drinkcat/aq-lcd-grab/firmware/README.md

# aq-lcd-grab firmware

Embassy firmware for the Raspberry Pi Pico 2 W (RP2350) — capture target for
the [display protocol reverse-engineering](../docs/display_notes.md).

Current state: PIO+DMA capture, streaming raw `(pa, pb)` samples to the
host over USB CDC using the tagged wire protocol in
[`docs/wire_protocol.md`](../docs/wire_protocol.md). On each WR rising
edge the PIO captures `{DC, CS, DB15..DB0}` (18 bits, MSB first) into
a 32 KiB DMA ring; the firmware splits each sample into
`pa = DB0..DB15` and `pb = {CS at bit 0, DC at bit 1}`, RLE-compresses
consecutive identical pairs, and ships the byte stream out. The
firmware boots quiet — send `0x01` (START) on the CDC link to begin
streaming, `0x02` (STOP) to halt.

## Toolchain setup

```sh
rustup target add thumbv8m.main-none-eabihf
sudo pacman -S picotool        # /usr/bin/picotool, v2.2.0+

# Grant picotool permission to talk to our app-mode VID/PID (c0de:cafe).
sudo install -m 0644 firmware/udev/71-aq-lcd-grab.rules /etc/udev/rules.d/
sudo udevadm control --reload-rules && sudo udevadm trigger
```

## Flashing

```sh
cargo run --release
```

That's it. The cargo runner is [`scripts/flash.sh`](scripts/flash.sh),
which:

- If the Pico is in BOOTSEL (`2e8a:000f`), just runs `picotool load`.
- If the Pico is running our firmware (`c0de:cafe`), sends a USB reset
  request via the picotool reset interface — the firmware calls
  `reset_to_usb_boot()`, the ROM re-enumerates as BOOTSEL, then we
  `picotool load`. **No button-press, no replug.**
- Otherwise, prints a hint to plug in / hold BOOTSEL.

The first-ever flash still needs a manual BOOTSEL (hold the button while
plugging in), since the picotool reset interface only exists once our
firmware is running.

## Reading the USB stream

After flashing, `/dev/ttyACM0` appears as the CDC device. The on-wire
format is binary (see [`docs/wire_protocol.md`](../docs/wire_protocol.md)),
so don't `cat` it — use the viewer in [`host/`](../host/), which speaks
the START/STOP handshake and decodes the frames.

## Pin assignment

| Pico GPIO | Function | Cable |
|---|---|---|
| 0–15 | DB0–DB15 (16-bit data bus, must be consecutive for PIO `in pins, 16`) | |
| 16 | CS | orange |
| 17 | D/C (RS) | yellow |
| 18 | WR (write strobe — sample trigger) | green |
| 22, 26–28 | spare | |
| 23, 24, 25, 29 | reserved for CYW43 wifi | |

## Notes

### Earlier flashing approach (deprecated)

We previously used `elf2uf2-rs` from git (the crates.io v2.2.0 silently
produced RP2040 UF2s that the RP2350 boot ROM rejected). `picotool` makes
that whole detour irrelevant — it speaks the BOOTSEL protocol directly and
handles family IDs internally.

### Pico 2 W onboard LED

GPIO 25 drives the onboard LED on the original Pico, but on the W variant
the user LED is wired through the CYW43 wifi chip (firmware-blob-loaded).
Use USB CDC output as the "firmware alive" signal.

### Watch your serial reader

If `cat /dev/ttyACM0` shows nothing, it's almost always because the host
opened the tty after the firmware already printed its startup messages —
the kernel doesn't buffer pre-open output. Start the reader first, then
power-cycle / re-flash the Pico.
