drinkcat/aq-lcd-grab/docs/pcb_spec.md

# Capture PCB — Design Spec

Working spec for an inline capture board: sits between the target device
main board and its LCD via two 39-pin flex connectors, taps the
display bus into an STM32F103C8T6 for capture, and hosts a Xiao
ESP32-C6 for WiFi-side processing and as the STM32's program loader.

Status: draft. Decisions captured below; open questions at the bottom.

**Capture MCU history:** the prototype was a Pico 2 W (RP2350) using
PIO + DMA. The PCB design briefly targeted a bare RP2350 in flashless
UART-boot mode, then was redrawn for STM32F030C8T6 (JLCPCB basic
library, internal flash → drops UART-boot complication), then refined
to **STM32F103C8T6** because the F103 is also JLC basic-library at
~$0.10–0.20 more, with 20 kB SRAM vs 8 kB and a Cortex-M3 vs M0 — a
material reduction in bring-up risk for the same form factor. See
"Addendum: STM32F030C8T6 considered, rejected" below.

## Overview

```
                  +-------------------+
   main board     |    Capture PCB    |     LCD
                  |                   |
        flex 39p  |  STM32F103C8T6    |  flex 39p
   ============== | passthrough + tap |==============
                  |                   |
                  |  Xiao ESP32-C6    |
                  |  (loader + WiFi)  |
                  +-------------------+
                            |
                       3-pin to main
                       board (3V3/GND/
                       PIC32 reset)
```

## Decisions

### MCU: STM32F103C8T6

- **JLCPCB basic-library part** — no extended-part assembly fee, no
  reel cost, always in stock. The primary reason for choosing STM32
  over RP2350.
- **Package:** LQFP-48, 7×7 mm body (9×9 mm with leads). Larger
  footprint than the RP2350 QFN-60, but no external SMPS inductor,
  polarised cap, or QSPI strap network is needed, so net board
  area is comparable.
- **Resources:** Cortex-M3 @ 72 MHz, 64 kB flash, **20 kB SRAM**,
  7 DMA channels, USB device, USART1 ROM bootloader on PA9/PA10.
  Pin-compatible with the F030C8T6 we briefly considered (same
  LQFP-48 pinout, same GPIO/USART/TIM1 layout for the pins we
  use).
- **Clocking:** internal HSI (8 MHz) × PLL → 64 MHz max on HSI/PLL
  (DS5319 Table 7 note 1). **No external crystal needed**: AN2606
  confirms the F103 ROM bootloader auto-bauds on HSI; we don't use
  USB (which would require HSE for the ±0.25% clock spec). HSI
  accuracy at 0–70 °C is ±1.3% to ±2% (DS5319 Table 24) — well
  within UART tolerance (~±2% per char at 8N1) at our baud rates.
- **Power:** single 3V3 rail. VDD/VDDA both 3V3 with 100 nF per pin
  + a 4.7 µF bulk near VDDA. No SMPS, no ferrite bead.

#### Addendum: STM32F030C8T6 considered, rejected

The F030C8T6 was the first STM32 picked for this board — same JLC
basic-library status, ~$0.10–0.20 cheaper. Switched to F103C8T6
because:

- **20 kB SRAM (F103) vs 8 kB (F030).** Removes the buffer-sizing
  risk that the burst-mode capture would not fit alongside an
  Embassy executor + USART buffers. Q15 resolved.
- **Cortex-M3 vs M0.** M3 has DWT cycle-counter for bring-up
  timing measurements, bit-banding, and ~1.5× the integer
  throughput at 72 MHz vs 48 MHz. Reduces the bring-up risk that
  the ISR draining the DMA ring can't keep up.
- **Ecosystem.** F103 is the most-supported STM32 in existence
  (Blue Pill heritage). Faster iteration on examples and gotchas.
- **Pin-compatible.** Same LQFP-48, same usable AFs for the pins
  we care about (PA0 TIM2_ETR, PA9/PA10 USART1, PA13/PA14 SWD).
  The pin map below transfers verbatim from the F030 draft.
- **DMA channel mapping differs** (F103 has 7 channels vs F030's
  5; TIM1_UP is on Ch5, TIM1_CH1 on Ch2, TIM1_CH2 on Ch3 — see
  Q12). USART1 conflicts shift to different channels but the
  mitigation (run TX in interrupt mode, or remap) is the same
  shape as on F030.
- **Same crystal-free clocking.** Neither chip needs HSE for our
  use case.

Net cost delta ≈ +$0.10–0.20 per board for a meaningful reduction
in bring-up risk. The earlier F030-specific text below documents
the alternative for future reference.

#### Capture path: TIM2 + multi-channel DMA from GPIOx→IDR

Replaces the RP2350 PIO + DMA-ring approach. The target's WR strobe runs
at ~667 kHz (1.5 µs period, ~500 ns low pulse) — well within F103's
DMA throughput (and was already comfortable on the F030 draft).

##### Pin constraints

Same on F103 as on F030 — both LQFP-48 STM32s land the same
peripherals on the same pins for what we use. Verified against:

- F103: DS5319 Table 5 (pin definitions) / RM0008 Table for AF.
- F030: DS024849 Tables 11/12/13 (already consulted; identical
  mapping for our pins, see addendum above).

The naive "PA0–PA15 = DB0–DB15" plan is **not viable** because:

- **PA0 = TIM2_ETR.** Need PA0 free for the capture trigger.
- **PA13/PA14 = SWDIO/SWCLK** (default reset state). Repurposing
  them removes the ability to attach an ST-Link for bring-up.
- **PA9/PA10 = USART1 default** for the ROM bootloader. AN2606
  documents PA9/PA10 as the USART1 bootloader pins for both
  F030 and F103; PA9/PA10 must stay USART1-capable for
  ESP32-driven flashing.

So PA1–PA11 are usable for data capture (with PA9/PA10 multifunction —
see below), and PA13–PA15 are reserved for SWD.

##### Pin allocation (rules, not a fixed map)

The capture path reads `GPIOA->IDR` and `GPIOB->IDR` as whole 16-bit
ports via two DMA channels — so which display-bus bit lands on which
physical pin **within a given port** is up to the router. A
permutation table on the host decoder un-shuffles them once per
captured event; cost is negligible because the decoder already
exists in software.

What must be true (hard constraints):

- **PA0 = WR** (TIM2_ETR; no remap needed — CH1_ETR multiplexed on PA0).
- **PA9 = USART1_TX, PA10 = USART1_RX**: permanent, single
  ESP32 ↔ STM32 link, used both for ROM-bootloader flashing
  (AN2606) and runtime data.
- **PA13 = SWDIO, PA14 = SWCLK**: keep for debug.
- **NRST and BOOT0** on their dedicated pins (LQFP-48 pins 7 and
  44 respectively).
- **PB2 = BOOT1 latch**: tie to GND through 10 kΩ, do not drive
  with firmware, do not use as an output.
- **DC and CS** on any free pin on either port. Both `GPIOA->IDR`
  and `GPIOB->IDR` are read every WR edge by parallel DMA channels
  (Q12), so a captured pin on either port is decodable in software.
  DC must be on PB so the PB port is self-sufficient for decoding;
  CS can be on PA.
- **Status LED** on any free pin outside the boot-strap pins.
  Convention: PC13, matching the Blue/Black Pill onboard LED so the
  same firmware blinks both dev board and PCB.

Pin assignments to fix in routing (flexible):

- **Data bus (DB0–DB15)** is split across PA and PB.
  - PA-side bits: any free pins from PA1–PA8, PA11, PA15 (excluding
    PA0/WR, PA9/PA10/USART1, PA13/PA14/SWD; PA15 needs JTAG-disabled).
  - PB-side bits: any free pins from PB0–PB15 excluding PB2 (BOOT1).
    The host permute step doesn't care which bit positions within
    `GPIOB->IDR` we use.
- The logical "DB0..DB15" identity of each pin is **defined by
  the SKiDL net names**, not by physical location. Routing can
  shuffle freely within each port (not crossing ports); the host
  decoder picks up the mapping from a single `LOGICAL_TO_PHYSICAL[16]`
  table.

Suggested starting allocation (matches the bench-rig mapping in
`firmware-stm32/README.md` exactly, so `host/src/permute.rs::permute_f103`
covers both boards; swap freely within PA or within PB — but PA0 is
fixed as WR/TIM2_ETR and must not be reassigned):

| Flex pin | Signal | STM32 pin | Notes |
|---|---|---|---|
| 2 | DB0 | PB5 | full low byte on PB — all opcodes + low colour |
| 3 | DB1 | PB6 | |
| 4 | DB2 | PB7 | |
| 5 | DB3 | PB8 | |
| 6 | DB4 | PB9 | |
| 7 | DB5 | PB10 | |
| 8 | DB6 | PB11 | |
| 9 | DB7 | PB12 | |
| 10 | DB8 (G3) | PA1 | colour-refinement, PA side |
| 11 | DB9 (G4) | PB13 | green MSB pair on PB |
| 12 | DB10 (G5) | PB14 | |
| 13 | DB11 (R0) | PA2 | colour-refinement, PA side |
| 14 | DB12 (R1) | PA3 | |
| 15 | DB13 (R2) | PA4 | |
| 16 | DB14 (R3) | PB0 | red MSB pair on PB |
| 17 | DB15 (R4) | PB1 | |
| 22 | CS | PA5 | unused in decode; PA side is fine |
| 23 | DC | PB15 | framing signal; must be on PB (self-sufficient)|
| 24 | WR | PA0 | TIM2_ETR; fixed, must not be swapped |
| — | LED | PC13 | matches Blue/Black Pill onboard LED |

The header [`firmware/src/pio_capture.rs`](../firmware/src/pio_capture.rs)
shows the prototype's bit-to-pin mapping for the Pico 2 W — it's
purely informational for the STM32 design; the host's bus decoder
([`host/src/bus_decoder.rs`](../host/src/bus_decoder.rs)) consumes
permuted samples from the per-board permutation table in
[`host/src/permute.rs`](../host/src/permute.rs) — that table is the
piece that grows an F103 entry alongside the existing Pico one.

##### Capture mechanism (2 DMA channels, F103-verified)

TIM2 in **external clock mode 2** (ECE=1 in TIM2_SMCR), clocked by
ETR (= WR on PA0 = TIM2_CH1_ETR). Both input-capture channels CC1
and CC2 point at TI1 (the same PA0 pin), so both fire on every WR
edge. Each has an independent DMA request line (CC1DE, CC2DE) in
DIER. The line-to-channel routing is in RM0008 Table 78 for F103:

| TIM2 source | DMA1 channel | Notes |
|---|---|---|
| TIM2_CH1 | Ch 5 | reads `GPIOA->IDR` → data-PA ring |
| TIM2_CH2 | Ch 7 | reads `GPIOB->IDR` → data-PB + ctrl ring |

Both channels fire on the same WR edge because both input-captures
point at TI1/PA0.

Note: TIM2_UP (Ch2) was considered but `ARR=0 + ECE + UDE` does not
reliably fire DMA on F103 (empirically verified). Dual input-capture
(CC1 + CC2 both reading TI1) sidesteps this — it triggers directly
off the input edge rather than depending on UEV.

**Ch 5 conflict:** Ch 5 is also `USART1_RX`'s default DMA channel,
and F103 has no DMA remap. Run USART1 RX interrupt-driven instead —
RX carries only sparse control messages from the ESP32 (the heavy
direction is STM32→ESP32 streaming captured bursts), so even at
1 Mbaud the ISR load is negligible.

**Hardware glitch filter free with ETR:** ETR has a built-in
digital filter (ETF[3:0] in TIM2_SMCR), so we can replicate the
RP2350 PIO's `wait 0 gpio 18 [2]` glitch-reconfirm in hardware by
setting ETF to require N consecutive samples at the new level
before propagating ETRF. The Pico 2 W firmware filtered glitches
in software ([`pio_capture.rs`](../firmware/src/pio_capture.rs)
line ~98); we get equivalent filtering for free.

**Source-vs-destination pointer convention:** with the source set
to `&GPIOx->IDR` (16-bit half-word), `PINC=0` (source no
increment), `MINC=1` (destination increment), `MEM2MEM=0`
(peripheral mode — wait for HW request), the channel waits for its
peripheral request from TIM2 and on each request copies one
half-word from `GPIOx->IDR` to the next ring slot. Wrap by setting
the destination buffer to a power-of-2-aligned span and reloading
the counter via circular mode (`CIRC=1`).
- **Why DC capture matters:** the protocol decoder uses DC as the
  command/data framing line (see
  [`host/src/bus_decoder.rs`](../host/src/bus_decoder.rs)).
  Without it, we can't tell which words are command bytes (0x2A,
  0x2B, 0x2C…) vs RGB565 pixel data. Capturing it on a second DMA
  channel is the F030 equivalent of what the RP2350 PIO did by
  shifting `{CS, DC, DB15..DB0}` into a single 18-bit FIFO entry.
- **Mechanism:** TIM2 in slave mode, clocked by ETR (WR). On every
  WR edge, TIM2 input-capture events trigger two DMA channels in
  parallel: channel A copies `GPIOA->IDR` (data bus) and channel B
  copies `GPIOB->IDR` (control bus, mask off in software) into their
  respective rings. CPU is uninvolved per-sample; firmware processes
  bursts at the boundaries detected by an idle-period timer.
- **Ring buffer sizing:** average burst is ~3,300 × 2 bytes (data) +
  ~3,300 × 2 bytes (control) ≈ 13 kB. F103's 20 kB SRAM holds a full
  burst with room for stack + USART buffers + Embassy executor, so
  whole-burst buffering is the default; mid-burst USART streaming
  is available as a fallback if any future use shifts the average
  burst higher.
- **DMA throughput risk:** ~667 kHz × 2 channels of half-word
  GPIO→SRAM transfers. At 72 MHz that's ~108 cycles per transfer pair
  — comfortable on the F103's bus matrix even with CPU active. Still
  the new front-end risk vs the RP2350 PIO prototype, so validate
  with a no-drop-counter check during bring-up.

#### Programming path: SWD + ESP32-driven UART bootloader

Both paths are wired so we can fall back if either breaks.

- **SWD header** (3-pin: SWDIO/SWCLK/GND, plus 3V3 from board) on
  PA13/PA14. Drives bring-up with an ST-Link or Pi Pico probe.
  Standard 1.27 mm pitch SWD or 2.54 mm DIP header — decide at
  layout time based on board space.
- **ESP32 UART bootloader path:** ESP32 drives `BOOT0` high and
  pulses `NRST`, then talks to USART1 on PA9 (RX) / PA10 (TX) at
  up to 115200 baud. BOOT0 line and NRST line from ESP32 GPIOs.
  Pull-down on BOOT0 so normal boots run user flash.
- **No QSPI strap network, no UART-boot SRAM-image dance, no 6 s
  boot latency.** Firmware lives in STM32 internal flash and
  persists across power cycles.

##### Firmware-skew risk and how we manage it

With the STM32 holding its own firmware in internal flash,
RP2350's "single source of truth" property is lost. Mitigations:

- ESP32 stores the canonical STM32 firmware image alongside its
  own in a dedicated partition.
- On boot, ESP32 reads STM32 version (over runtime UART — see
  below) and reflashes via the bootloader path if it doesn't
  match.
- This is the same OTA pattern as the RP2350 plan, just with
  STM32-bootloader semantics instead of bootrom UART boot.

#### Runtime UART (after firmware boots)

- USART1 (PA9/PA10) doubles as the runtime ESP32 ↔ STM32 link, same
  pins as the bootloader. No re-muxing required (unlike the RP2350
  plan which switched from QSPI bootrom UART to PL011 F11 mux).
- Baud rate negotiable between firmwares; default 115200 or higher.

### Power: tap target 3V3 rail

- Single 3V3 rail powers the whole capture board (STM32 + Xiao C6).
- Backfed into Xiao C6 3V3 pin, which bypasses its onboard LDO. This
  means the Xiao cannot be powered from its own USB-C while the
  capture PCB is connected to the target.
- **To reflash the ESP32 standalone:** disconnect the 3V3 pin in the
  3-wire connector to the main board so the Xiao can run from
  its own USB-C without back-driving the rail.
- **Risk to validate:** Xiao C6 WiFi TX pulls 200–300 mA peaks. Target
  3V3 must source that on top of the display backlight load. Measure
  the target 3V3 headroom before committing.
- **Fallback if 3V3 headroom is insufficient:** a 2-pin 2.54 mm header
  (J4, unpopulated by default) lets us feed target 5V into the Xiao
  USB-C VBUS net, so the Xiao's onboard LDO regenerates 3V3 locally
  instead of leaning on the target 3V3 rail. Don't have both Xiao
  USB-C and the J4 tap live at the same time without an OR'ing
  scheme — they'd fight on the +5V rail.

#### Decoupling

STM32 local decoupling per AN2586 §2.2
([`reference/STM32F103/an2586_hardware_development.pdf`](../reference/STM32F103/an2586_hardware_development.pdf)):

| Rail | Caps |
|---|---|
| VDD (×3 on LQFP-48) | 100 nF per pin + 1× 4.7 µF bulk |
| VDDA | 100 nF + 1 µF |
| VBAT (no battery) | tied to VDD via 100 nF |

VREF+ is not bonded out on the F103C8 LQFP-48 package (DS5319
Table 5 — only on LFBGA100 / TFBGA64); no external decoupling
needed.

Plus 22 µF + 100 µF bulk near the Xiao 3V3 pad to absorb WiFi TX
transients locally rather than burdening the target regulator's
transient response (see Q6 mitigation).

### Connection to main board

- 3-pin connector on the capture PCB: 3V3 (power tap), GND, PIC32
  reset. The target main board exposes a 5-pin header but we only
  need these three.
- PIC32 reset is open-drain with pull-up on the main board (confirmed
  by user from prior project).
- ESP32 drives it open-drain: GPIO as input = released, GPIO low =
  asserted. **Never drive high.**

### Display capture tap

- Two 39-pin flex connectors, board sits inline (man-in-the-middle):
  most signals pass straight through, capture-relevant signals also
  fan out to STM32 GPIOs.
- Capture mechanism on STM32: WR drives TIM2_ETR (PA0); per-edge DMA reads
  of `GPIOA->IDR` and `GPIOB->IDR` into two ring buffers. Data bus,
  DC, and CS are all captured (DC/CS are on PB pins along with the
  data-PB byte). See "Capture mechanism" under MCU above for the
  TIM1 + DMA register details.
- Reference: the Pico 2 W prototype (RP2350 PIO + DMA) validated the
  display-side decode against live 0x2A/0x2B/0x2C + RGB565 traffic
  from an ILI9488/ST7796-compatible controller — see
  [display_notes.md](display_notes.md). The protocol/decode work
  carries over verbatim; only the capture front-end is being re-done
  for the STM32.

### Flex GND tie

The display flex carries three pins suspected to be GND on the
target side (J2 pins 1, 18, 19 — labels `GND_1`, `GND_18`, `GND_19`
in the SKiDL netlist). They are kept as separate nets at the
schematic level because the target flex pinout is partly guessed
and shorting two non-GND pins together would be hard to undo.

Each one is tied to board GND through a **dedicated 0402 0 Ω
jumper** on the top side near the flex connectors. **Populated at
fab time by default** — matches the "prior project validated the
target pinout" baseline and skips a per-board hand-solder step.

Bring-up:
1. Boards arrive with all three 0 Ωs populated.
2. Before plugging into the target, scope each suspected-GND pin
   against board GND while the target is alone-powered, confirming
   it's at 0 V.
3. If any pin shows a non-zero signal, depopulate that 0 Ω with
   hot air.

### Status LED

- One LED on an STM32 GPIO + current-limit resistor (0603 LED + 0603
  ~1 kΩ, both basic-library parts on JLCPCB — adds ~$0.02/board).
- ESP32 status is covered by the Xiao's onboard user LED (GPIO 15), so
  no additional LED needed on the ESP32 side.
- Purpose of the STM32-side LED: independent "STM32 is alive"
  feedback during bring-up — confirms the firmware booted from flash
  and code is running even when the ESP32-side comms path is suspect.

### Bring-up test points

- **General-purpose test points** on free STM32 GPIOs PB3, PB4, PA6
  (PB3/PB4 are JTAG outputs at reset — need `SWJ_CFG=010` — and PA6
  is a plain free GPIO).
- All exposed as small SMD pads at the board edge; no headers needed.

## ESP32-C6 (Xiao) resources

- **Flash:** 4 MB onboard
- **SRAM:** 512 kB
- **GPIO:** ~11 on castellated edges

Flash budget (rough): ~1.5 MB ESP32 app+WiFi, ~1.5 MB OTA mirror,
~64 kB to hold the STM32 firmware image, ~0.5 MB NVS/filesystem.
Fits in 4 MB with OTA; very comfortable now that the STM32 image
is small (was ~50 kB+ for RP2350; STM32 64 kB cap is the upper bound).

### Pin budget

| Function | Direction | Notes |
|---|---|---|
| UART TX → STM32 PA10 | OUT | Bootloader + runtime, 115200+ |
| UART RX ← STM32 PA9 | IN | Bootloader + runtime |
| STM32 NRST | OD/OUT | Pulse low to reset |
| STM32 BOOT0 | OUT | High → enter ROM bootloader |
| PIC32 reset | OD | Input=released, low=asserted |
| Free | | ~5–6 GPIO unallocated |

## STM32F103C8T6 pin budget

48 pins on LQFP-48; ~37 I/O after subtracting power, ground, NRST,
BOOT0, and the OSC pins (PD0/PD1 on F103, PF0/PF1 on F030 — both
LQFP-48 packages expose them as alternates). Verified against
[`reference/STM32F103/datasheet.pdf`](../reference/STM32F103/datasheet.pdf)
Table 5 (and identical for our pins in the F030 datasheet
[`reference/STM32F030/datasheet.pdf`](../reference/STM32F030/datasheet.pdf)
Table 11).

### Fixed pins (forced by silicon or boot)

| Function | Pin | LQFP-48 # | Constraint |
|---|---|---|---|
| WR (TIM2_ETR) | PA0 | 10 | TIM2 CH1_ETR on PA0; same pin as bench rig (no remap needed). |
| USART1 RX (boot + runtime) | PA10 | 31 | ROM bootloader pin (AN2606), no DMA remap. |
| USART1 TX (boot + runtime) | PA9 | 30 | ROM bootloader pin (AN2606), no DMA remap. |
| SWDIO | PA13 | 34 | Debug; firmware AFIO `SWJ_CFG=010` to keep SWD and disable JTAG. |
| SWCLK | PA14 | 37 | Same. |
| NRST | NRST | 7 | ESP32 drives open-drain; AN2586 §2.3.3 100 nF to GND for EMS. |
| BOOT0 | BOOT0  | 44 | ESP32 drives push-pull; 10 kΩ pull-down per AN2586 Fig 10. |
| BOOT1 | PB2 | 20 | 10 kΩ pull-down to GND; not driven by firmware, never used as I/O. |

### Floating pins (chosen at routing time)

The capture path reads `GPIOA->IDR` and `GPIOB->IDR` as whole 16-bit
ports, so the *logical* DB0–DB15 identity of a pin is whichever
SKiDL net the schematic ties to it — the host decoder applies a
`LOGICAL_TO_PHYSICAL[16]` permutation when framing events.
Within each port, route whatever pin order is convenient.

| Function | Allowed pin pool |
|---|---|
| Data bus PA-half | Any free pins from PA1–PA8, PA11, PA15. PA15 needs JTAG-disabled. |
| Data bus PB-half | Any free pins from PB0–PB15 except PB2 (BOOT1). |
| DC | Any free PB pin (keep on PB for self-sufficient decode). |
| CS | Any free pin on either port. |
| Status LED | Any free pin outside the boot-strap rails. |

Free pool after the suggested allocation above:
PA6, PA7, PA8, PA11, PA12, PA15 (JTDI — JTAG disable required),
PB3 (JTDO — likewise), PB4 (NJTRST — likewise),
PD0/PD1 (OSC; usable as GPIO when no crystal is fitted).
Plenty of test-point and future-bodge headroom.

## v1 errata

### WR and CS swapped on flex pins 22/24

v1 (commit `8a466f4`, silkscreen `v1`) routes flex pin 22 to PA0 and
pin 24 to PA5. The SKiDL pin map was written from the early *probed*
pinout (22 = WR, 24 = CS) and was never updated after
[display_notes.md](display_notes.md) was matched against the module
datasheet, which has **22 = CS, 24 = WR**. On v1, PA0 (TIM2_ETR) is
therefore clocked by CS, not WR, and capture doesn't work.

**Rework on built v1 boards:** a bodge wire from the J2 pad
silkscreened *CS* (pin 24, which actually carries WR) straight to STM32
PA0 (U1 pin 10). This works because CS is unused in decoding.

**Fixed in v2:** pins 22/24 swapped in `FLEX_PIN_LABELS` in
[`pcb/aq_lcd_grab.py`](../pcb/aq_lcd_grab.py), with PA0/PA5 re-routed.
Firmware and host mapping are unchanged (PA0 = WR, PA5 = CS on both).

## Open questions

These need answers before schematic. Tackle them in roughly this order;
items earlier in the list block later ones.

### Q10. JLCPCB BOM cost review — every part, not just the flex

Originally just about the flex connector, but JLCPCB shuffles parts
between basic and extended libraries frequently and "extended" adds
both a per-part assembly fee and a reel cost. Worth a sweep over
the whole BOM before submission. Goal: every active part either in
basic, or consciously accepted as extended.

Method: for each part below, look up the current JLCPCB part number
(search the value + footprint on jlcpcb.com/parts), note basic vs
extended, and pick a basic-library substitute where one exists with
a compatible footprint. **Footprint compatibility matters more than
exact part number** — if a cheaper part has the same pad layout
(pitch, lead-out direction, height) we can swap parts without
redesigning.

Current BOM (SMD parts assembled by JLC; through-hole and modules are
hand-soldered and have no assembly-library concern):

| Ref | Part / value | Qty | Footprint | JLCPCB status |
|---|---|---|---|---|
| J1, J2 | FH26W-39S-0.3SHW(60) flex | 2 | custom | TBD — check current status; Molex 502598 / JST equivalents if extended |
| U1 | STM32F103C8T6 | 1 | LQFP-48 | Basic last checked; reconfirm |
| C1–C5, C8 | 100 nF X7R | 6 | 0402 | Should be basic |
| C6 | 1 µF X5R/X7R ≥6.3 V | 1 | 0402 | Should be basic |
| C7 | 4.7 µF X5R/X7R ≥6.3 V | 1 | 0402 | Should be basic |
| C10 | 22 µF ≥6.3 V | 1 | 0805 | Likely basic |
| C11 | 100 µF ≥6.3 V | 1 | 1206 | Verify basic-library status before submission |
| R1, R2 | 10 kΩ | 2 | 0402 | Basic |
| R3 | 1 kΩ | 1 | 0402 | Basic |
| R10–R18 | 0 Ω jumper | 9 | 0402 | Basic; any in-stock part |
| D1 | KT-0603R | 1 | 0603 | Verify basic-library status before submission |
| J3, J5 | 1×3 header 2.54 mm | 2 | through-hole | Hand-soldered; N/A |
| J4 | 1×2 header 2.54 mm | 1 | through-hole | Hand-soldered; N/A |
| H1–H4 | Tooling hole | 4 | 1.152 mm | Exclude from BOM; place at board corners |
| TP1–TP3 | Test point | 3 | 0.5×0.5 mm pad | Exclude from BOM |
| U2 | Xiao ESP32-C6 module | 1 | castellated | Hand-soldered; N/A |

Before submission: confirm JLCPCB part number + basic/extended + unit
price for each SMD row. If extended-parts surcharge exceeds ~$5–10 per
run, swap the offending part for a basic-library equivalent.

### Q6. target 3V3 headroom

Need to confirm there's at least ~400 mA spare on the target 3V3 rail
for Xiao C6 WiFi peaks + STM32 (~30 mA active at 72 MHz) without
browning out the display or the PIC32.

Blocking risk: if there's not enough headroom, fall back to the
5V tap header (J4) and let the Xiao's onboard LDO regenerate 3V3
locally — see "Power: tap target 3V3 rail" → "Fallback".

**Validation procedure** (do in this order, stop when confident):

1. **Identify the target 3V3 regulator.** Find the part on the main
   board, look up its rated output current. If it's rated ≥1 A and the
   target's own 3V3 load is modest (a few hundred mA typical for an
   LCD-driven sensor device), there's likely headroom. If it's a small
   SOT-23 LDO rated ≤300 mA, expect trouble.
2. **Bench supply substitution smoke test.** Power the target from a
   bench supply at its normal input voltage, current-limited to
   (expected target draw + ~400 mA budget for capture PCB). Verify
   normal operation with backlight on. Repeats #1 less precisely but
   tells you whether the *whole device* has total-system headroom even
   if you can't identify the regulator.
3. **Inline shunt measurement** (the definitive answer):
   - Splice a 0.1 Ω shunt into the 3V3 wire of the 3-pin connector.
   - Measure voltage across it with a scope (DMM averages down the
     short WiFi TX peaks; not useful for transient measurement).
   - Take three readings:
     - target alone, idle — baseline.
     - + capture PCB powered, ESP32 idle — quiescent overhead.
     - + ESP32 actively WiFi TX-ing (run a tight `WiFi.begin()` +
       HTTP POST loop) — worst case.
   - Headroom = regulator rated current − (target baseline +
     measured peak).

**Mitigation regardless of result:** add bulk capacitance at the 3V3
input of the capture PCB (22 µF + 100 µF MLCC/tantalum is reasonable)
near the Xiao 3V3 pin, to absorb WiFi TX transients locally rather
than burdening the target regulator's transient response. The Xiao
module has its own onboard decoupling sized for normal USB-powered
operation, but when 3V3 is backfed externally that decoupling is
upstream of our tap point and we shouldn't rely on it alone.

### Q7b. STM32F103 design-guide compliance — RESOLVED

AN2586 in
[`reference/STM32F103/an2586_hardware_development.pdf`](../reference/STM32F103/an2586_hardware_development.pdf)
and RM0008 in
[`reference/STM32F103/rm0008.pdf`](../reference/STM32F103/rm0008.pdf):

- **Reset (NRST):** internal pull-up; AN2586 §2.3.3 recommends a
  pull-down capacitor 10–100 nF to GND for EMS — improves
  protection against parasitic resets. ESP32 drives NRST
  open-drain.
- **BOOT0:** dedicated pin on F103C8 LQFP-48 (pin 44). Pull-down
  to GND with a 10 kΩ resistor (AN2586 Figure 10) so it stays
  low unless the ESP32 actively drives it high. ESP32 drives
  push-pull.
- **PB2 = BOOT1:** F103 has an additional boot-select pin
  (BOOT1) which is muxed with PB2. Latched together with BOOT0
  on the 4th rising SYSCLK edge after reset (AN2586 §4.1). For
  our boot modes (main flash + system memory bootloader) we
  always want **BOOT1=0**. PB2 therefore needs a **10 kΩ
  pull-down to GND** on the board so the boot latch reads 0
  unambiguously even before firmware has configured the pin.
  **PB2 must not be used as a status LED with active-high
  drive**, since that would force BOOT1=1 during reset. Moved
  the status LED to a different pin (see updated pin budget).
- **No external crystal needed**: HSI + PLL → 64 MHz max
  (DS5319 Table 7 note 1). HSI accuracy at 0–70 °C is ±1.3% to
  ±2% (DS5319 Table 24), within UART tolerance at the baud
  rates we use. F103 ROM bootloader auto-bauds on HSI (AN2606).
- **Optional improvement:** if USART1 bootloader timing turns
  out flaky in practice across the temperature range, add an
  8 MHz crystal on OSC_IN/OSC_OUT (PD0/PD1 on F103 LQFP-48) and
  switch HSE + PLL → 72 MHz. Leave a depopulated 3225 crystal
  footprint + 18 pF cap pads as insurance.
- **JTAG vs SWD:** F103 boots with JTAG enabled on PA13–PA15 +
  PB3 + PB4. To free PB3/PB4/PA15 as plain GPIOs while keeping
  SWD on PA13/PA14, firmware must write
  `AFIO_MAPR.SWJ_CFG=010` (JTAG-DP disabled, SW-DP enabled)
  early in startup. None of those pins carry a DB bit in our
  current map, but if we later need PA15/PB3/PB4 as plain GPIO
  inputs/outputs the JTAG-disable step is mandatory.

### Q15. Embassy STM32F1 support — **DONE**

Confirmed working in `firmware-stm32`: `embassy-stm32` on F103C8 with
GPIO + DMA, TIM2 ETR slave mode, and two DMA channels driven from the
same timer event (via PAC-level register access). SRAM headroom
non-issue at 20 kB.

### Q17. Host-side bit-permutation table — **DONE**

Routing is final; permutation table implemented in
[`host/src/permute.rs`](../host/src/permute.rs) (`permute_f103`),
derived directly from the `CAPTURE_TAP` table in `aq_lcd_grab.py`.
The same table covers both the bench-rig (Blue Pill) and the PCB.

### Q21. PIC32 reset — move to STM32 + power-on hold-low — **DONE**

**(a)** STM32 PA11 (pad 32) added as a second open-drain MCLR driver
via 0 Ω jumper R16; ESP32 GPIO20 path retained via R15. Either jumper
can be broken to isolate that driver.

**(b)** Power-on hold-low implemented in firmware: STM32 asserts MCLR
low on boot and holds it until the capture DMA is armed.

## References

Primary (current MCU — F103C8T6):
- STM32F103x8/xB datasheet (DS5319) —
  [`reference/STM32F103/datasheet.pdf`](../reference/STM32F103/datasheet.pdf)
- STM32F10xxx RM0008 reference manual —
  [`reference/STM32F103/rm0008.pdf`](../reference/STM32F103/rm0008.pdf)
- AN2586 — Getting started with STM32F10xxx hardware development —
  [`reference/STM32F103/an2586_hardware_development.pdf`](../reference/STM32F103/an2586_hardware_development.pdf)

Common (apply to both F030 and F103):
- AN2606 — STM32 microcontroller system memory boot mode (USART1
  bootloader on PA9/PA10) —
  [`reference/an2606_bootloader.pdf`](../reference/an2606_bootloader.pdf)

Secondary (F030C8T6 alternative, kept for reasoning context):
- STM32F030C8 datasheet —
  [`reference/STM32F030/datasheet.pdf`](../reference/STM32F030/datasheet.pdf)
- STM32F0 RM0360 reference manual —
  [`reference/STM32F030/rm0360.pdf`](../reference/STM32F030/rm0360.pdf)

Project artefacts:
- [display_notes.md](display_notes.md) — captured protocol details
- RP2350 prototype firmware (PIO+DMA capture front-end):
  [`firmware/src/pio_capture.rs`](../firmware/src/pio_capture.rs).
  Bus-protocol decode lives host-side now in
  [`host/src/bus_decoder.rs`](../host/src/bus_decoder.rs).
