drinkcat/aq-lcd-grab/pcb/aq_lcd_grab.kicad_pcb

## KiCad design pcb/aq_lcd_grab.kicad_pcb (2026-09-30)

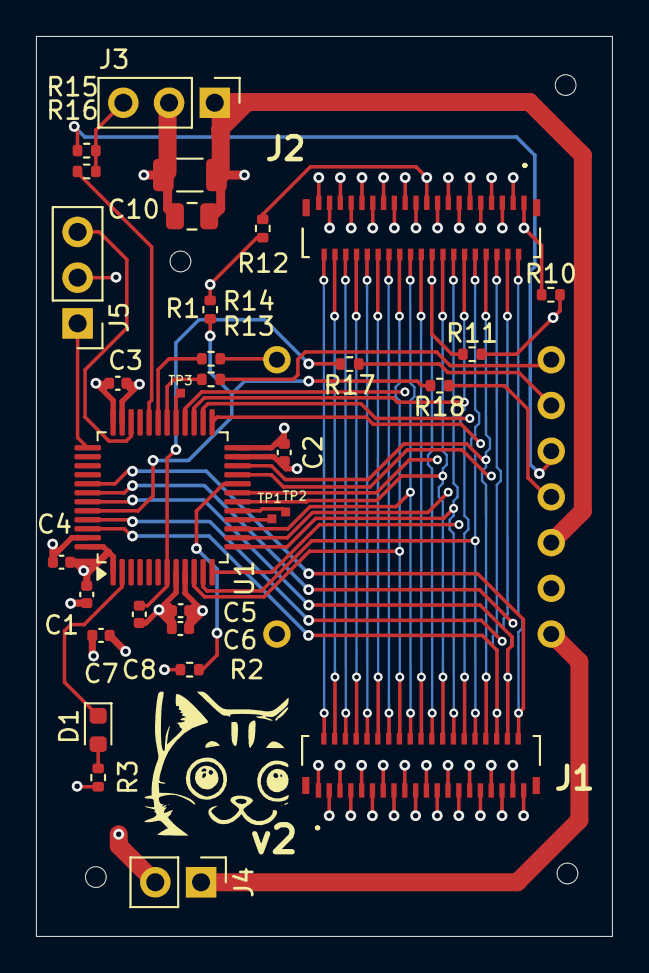
[picture p1: board aq_lcd_grab.kicad_pcb from above]

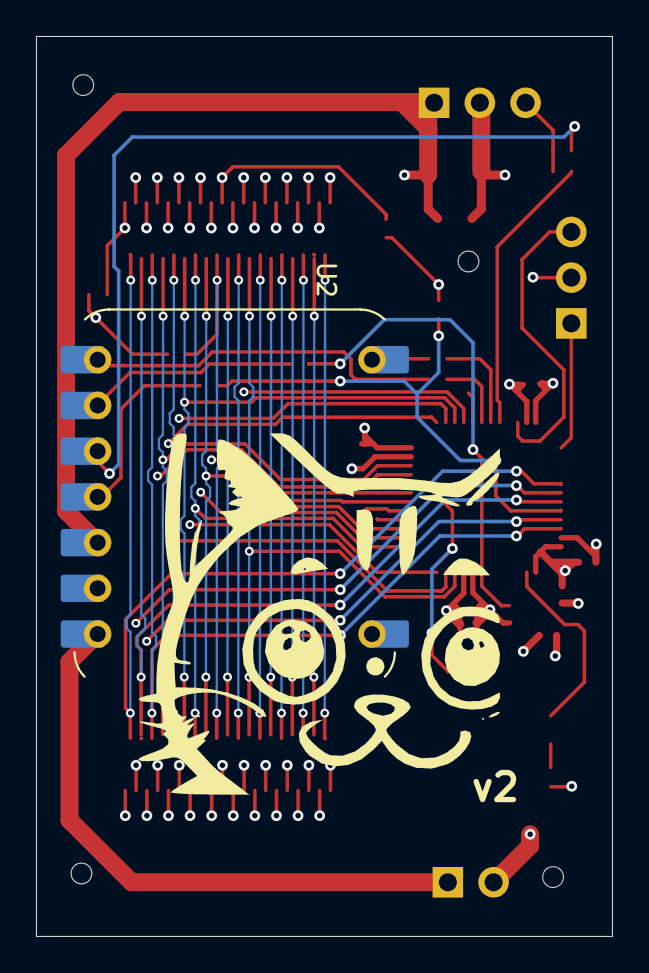
[picture p2: board aq_lcd_grab.kicad_pcb from below]

Board: 4 copper layers, 32.0 x 50.0 mm, 39 parts (2 on the bottom side), 61 nets.

Parts:
C1, C2, C3, C4, C5, C8: 100n; C_0402_1005Metric
C6: 1u; C_0402_1005Metric
C7: 4.7u; C_0402_1005Metric
C10: 22u; C_0805_2012Metric
C11: 100u; C_1206_3216Metric
D1: KT-0603R; LED_0603_1608Metric
H1, H2, H3, H4: ToolingHole; ToolingHole_1.152mm
J1, J2: FH26W-39S-0.3SHW(60); FH26W39S03SHW60
J3: Conn_01x03_Socket; PinHeader_1x03_P2.54mm_Vertical
J4: Conn_01x02_Socket; PinHeader_1x02_P2.54mm_Vertical
J5: Conn_01x03_Pin; PinHeader_1x03_P2.54mm_Vertical
R1, R2: 10k; R_0402_1005Metric
R3: 1k; R_0402_1005Metric
R10, R11, R12, R13, R14, R15, R16, R17, R18: 0; R_0402_1005Metric
TP1, TP2, TP3: TestPoint; TestPoint_Pad_0.5x0.5mm
U1: STM32F103C8T6; LQFP-48_7x7mm_P0.5mm
U2: Conn_01x14; XIAO-ESP32-C6-DIP
v2: LOGO; logo-8mm
v2#2: LOGO; logo-2cm

Connections:
+3V3: C1.1, C2.1, C3.1, C4.1, C5.1, C6.1, C7.1, C10.1, C11.1, J3.1, R3.1, U1.1, U1.9, U1.24, U1.36, U1.48, U2.12
+5V: J4.1, U2.14
BOOT0: R1.1, R18.2, U1.44
BOOT0_ESP: R18.1, U2.11
BOOT1: R2.1, U1.20
CS: J1.18, J2.22, U1.15
DB0: J1.38, J2.2, U1.41
DB1: J1.37, J2.3, U1.42
DB2: J1.36, J2.4, U1.43
DB3: J1.35, J2.5, U1.45
DB4: J1.34, J2.6, U1.46
DB5: J1.33, J2.7, U1.21
DB6: J1.32, J2.8, U1.22
DB7: J1.31, J2.9, U1.25
DB8: J1.30, J2.10, U1.11
DB9: J1.29, J2.11, U1.26
DB10: J1.28, J2.12, U1.27
DB11: J1.27, J2.13, U1.12
DB12: J1.26, J2.14, U1.13
DB13: J1.25, J2.15, U1.14
DB14: J1.24, J2.16, U1.18
DB15: J1.23, J2.17, U1.19
DC: J1.17, J2.23, U1.28
GND: C1.2, C2.2, C3.2, C4.2, C5.2, C6.2, C7.2, C8.2, C10.2, C11.2, J3.2, J4.2, J5.2, R1.2, R2.2, R10.2, R11.2, R12.2, U1.8, U1.23, U1.35, U1.47, U2.13
GND_1: J1.39, J2.1, R10.1
GND_18: J1.22, J2.18, R11.1
GND_19: J1.21, J2.19, R12.1
LED_STATUS: D1.1, U1.2
unnamed: D1.2, R3.2
NRST: C8.1, R17.2, U1.7
NRST_ESP: R17.1, U2.9
P20_RD: J1.20, J2.20
P21: J1.19, J2.21
P25: J1.15, J2.25
P26: J1.14, J2.26
P27: J1.13, J2.27
P28: J1.12, J2.28
P29: J1.11, J2.29
P30: J1.10, J2.30
P31: J1.9, J2.31
P32: J1.8, J2.32
P34: J1.6, J2.34
P38: J1.2, J2.38
P39: J1.1, J2.39
PA6: TP1.1, U1.16
PA7: TP2.1, U1.17
PA8: TP3.1, U1.29
PIC32_RESET: J3.3, R15.2, R16.2
PIC32_RST_ESP: R15.1, U2.10
PIC32_RST_STM: R16.1, U1.32
SWCLK: J5.1, U1.37
SWDIO: J5.3, U1.34
UART_ESP_RX: R13.2, U2.8
UART_ESP_TX: R14.2, U2.7
UART_STM_RX: R14.1, U1.31
UART_STM_TX: R13.1, U1.30
VCC_33: J1.7, J2.33
VCC_35: J1.5, J2.35
VCC_36: J1.4, J2.36
VCC_37: J1.3, J2.37
WR: J1.16, J2.24, U1.10
