drinkcat/aq-lcd-grab/firmware-stm32/src/main.rs

#![no_std]
#![no_main]

mod capture;
mod uart;

use embassy_executor::Spawner;
use embassy_stm32::Config;
use embassy_stm32::gpio::{Level, Output, OutputOpenDrain, Speed};
use embassy_sync::blocking_mutex::raw::ThreadModeRawMutex;
use embassy_sync::channel::Channel;
use panic_halt as _;

use capture::{Capture, CapturePins, RING_CAP};
use uart::UartSink;
use wire::{Encoder, HOST_CMD_START, HOST_CMD_STATS, HOST_CMD_STOP};

/// Commands from RX task to capture task. The protocol mandates an ack
/// for every START/STOP — even when it's a no-op for the current
/// state — so we route each command through a FIFO instead of a
/// one-slot Signal. 8 slots is plenty: commands are rare and the
/// capture task drains them every polling tick.
type CmdQueue = Channel<ThreadModeRawMutex, HostCmd, 8>;
static CMD_QUEUE: CmdQueue = Channel::new();

/// Shared "we are streaming" flag for the LED task. Updated by the
/// capture task on state transitions; only read by the LED.
static STREAMING: core::sync::atomic::AtomicBool = core::sync::atomic::AtomicBool::new(false);

#[derive(Copy, Clone, PartialEq, Eq)]
enum StreamState {
    Stopped,
    Streaming,
}

#[derive(Copy, Clone, PartialEq, Eq)]
enum HostCmd {
    Start,
    Stop,
    Stats,
}

/// Capture ring lengths. 4096 half-words = 8 KiB per ring = 16 KiB
/// total. At 667 kHz peak, 4096 samples ≈ 6 ms of headroom for the
/// drain task to keep up. Can't go higher: F103C8 has 20 KiB SRAM
/// total and we still need UART_TX_BUF + stack + .bss.
/// `Capture::fast_drain` hardcodes the modulus mask to RING_CAP, so
/// these statics must match it.
static mut PA_BUF: [u16; RING_CAP] = [0; RING_CAP];
static mut PB_BUF: [u16; RING_CAP] = [0; RING_CAP];

/// Drain chunk: how many paired samples we pull from the rings per
/// poll. Small enough to keep latency tight, large enough to amortise
/// the rings's `read()` overhead.
const DRAIN_CHUNK: usize = 128;

#[embassy_executor::main]
async fn main(_spawner: Spawner) {
    // 64 MHz from HSI+PLL, per pcb_spec.md "Clocking". F1 HSI->PLL is
    // hardwired /2 — embassy-stm32 hard-panics if prediv != DIV2.
    let mut config = Config::default();
    {
        use embassy_stm32::rcc::*;
        config.rcc.hse = None;
        config.rcc.pll = Some(Pll {
            src: PllSource::HSI,
            prediv: PllPreDiv::DIV2,
            mul: PllMul::MUL16,
        });
        config.rcc.sys = Sysclk::PLL1_P;
        config.rcc.ahb_pre = AHBPrescaler::DIV1;
        config.rcc.apb1_pre = APBPrescaler::DIV2; // APB1 max 36 MHz
        config.rcc.apb2_pre = APBPrescaler::DIV1;
    }
    let p = embassy_stm32::init(config);

    // PC13 LED — slow blink in STOPPED, fast in STREAMING.
    let mut led = Output::new(p.PC13, Level::High, Speed::Low);

    // PIC32 reset driver on PA11 (→ R16 0Ω jumper → PIC32 MCLR). The net is
    // open-drain with a pull-up on the target main board, so we MUST use
    // open-drain: Level::Low actively asserts reset; Level::High releases
    // to high-Z and the main board's pull-up brings MCLR high.
    //
    // Held LOW at boot / while STOPPED → PIC32 parked in reset. Released on
    // START → PIC32 boots and runs its full init (incl. the screen-clear
    // fill) AFTER we're already streaming, so the init lands inside the
    // capture window every session.
    let mut pic32_rst = OutputOpenDrain::new(p.PA11, Level::Low, Speed::Low);

    // USART1 TX/RX transport (see uart.rs): DMA-driven TX sink + polled
    // RX for host commands.
    let mut sink = UartSink::new(p.USART1, p.PA9, p.PA10, p.DMA1_CH4);

    // Capture front-end — TIM1 ETR + 2 DMA rings.
    let (pa_buf, pb_buf) = unsafe {
        (
            &mut *core::ptr::addr_of_mut!(PA_BUF),
            &mut *core::ptr::addr_of_mut!(PB_BUF),
        )
    };
    // Every wired data/control pin (see permute_f103 / README routing).
    // Type-erased to AnyPin; Capture::new configures each as a floating
    // input so undriven pins don't float and corrupt the IDR reads.
    let data_pins = [
        // GPIOA: PA1=DB8, PA2..4=DB11..13, PA5=CS
        p.PA1.into(),
        p.PA2.into(),
        p.PA3.into(),
        p.PA4.into(),
        p.PA5.into(),
        // GPIOB: PB0..1=DB14..15, PB5..12=DB0..7, PB13..14=DB9..10, PB15=DC
        p.PB0.into(),
        p.PB1.into(),
        p.PB5.into(),
        p.PB6.into(),
        p.PB7.into(),
        p.PB8.into(),
        p.PB9.into(),
        p.PB10.into(),
        p.PB11.into(),
        p.PB12.into(),
        p.PB13.into(),
        p.PB14.into(),
        p.PB15.into(),
    ];
    let mut capture = Capture::new(
        p.TIM2,
        CapturePins {
            wr_etr: p.PA0,
            data: data_pins,
        },
        p.DMA1_CH5, // TIM2_CH1 (input capture on TI1) -> PA ring
        p.DMA1_CH7, // TIM2_CH2 (input capture on TI1, alt) -> PB ring
        pa_buf,
        pb_buf,
    );

    let mut encoder = Encoder::default();
    encoder.log(
        "aq-lcd-grab stm32 firmware booted, awaiting START",
        &mut sink,
    );

    // Boot STOPPED: the host drives START/STOP over the control path
    // (polled from RXNE in the cap loop below).
    let mut state = StreamState::Stopped;
    let cap_fut = async {
        let mut samples = [0u32; DRAIN_CHUNK];
        // Time-based (not loop-tick-based) cadence for the periodic
        // diagnostic emits below — the cap loop's iteration rate
        // depends on DMA progress, so iteration counts aren't a
        // reliable clock.
        let mut last_idle_log = embassy_time::Instant::now();
        // Auto-emit a STATS log line every ~5 s while streaming, so
        // the host's run.log carries a trail of cap_dropped counters
        // even under sustained traffic (where the idle-tick heartbeat
        // below never fires).
        let mut last_stats = embassy_time::Instant::now();
        // DMA transfer-error event counters. take_dma_teif clears
        // the hardware flags each call, so these are cumulative
        // "events seen" counts since boot. Non-zero means a DMA
        // request was lost mid-burst (AHB error) → samples missing.
        let mut pa_teif_count: u32 = 0;
        let mut pb_teif_count: u32 = 0;
        loop {
            // Poll for host command bytes (rare, latency-tolerant — see
            // uart.rs for why RX is polled rather than interrupt-driven).
            while let Some(b) = sink.poll_rx() {
                let cmd = match b {
                    HOST_CMD_START => Some(HostCmd::Start),
                    HOST_CMD_STOP => Some(HostCmd::Stop),
                    HOST_CMD_STATS => Some(HostCmd::Stats),
                    _ => None, // unknown byte, ignore
                };
                if let Some(cmd) = cmd {
                    let _ = CMD_QUEUE.try_send(cmd);
                }
            }

            // Drain all pending host commands. Every START/STOP gets an
            // ack even when it's a no-op for the current state — the
            // host's sync handshake assumes STOP always produces FC.
            while let Ok(cmd) = CMD_QUEUE.try_receive() {
                match cmd {
                    HostCmd::Start => {
                        if state == StreamState::Stopped {
                            encoder.reset();
                            state = StreamState::Streaming;
                            STREAMING.store(true, core::sync::atomic::Ordering::Relaxed);
                            // Release PIC32 reset AFTER streaming is live (the
                            // capture DMA is armed continuously since boot), so
                            // the PIC32's init writes — including the
                            // screen-clear fill — land inside the capture
                            // window. Open-drain high = high-Z, main-board
                            // pull-up brings MCLR high.
                            pic32_rst.set_high();
                        }
                        encoder.started(&mut sink);
                    }
                    HostCmd::Stop => {
                        if state == StreamState::Streaming {
                            encoder.flush(&mut sink);
                            state = StreamState::Stopped;
                            STREAMING.store(false, core::sync::atomic::Ordering::Relaxed);
                        }
                        // Park the PIC32 in reset whenever stopped (also on a
                        // redundant STOP), so the next START always yields a
                        // clean power-on init sequence.
                        pic32_rst.set_low();
                        encoder.stopped(&mut sink);
                    }
                    HostCmd::Stats => {
                        let mut buf = [0u8; 96];
                        let msg = fmt_stats(
                            &mut buf,
                            capture.peek_dropped_total(),
                            pa_teif_count,
                            pb_teif_count,
                        );
                        encoder.log(msg, &mut sink);
                    }
                }
            }

            // Wait until DMA has at least one paired sample (or a
            // 10 ms housekeeping timeout). `read_available` wakes on
            // the DMA half-/full-transfer IRQ and drains whatever's
            // there into packed u32 samples — no fixed batch wait.
            // While we wait, the executor parks us and runs LED/RX.
            //
            // On timeout, still do a sync `fast_drain` — samples may
            // have landed in the rings but not yet crossed the
            // N/2 wake mark. The IRQ won't fire for them; only a
            // direct ring read can pick them up.
            let mut n = match embassy_futures::select::select(
                capture.read_available(&mut samples),
                embassy_time::Timer::after_millis(10),
            )
            .await
            {
                embassy_futures::select::Either::First(n) => n,
                embassy_futures::select::Either::Second(_) => capture.fast_drain(&mut samples),
            };

            // In STOPPED state, nothing to capture. Clear accumulated
            // drops, kick the TX DMA so any staged acks (STARTED/STOPPED)
            // ship, and sleep a tick so we don't spin.
            if state != StreamState::Streaming {
                sink.kick();
                led.set_low(); // PC13 is active-low: low = lit
                let _ = capture.take_dropped();
                led.set_high(); // high = dark
                embassy_time::Timer::after_millis(1).await;
                continue;
            }

            if n == 0 {
                // Idle bus — flush any partial encoder state so the
                // host sees what we have, then run the heartbeat.
                encoder.flush(&mut sink);

                if last_idle_log.elapsed() >= embassy_time::Duration::from_secs(5) {
                    let cnt = capture.peek_cnt();
                    let (pa_ndtr, pb_ndtr) = capture.peek_dma_ndtr();
                    let mut buf = [0u8; 48];
                    let msg = fmt_idle3(&mut buf, cnt, pa_ndtr, pb_ndtr);
                    encoder.log(msg, &mut sink);
                }
            } else {
                led.set_low(); // lit while draining a burst
                // Tight backlog drain. As long as the previous drain
                // filled the chunk, the rings probably have more
                // sitting behind it — keep draining synchronously
                // until we get a partial chunk (rings ~empty). Avoids
                // going through the executor + IRQ wakeup path per
                // DRAIN_CHUNK samples when we're racing to catch up
                // on a burst.
                loop {
                    for &sample in &samples[..n] {
                        encoder.feed(sample, &mut sink);
                    }

                    if n < DRAIN_CHUNK {
                        break;
                    }
                    n = capture.fast_drain(&mut samples);
                    if n == 0 {
                        break;
                    }
                }

                let dropped = capture.take_dropped();
                if dropped > 0 {
                    encoder.overrun(dropped, &mut sink);
                }

                last_idle_log = embassy_time::Instant::now();
                led.set_high(); // dark when the burst is drained
            }

            // Auto-STATS heartbeat every ~5 s while streaming.
            if last_stats.elapsed() >= embassy_time::Duration::from_secs(5) {
                let mut buf = [0u8; 96];
                let msg = fmt_stats(
                    &mut buf,
                    capture.peek_dropped_total(),
                    pa_teif_count,
                    pb_teif_count,
                );
                encoder.log(msg, &mut sink);
                last_stats = embassy_time::Instant::now();
            }

            // Sample (and clear) DMA TEIF — accumulate event counts
            // so a 5s heartbeat surfaces them via STATS.
            let (pa_te, pb_te) = capture.take_dma_teif();
            if pa_te {
                pa_teif_count = pa_teif_count.saturating_add(1);
            }
            if pb_te {
                pb_teif_count = pb_teif_count.saturating_add(1);
            }

            // Kick the TX DMA so the tail of this iteration's output
            // (and any wrap remainder) ships even if no further `push`
            // arrives — otherwise a trailing frame would sit unsent on an
            // idle bus until the next byte is produced.
            sink.kick();

            // Yield once per iteration so LED + RX get scheduled.
            // `read_available` only awaits when both rings are empty;
            // when data is plentiful it returns immediately. Without
            // this yield the cap loop can monopolise the executor.
            embassy_futures::yield_now().await;
        }
    };

    cap_fut.await;
}

/// Format `"cnt=XXXX pa_ndtr=XXXX pb_ndtr=XXXX"` into `buf` and
/// return a &str. `buf` must be at least 36 bytes.
fn fmt_idle3(buf: &mut [u8], cnt: u16, pa_ndtr: u16, pb_ndtr: u16) -> &str {
    let mut pos = 0;
    pos += write_label_u16(&mut buf[pos..], b"cnt=", cnt);
    buf[pos] = b' ';
    pos += 1;
    pos += write_label_u16(&mut buf[pos..], b"pa_ndtr=", pa_ndtr);
    buf[pos] = b' ';
    pos += 1;
    pos += write_label_u16(&mut buf[pos..], b"pb_ndtr=", pb_ndtr);
    core::str::from_utf8(&buf[..pos]).unwrap()
}

fn write_label_u16(buf: &mut [u8], label: &[u8], val: u16) -> usize {
    buf[..label.len()].copy_from_slice(label);
    for i in 0..4 {
        let nibble = (val >> (12 - 4 * i)) & 0xF;
        buf[label.len() + i] = if nibble < 10 {
            b'0' + nibble as u8
        } else {
            b'a' + (nibble - 10) as u8
        };
    }
    label.len() + 4
}

/// Format `"stats: cap_dropped=X pa_teif=X pb_teif=X"` into `buf`
/// and return a &str. `buf` must be at least 64 bytes.
fn fmt_stats(buf: &mut [u8], cap_dropped: u32, pa_teif: u32, pb_teif: u32) -> &str {
    let mut pos = 0;
    let prefix = b"stats: ";
    buf[..prefix.len()].copy_from_slice(prefix);
    pos += prefix.len();
    pos += write_label_u32(&mut buf[pos..], b"cap_dropped=", cap_dropped);
    buf[pos] = b' ';
    pos += 1;
    pos += write_label_u32(&mut buf[pos..], b"pa_teif=", pa_teif);
    buf[pos] = b' ';
    pos += 1;
    pos += write_label_u32(&mut buf[pos..], b"pb_teif=", pb_teif);
    core::str::from_utf8(&buf[..pos]).unwrap()
}

fn write_label_u32(buf: &mut [u8], label: &[u8], val: u32) -> usize {
    buf[..label.len()].copy_from_slice(label);
    for i in 0..8 {
        let nibble = (val >> (28 - 4 * i)) & 0xF;
        buf[label.len() + i] = if nibble < 10 {
            b'0' + nibble as u8
        } else {
            b'a' + (nibble - 10) as u8
        };
    }
    label.len() + 8
}
