drinkcat/aq-lcd-grab/firmware-esp32/src/bin/main.rs

#![no_std]
#![no_main]
#![recursion_limit = "256"]
#![deny(
    clippy::mem_forget,
    reason = "mem::forget is generally not safe to do with esp_hal types, especially those \
    holding buffers for the duration of a data transfer."
)]

//! aq-lcd-grab ESP32-C6 gateway.
//!
//! Receives the wire-protocol capture stream over UART from the STM32/Pico
//! bridge, decodes it on-chip (wire → permute → glyph decoder + framebuffer),
//! publishes sensor values to Home Assistant over MQTT, and serves the
//! reconstructed panel image over HTTP.
//!
//! This is the bring-up scaffold: WiFi + DHCP only. The UART/decode, HTTP, and
//! MQTT tasks are added in subsequent steps.

use aq_lcd_grab_esp32::pipeline::Pipeline;
use aq_lcd_grab_esp32::{http, logger, LatestValues, SharedFb, VALUES};
use esp_storage::FlashStorage;
use wire::{HOST_CMD_START, HOST_CMD_STOP};
use embassy_executor::Spawner;
use embassy_net::{Runner, StackResources};
use embassy_time::{Duration, Timer};
use esp_backtrace as _;
use esp_hal::clock::CpuClock;
use esp_hal::gpio::{DriveMode, Level, Output, OutputConfig};
use esp_hal::rng::Rng;
use esp_hal::timer::timg::TimerGroup;
use esp_hal::dma_rx_stream_buffer;
use esp_hal::uart::uhci::{RxConfig as UhciRxConfig, Uhci, UhciRx, UhciTx};
use esp_hal::uart::{Config as UartConfig, Uart};
use esp_hal::Async;
use esp_radio::wifi::{ClientConfig, ModeConfig, WifiController, WifiDevice};
use framebuffer::{Framebuffer, Palette4Store, DEFAULT_PALETTE, PIXELS};
use log::{info, warn};
use static_cell::StaticCell;

extern crate alloc;
use alloc::string::ToString as _;

// (ssid, password) pairs from secrets.env, generated by build.rs. Tried in
// order on each connect attempt; see `wifi_task`.
include!(concat!(env!("OUT_DIR"), "/wifi_networks.rs"));

// Default app-descriptor required by the esp-idf bootloader.
esp_bootloader_esp_idf::esp_app_desc!();

// Timestamp source for esp-println's `timestamp` feature: milliseconds since
// boot from embassy-time's monotonic clock. Logs become "INFO (12345) - msg".
#[unsafe(no_mangle)]
extern "Rust" fn _esp_println_timestamp() -> u64 {
    embassy_time::Instant::now().as_millis()
}

#[embassy_executor::task]
async fn wifi_task(mut controller: WifiController<'static>) {
    // Index of the network to try next. Kept across disconnects so a drop
    // retries the network that was working before moving on to the others.
    let mut idx = 0usize;

    loop {
        if WIFI_NETWORKS.is_empty() {
            info!("No WiFi networks configured; WiFi task idle");
            return;
        }

        let (ssid, password) = WIFI_NETWORKS[idx];
        info!(
            "WiFi connecting to {ssid} ({}/{})...",
            idx + 1,
            WIFI_NETWORKS.len()
        );

        if let Err(e) = controller.set_config(&ModeConfig::Client(
            ClientConfig::default()
                .with_ssid(ssid.to_string())
                .with_password(password.to_string()),
        )) {
            info!("WiFi config for {ssid} failed: {e:?}");
            idx = (idx + 1) % WIFI_NETWORKS.len();
            continue;
        }

        match controller.connect_async().await {
            Ok(()) => {
                info!("WiFi connected to {ssid}!");
                controller
                    .wait_for_event(esp_radio::wifi::WifiEvent::StaDisconnected)
                    .await;
                info!("WiFi disconnected from {ssid}, reconnecting...");
            }
            Err(e) => {
                info!("WiFi connect to {ssid} failed: {e:?}");
                // Move on to the next network. Only pause once a full pass has
                // failed, so scanning through several networks stays quick but
                // an all-down network doesn't spin.
                idx = (idx + 1) % WIFI_NETWORKS.len();
                if idx == 0 {
                    info!("All WiFi networks failed, retrying in 5s");
                    Timer::after(Duration::from_secs(5)).await;
                }
            }
        }
    }
}

#[embassy_executor::task]
async fn net_task(mut runner: Runner<'static, WifiDevice<'static>>) {
    runner.run().await
}

/// Drive the decode pipeline from the bridge UART over DMA (UHCI).
///
/// The STM32 bridge streams continuously at 921600; the plain RX FIFO (128 B)
/// can't keep up and overflows. UHCI runs a free-running DMA ring that the CPU
/// drains at its own pace — the same "DMA fills, poll the tail" pattern the
/// capture firmware uses.
///
/// The STM32 boots in Stopped state and only streams after START, so we arm the
/// DMA ring first (to catch the reply), then send START via the UHCI-configured
/// TX. The wire decoder resyncs on the first clean frame boundary.
#[embassy_executor::task]
async fn uart_task(
    uhci_rx: UhciRx<'static, Async>,
    mut uhci_tx: UhciTx<'static, Async>,
    fb: &'static SharedFb,
    latest: &'static LatestValues,
) {
    let values_pub = VALUES.publisher().unwrap();
    let mut pipeline = Pipeline::new();
    let mut scratch = [0u8; 1024];

    // 16 KiB DMA ring in 2 KiB chunks → ~180 ms of headroom at 921600.
    let stream_buf = dma_rx_stream_buffer!(16 * 1024, 2048);
    let mut transfer = match uhci_rx.read(stream_buf) {
        Ok(t) => t,
        Err((e, _rx, _buf)) => {
            warn!("uhci read start failed: {e:?}");
            return;
        }
    };
    info!("uart: UHCI DMA capture started");

    // Send STOP then START over the (UHCI-configured) UART TX. uart_tx is a
    // normal UART TX — fine for a couple of handshake bytes, no DMA needed.
    //
    // Between the two, drain the RX ring: after STOP the bridge can still have
    // a partial frame in flight (plus whatever it streamed before STOP took
    // effect). Discarding those stale bytes means the decoder starts on the
    // first byte after START rather than mid-frame, avoiding a desync.
    //
    // TODO: hardware-reset the STM32 bridge (and ideally the AQ display unit) on
    // ESP32 boot via a GPIO reset line, so the capture always starts from a
    // known state rather than relying on STOP/START against whatever state the
    // bridge was left in. Until then a stale bridge may need a manual reset.
    let _ = uhci_tx.uart_tx.write_async(&[HOST_CMD_STOP]).await;
    let _ = uhci_tx.uart_tx.flush_async().await;
    // Let the STOP propagate and the bridge's in-flight bytes land in the ring.
    Timer::after(Duration::from_millis(20)).await;
    let mut flushed = 0u64;
    while transfer.available_bytes() > 0 {
        flushed += transfer.pop(&mut scratch) as u64;
    }
    info!("uart: flushed {flushed} stale bytes after STOP");
    let _ = uhci_tx.uart_tx.write_async(&[HOST_CMD_START]).await;
    let _ = uhci_tx.uart_tx.flush_async().await;
    info!("uart: sent START to bridge");

    let mut total: u64 = 0;
    let mut last_report = embassy_time::Instant::now();
    loop {
        let avail = transfer.available_bytes();
        if avail == 0 {
            // Nothing yet — yield briefly. At line rate a 2 ms nap still leaves
            // the 16 KiB ring far from full.
            Timer::after(Duration::from_millis(2)).await;
            // Heartbeat so we can tell whether any bytes are arriving at all.
            if last_report.elapsed() >= Duration::from_secs(5) {
                info!("uart: rx total={total} bytes");
                last_report = embassy_time::Instant::now();
            }
            continue;
        }
        let n = transfer.pop(&mut scratch);
        total += n as u64;
        if last_report.elapsed() >= Duration::from_secs(5) {
            info!("uart: rx total={total} bytes");
            last_report = embassy_time::Instant::now();
        }
        if let Err(e) = pipeline.feed(&scratch[..n], fb, &values_pub, latest).await {
            warn!("wire desync ({e:?})");
        }
    }
}

/// One picoserve HTTP worker. Run several (HTTP_WORKERS) so a browser's
/// overlapping connections (page + image + refreshes) each find a free
/// listener; keep-alive lets each connection serve multiple requests.
#[embassy_executor::task(pool_size = http::HTTP_WORKERS)]
async fn http_task(
    id: usize,
    stack: embassy_net::Stack<'static>,
    app: &'static http::AppRouter,
    config: &'static picoserve::Config,
) -> ! {
    // Large TX + http buffers so more of the ~75 KiB image queues before the
    // task has to await smoltcp, avoiding the ~2-5 ms stall seen between small
    // flushes (tcpdump showed 2 KiB bursts with multi-ms gaps).
    let mut rx = [0u8; 1024];
    let mut tx = [0u8; 8192];
    let mut http_buf = [0u8; 8192];
    picoserve::Server::new(app, config, &mut http_buf)
        .listen_and_serve(id, stack, 80, &mut rx, &mut tx)
        .await
        .into_never()
}

#[allow(
    clippy::large_stack_frames,
    reason = "it's not unusual to allocate larger buffers etc. in main"
)]
#[esp_rtos::main]
async fn main(spawner: Spawner) -> ! {
    logger::init();

    let config = esp_hal::Config::default().with_cpu_clock(CpuClock::max());
    let peripherals = esp_hal::init(config);

    // Heap for esp-radio + alloc-using deps (rust-mqtt). The 75 KiB framebuffer
    // and decode buffers are static, not heap. 64 KiB is the most the reclaimed
    // DRAM2 region holds on this config.
    esp_alloc::heap_allocator!(#[esp_hal::ram(reclaimed)] size: 64 * 1024);

    let timg0 = TimerGroup::new(peripherals.TIMG0);
    let sw_interrupt =
        esp_hal::interrupt::software::SoftwareInterruptControl::new(peripherals.SW_INTERRUPT);
    esp_rtos::start(timg0.timer0, sw_interrupt.software_interrupt0);

    info!(
        "aq-lcd-grab ESP32-C6 gateway starting (built {} git:{})",
        env!("BUILD_TIMESTAMP"),
        env!("GIT_COMMIT"),
    );

    // Pulse the STM32 NRST low to reboot the bridge into a known state on every
    // ESP32 boot. NRST (STM32 U1 pin 7) is wired GPIO19 → R17 → NRST as
    // OPEN-DRAIN: the STM32 has an internal pull-up (+ C8 filter), so we only
    // ever drive LOW (= reset) and release to HIGH-Z (= run). Never push-pull
    // high. Start Level::High so the very first edge can't glitch the line low.
    {
        let mut nrst = Output::new(
            peripherals.GPIO19,
            Level::High,
            OutputConfig::default().with_drive_mode(DriveMode::OpenDrain),
        );
        nrst.set_low();
        Timer::after(Duration::from_millis(10)).await; // hold reset
        nrst.set_high(); // release; pull-up + C8 ramp NRST back to 3V3
        // Keep the line released (high-Z). Dropping `nrst` here would revert
        // GPIO19 to its reset state (also high-Z), so leaking it on purpose is
        // unnecessary — but give the STM32 a moment to come out of reset and
        // emit its boot log before the UART task arms and sends START.
        core::mem::forget(nrst);
        Timer::after(Duration::from_millis(20)).await;
    }
    info!("uart: pulsed STM32 NRST");

    // Shared framebuffer: 4bpp into the default palette, backed by a 'static
    // buffer. PIXELS/2 = 76 800 bytes.
    let fb: &'static SharedFb = {
        static FB_BYTES: StaticCell<[u8; PIXELS / 2]> = StaticCell::new();
        let bytes = FB_BYTES.init([0u8; PIXELS / 2]);
        let store = Palette4Store::new(bytes, DEFAULT_PALETTE);
        static FB: StaticCell<SharedFb> = StaticCell::new();
        FB.init(SharedFb::new(Framebuffer::new(store)))
    };

    // Latest decoded values, shared between the UART pipeline and HTTP /values.
    let latest: &'static LatestValues = {
        static LATEST: StaticCell<LatestValues> = StaticCell::new();
        LATEST.init(LatestValues::new(Default::default()))
    };

    // Bridge UART (UART1) on GPIO17 (RX) / GPIO16 (TX), 921600 8N1.
    //
    // On the ESP32-C6-DevKitC-1 these are U0RXD/U0TXD, wired to the onboard
    // CH343 USB-to-UART bridge that enumerates as the "UART" USB port (VID
    // 1a86). So the host can feed the capture straight into this port — no
    // extra wiring — while the console/logs stay on the native USB-Serial-JTAG
    // port (VID 303a). Off-DevKit, wire the bridge's TX → GPIO17, GND → GND
    // (and GPIO16 → bridge RX for START/STOP).
    let (uhci_rx, uhci_tx) = {
        let cfg = UartConfig::default().with_baudrate(921_600);
        let uart = Uart::new(peripherals.UART1, cfg)
            .expect("uart config")
            .with_rx(peripherals.GPIO17)
            .with_tx(peripherals.GPIO16);

        // UART-over-DMA. chunk_limit must stay ≤ the DMA chunk size (2048).
        let mut uhci = Uhci::new(uart, peripherals.UHCI0, peripherals.DMA_CH0).into_async();
        uhci.set_uart_config(&UartConfig::default().with_baudrate(921_600))
            .expect("uhci uart config");
        let (mut rx, tx) = uhci.split();
        rx.apply_config(&UhciRxConfig::default().with_chunk_limit(1024))
            .expect("uhci rx config");
        (rx, tx)
    };

    static RADIO_INIT: StaticCell<esp_radio::Controller<'static>> = StaticCell::new();
    let radio_init =
        RADIO_INIT.init(esp_radio::init().expect("Failed to initialize Wi-Fi/BLE controller"));
    let (mut wifi_controller, interfaces) =
        esp_radio::wifi::new(&*radio_init, peripherals.WIFI, Default::default())
            .expect("Failed to initialize Wi-Fi controller");

    // The SSID/password are set per-attempt inside `wifi_task`, which cycles
    // through WIFI_NETWORKS; the controller only needs starting here. `start()`
    // requires a config, so seed it with the first network.
    if let Some((ssid, password)) = WIFI_NETWORKS.first() {
        wifi_controller
            .set_config(&ModeConfig::Client(
                ClientConfig::default()
                    .with_ssid(ssid.to_string())
                    .with_password(password.to_string()),
            ))
            .expect("Failed to configure WiFi");
    }
    wifi_controller.start().expect("Failed to start WiFi");

    let seed = {
        let rng = Rng::new();
        (rng.random() as u64) << 32 | rng.random() as u64
    };

    // Socket slots: HTTP_WORKERS listeners + DHCP + DNS + MQTT headroom.
    static STACK_RESOURCES: StaticCell<StackResources<8>> = StaticCell::new();
    let (stack, runner) = embassy_net::new(
        interfaces.sta,
        embassy_net::Config::dhcpv4(Default::default()),
        STACK_RESOURCES.init(StackResources::new()),
        seed,
    );

    spawner.spawn(wifi_task(wifi_controller)).unwrap();
    spawner.spawn(net_task(runner)).unwrap();
    // The decode pipeline runs independently of WiFi so capture works even
    // before the network is up.
    spawner.spawn(uart_task(uhci_rx, uhci_tx, fb, latest)).unwrap();

    stack.wait_config_up().await;
    if let Some(cfg) = stack.config_v4() {
        info!("WiFi ready, IP: {} — http://{}/", cfg.address, cfg.address.address());
    }

    // Publish the framebuffer to the HTTP handlers, build the router + config
    // once, leak to 'static, and run a pool of identical workers.
    http::set_shared(fb, latest);
    http::set_flash(FlashStorage::new(peripherals.FLASH));
    use picoserve::AppWithStateBuilder as _;
    let app = picoserve::make_static!(http::AppRouter, http::AppProps.build_app());
    let http_config = picoserve::make_static!(picoserve::Config, http::config());
    for w in 0..http::HTTP_WORKERS {
        spawner.spawn(http_task(w, stack, app, http_config)).unwrap();
    }

    #[cfg(feature = "homeassistant")]
    spawner
        .spawn(aq_lcd_grab_esp32::mqtt::mqtt_task(stack))
        .unwrap();

    spawner.spawn(aq_lcd_grab_esp32::reboot::reboot_task()).unwrap();

    loop {
        Timer::after(Duration::from_secs(30)).await;
        if let Some(cfg) = stack.config_v4() {
            info!("alive, IP: {}", cfg.address);
        }
    }
}
