drinkcat/aq-lcd-grab/host/src/main.rs

mod bus_decoder;

use std::collections::HashSet;
use std::fs::File;
use std::hash::{Hash, Hasher};
use std::io::{BufWriter, Read, Write};
use std::path::{Path, PathBuf};
use std::sync::{Arc, Mutex};
use std::thread;
use std::time::{Duration, SystemTime, UNIX_EPOCH};

use anyhow::{Context, bail};
use bus_decoder::{BusDecoder, Frame};
use clap::{Parser, ValueEnum};
use eframe::egui;
use framebuffer::{Framebuffer, PixelStore, PIXELS};
use wire::{Decoder as WireDecoder, HOST_CMD_START, HOST_CMD_STOP, WireEvent};

#[derive(Copy, Clone, Debug, ValueEnum)]
enum Board {
    /// Pico 2 W (USB CDC, GPIO0..15 = DB0..15, GPIO16=DC, GPIO17=CS).
    Pico,
    /// F103 capture board (USART1/FTDI). See permute::permute_f103 for
    /// the pin→bit routing; GPIOB carries DC + low byte + the top red
    /// and green bits, GPIOA the lower colour bits + CS.
    F103,
}

impl Board {
    fn permute(self, sample: u32) -> (u16, bool) {
        match self {
            Board::Pico => wire::permute_pico(sample),
            Board::F103 => wire::permute_f103(sample),
        }
    }

    /// Serial device this board enumerates as when no `--port` is given.
    /// The Pico is native USB-CDC (ttyACM); the F103 talks over an
    /// external FTDI adapter on USART1 (ttyUSB).
    fn default_port(self) -> &'static str {
        match self {
            Board::Pico => "/dev/ttyACM0",
            Board::F103 => "/dev/ttyUSB0",
        }
    }
}

#[derive(Parser, Debug)]
#[command(about = "Live viewer for the aq-lcd-grab firmware capture stream")]
struct Args {
    /// Serial device the firmware is logging on. Defaults per board:
    /// Pico → /dev/ttyACM0 (USB-CDC), F103 → /dev/ttyUSB0 (FTDI).
    #[arg(short, long)]
    port: Option<String>,

    /// Which capture board is on the other end. Picks the permutation
    /// from raw (pa, pb) port reads back to logical (data, dc, cs).
    #[arg(short, long, value_enum, default_value_t = Board::Pico)]
    board: Board,

    /// Optional file to replay (skips opening the serial port).
    /// Raw binary frames as emitted by the firmware.
    #[arg(short, long)]
    replay: Option<String>,

    /// Directory to dump per-glyph PNGs into. One PNG is written each time
    /// a MEMORY_WRITE exactly fills its addressed window; identical
    /// (window, content) pairs are deduplicated.
    #[arg(long)]
    dump_dir: Option<PathBuf>,

    /// Path to dump the raw wire byte stream into. Captures everything
    /// from after sync (post-START) onward, byte-for-byte as it came
    /// off the serial port — feed it back via `--replay` to re-run
    /// any analysis offline.
    #[arg(long)]
    raw_dump: Option<PathBuf>,

    /// Run without the egui window: just the reader loop, printing the
    /// decoded log to stdout. For headless capture / scripted runs.
    #[arg(long)]
    headless: bool,
}

/// ILI9488 command names.
fn cmd_name(cmd: u8) -> &'static str {
    match cmd {
        0x00 => "NOP",
        0x01 => "SOFT_RESET",
        0x04 => "READ_DISPLAY_ID",
        0x09 => "READ_DISPLAY_STATUS",
        0x10 => "SLEEP_IN",
        0x11 => "SLEEP_OUT",
        0x12 => "PARTIAL_MODE_ON",
        0x13 => "NORMAL_MODE_ON",
        0x20 => "INVERSION_OFF",
        0x21 => "INVERSION_ON",
        0x28 => "DISPLAY_OFF",
        0x29 => "DISPLAY_ON",
        0x2A => "SET_COLUMN_ADDRESS",
        0x2B => "SET_ROW_ADDRESS",
        0x2C => "MEMORY_WRITE",
        0x2E => "MEMORY_READ",
        0x30 => "PARTIAL_AREA",
        0x33 => "VERTICAL_SCROLLING",
        0x36 => "MEMORY_ACCESS_CONTROL",
        0x37 => "VERTICAL_SCROLL_START",
        0x38 => "IDLE_MODE_OFF",
        0x39 => "IDLE_MODE_ON",
        0x3A => "PIXEL_FORMAT_SET",
        0x3C => "MEMORY_WRITE_CONTINUE",
        0xB0 => "INTERFACE_MODE_CONTROL",
        0xB1 => "FRAME_RATE_NORMAL",
        0xB4 => "DISPLAY_INVERSION_CONTROL",
        0xB6 => "DISPLAY_FUNCTION_CONTROL",
        0xB7 => "ENTRY_MODE_SET",
        0xC0 => "POWER_CONTROL_1",
        0xC1 => "POWER_CONTROL_2",
        0xC5 => "VCOM_CONTROL",
        0xE0 => "POSITIVE_GAMMA",
        0xE1 => "NEGATIVE_GAMMA",
        0xF7 => "ADJUST_CONTROL_3",
        _ => "?",
    }
}

/// Host pixel store: owns a full-fidelity RGB565 buffer. The embedded target
/// uses `framebuffer::Palette4Store` over a `StaticCell` slice instead; the
/// host keeps 16-bit colour for the egui display.
struct HostStore {
    pixels: Vec<u16>,
}

impl HostStore {
    fn new() -> Self {
        Self {
            pixels: vec![0u16; PIXELS],
        }
    }
}

impl PixelStore for HostStore {
    fn len(&self) -> usize {
        self.pixels.len()
    }
    fn set(&mut self, idx: usize, rgb565: u16) {
        self.pixels[idx] = rgb565;
    }
    fn get(&self, idx: usize) -> u16 {
        self.pixels[idx]
    }
}

/// A single MEMORY_WRITE that exactly fills the active window — a candidate
/// glyph/sprite update worth dumping for offline analysis. Tracked host-side
/// (the framebuffer crate no longer surfaces this; it's a viewer-only feature).
struct WindowWrite {
    x: u16,
    y: u16,
    w: u16,
    h: u16,
    pixels: Vec<u16>,
}

/// Host-side window tracker for the glyph-dump feature. Mirrors the panel's
/// active-window state (0x2A/0x2B) so an exact-fill 0x2C can be captured.
#[derive(Default)]
struct WindowTracker {
    col_start: u16,
    col_end: u16,
    row_start: u16,
    row_end: u16,
}

impl WindowTracker {
    /// Update from a frame; return a `WindowWrite` if this frame is a 0x2C that
    /// exactly fills the active window.
    fn observe(&mut self, frame: &Frame) -> Option<WindowWrite> {
        match frame.cmd {
            0x2A if frame.data.len() >= 4 => {
                self.col_start = (frame.data[0] & 0xFF) << 8 | (frame.data[1] & 0xFF);
                self.col_end = (frame.data[2] & 0xFF) << 8 | (frame.data[3] & 0xFF);
                None
            }
            0x2B if frame.data.len() >= 4 => {
                self.row_start = (frame.data[0] & 0xFF) << 8 | (frame.data[1] & 0xFF);
                self.row_end = (frame.data[2] & 0xFF) << 8 | (frame.data[3] & 0xFF);
                None
            }
            0x2C if self.col_end >= self.col_start && self.row_end >= self.row_start => {
                let w = self.col_end - self.col_start + 1;
                let h = self.row_end - self.row_start + 1;
                if frame.data.len() == w as usize * h as usize {
                    Some(WindowWrite {
                        x: self.col_start,
                        y: self.row_start,
                        w,
                        h,
                        pixels: frame.data.clone(),
                    })
                } else {
                    None
                }
            }
            _ => None,
        }
    }
}

struct Shared {
    fb: Framebuffer<HostStore>,
    win_tracker: WindowTracker,
    log: std::collections::VecDeque<LogEntry>,
    /// Latest decoded value per named row (see decoder::ROWS). Updated
    /// from the reader thread; rendered in the top panel.
    values: std::collections::BTreeMap<&'static str, String>,
}

#[derive(Clone)]
enum LogEntry {
    Tx(Frame),
    Msg(String),
}

const LOG_CAP: usize = 128;

fn main() -> anyhow::Result<()> {
    let args = Args::parse();

    // The reader thread blocks in serial I/O and would otherwise keep
    // the process alive through Ctrl-C. Hard-exit on SIGINT.
    ctrlc::set_handler(|| std::process::exit(0))?;

    let shared = Arc::new(Mutex::new(Shared {
        fb: Framebuffer::new(HostStore::new()),
        win_tracker: WindowTracker::default(),
        log: std::collections::VecDeque::with_capacity(LOG_CAP),
        values: std::collections::BTreeMap::new(),
    }));

    if let Some(dir) = &args.dump_dir {
        std::fs::create_dir_all(dir)
            .with_context(|| format!("creating dump dir {}", dir.display()))?;
    }

    let reader_shared = Arc::clone(&shared);
    let port = args
        .port
        .clone()
        .unwrap_or_else(|| args.board.default_port().to_string());
    let replay = args.replay.clone();
    let dump_dir = args.dump_dir.clone();
    let raw_dump = args.raw_dump.clone();
    let board = args.board;

    // Headless: run the reader on this thread (it prints the decoded log)
    // and skip the GUI entirely. For scripted capture / no window per run.
    if args.headless {
        reader_loop(port, board, replay, dump_dir, raw_dump, reader_shared)?;
        return Ok(());
    }

    thread::spawn(move || {
        if let Err(e) = reader_loop(port, board, replay, dump_dir, raw_dump, reader_shared) {
            eprintln!("reader thread exited: {e:#}");
        }
    });

    let native_options = eframe::NativeOptions {
        viewport: egui::ViewportBuilder::default().with_inner_size([800.0, 700.0]),
        ..Default::default()
    };
    eframe::run_native(
        "aq-lcd-grab viewer",
        native_options,
        Box::new(move |_cc| Ok(Box::new(App::new(Arc::clone(&shared))))),
    )
    .map_err(|e| anyhow::anyhow!("eframe error: {e}"))?;

    // The reader thread is parked in a blocking serial read with a 60 s
    // timeout. Returning here would wait for it (which makes Ctrl-C feel
    // unresponsive) — exit hard instead.
    std::process::exit(0);
}

fn reader_loop(
    port: String,
    board: Board,
    replay: Option<String>,
    dump_dir: Option<PathBuf>,
    raw_dump: Option<PathBuf>,
    shared: Arc<Mutex<Shared>>,
) -> anyhow::Result<()> {
    let (mut reader, mut writer): (Box<dyn Read + Send>, Option<Box<dyn Write + Send>>) =
        if let Some(path) = replay {
            let f = std::fs::File::open(&path).with_context(|| format!("opening {path}"))?;
            (Box::new(f), None)
        } else {
            // Baud doesn't matter for the Pico (USB CDC ignores it) but
            // gives the right rate for UART-attached boards like the
            // F103.
            // Read timeout: the main loop treats a timed-out read as
            // "no bytes" and pumps the glyph-row settler. The sync
            // handshake's drain-until-quiet also uses this as its
            // quiet window.
            let mut port_handle = serialport::new(&port, 921_600)
                .timeout(Duration::from_millis(50))
                // Non-exclusive so `printf '\x04' > /dev/ttyUSB0` can
                // poke STATS while the viewer is running. Garbled
                // bytes are possible if someone reads concurrently,
                // but writes from another process are fine.
                .exclusive(false)
                .open()
                .with_context(|| format!("opening serial port {port}"))?;
            // F103 wires DTR→BOOT0 and RTS→NRST through 1k resistors
            // (see firmware-stm32/scripts/flash-uart.sh). Without
            // intervention, Linux's tty open() leaves these in a state
            // that drops the chip into the ROM bootloader instead of
            // user code, every time the viewer launches.
            //
            // Drive a clean "reset into user code" pulse:
            //   DTR=true  → BOOT0 low (run user app)
            //   RTS=true  → NRST low  (assert reset)
            //   <20 ms>
            //   RTS=false → NRST high (release reset, chip boots)
            //
            // The exact wire polarity depends on the FT232R EEPROM /
            // adapter wiring (some clones invert, some don't); the
            // values below are right for this rig. Harmless on
            // USB-CDC boards (Pico) where DTR/RTS aren't wired to
            // anything.
            port_handle
                .write_data_terminal_ready(true)
                .with_context(|| "DTR=true (BOOT0 low → run user code)")?;
            port_handle
                .write_request_to_send(true)
                .with_context(|| "RTS=true (NRST low → reset asserted)")?;
            std::thread::sleep(Duration::from_millis(20));
            port_handle
                .write_request_to_send(false)
                .with_context(|| "RTS=false (NRST released)")?;
            // Give the F103 a moment to boot its firmware before we
            // start the STOP/START handshake.
            std::thread::sleep(Duration::from_millis(250));
            let writer = port_handle
                .try_clone()
                .with_context(|| "cloning serial handle for writer")?;
            eprintln!("reader: opened {port}");
            (Box::new(port_handle), Some(Box::new(writer)))
        };

    if let Some(w) = writer.as_mut() {
        sync(reader.as_mut(), w.as_mut())?;
    }

    // Raw-dump sink: opened after sync so the file starts at the
    // post-START byte stream, replayable as-is via --replay.
    let mut raw_sink: Option<BufWriter<File>> = match raw_dump {
        Some(path) => {
            let f = File::create(&path)
                .with_context(|| format!("creating raw dump file {}", path.display()))?;
            eprintln!("reader: raw dump → {}", path.display());
            Some(BufWriter::new(f))
        }
        None => None,
    };

    let mut wire = WireDecoder::new();
    let mut bus = BusDecoder::new();
    let mut glyphs = decoder::Decoder::new();
    let mut seen: HashSet<u64> = HashSet::new();
    let mut buf = [0u8; 4096];

    loop {
        let read = match reader.read(&mut buf) {
            Ok(0) => {
                // Flush any dirty rows before reporting EOF.
                let mut g = shared.lock().unwrap();
                emit_rows(&mut g, &mut glyphs);
                bail!("stream EOF");
            }
            Ok(n) => n,
            Err(e) if e.kind() == std::io::ErrorKind::TimedOut => 0,
            Err(e) => return Err(e.into()),
        };
        if read > 0
            && let Some(sink) = raw_sink.as_mut()
        {
            sink.write_all(&buf[..read])
                .with_context(|| "writing to raw dump file")?;
            // Flush on the idle path below so the file is at most
            // one read-timeout window behind real time, even if
            // the viewer is killed.
        }
        if read == 0
            && let Some(sink) = raw_sink.as_mut()
        {
            sink.flush().ok();
        }

        let mut g = shared.lock().unwrap();
        if read > 0 {
            wire
                .feed(&buf[..read], |ev| {
                    dispatch_event(
                        ev,
                        &mut g,
                        &mut bus,
                        &mut glyphs,
                        dump_dir.as_deref(),
                        &mut seen,
                        board,
                    );
                })
                .map_err(|e| anyhow::anyhow!("wire decode desync: {e:?}"))?;
        }
        if read == 0 {
            // Idle: emit any dirty metric rows that have settled.
            emit_rows(&mut g, &mut glyphs);
        }
    }
}

/// Feed one permuted sample to both the bus decoder (display) and the
/// glyph decoder (value extraction).
fn feed_sample(
    data: u16,
    is_data: bool,
    g: &mut Shared,
    bus: &mut BusDecoder,
    glyphs: &mut decoder::Decoder,
    dump_dir: Option<&Path>,
    seen: &mut HashSet<u64>,
) {
    if let Some(out) = glyphs.feed(data, is_data) {
        if let Some(m) = out.glyph {
            let msg = format!(
                "→ {}x{}@({:03},{:03}) = {:?}",
                m.w, m.h, m.disp_x, m.disp_y, m.label
            );
            println!("{msg}");
            push_log(&mut g.log, LogEntry::Msg(msg));
        }
    }
    if let Some(tx) = bus.feed(data, is_data) {
        handle_frame(g, dump_dir, seen, tx);
    }
}

/// Process one wire event: permute samples, feed the bus decoder,
/// hand any completed 8080 transactions to `handle_frame`.
fn dispatch_event(
    ev: WireEvent<'_>,
    g: &mut Shared,
    bus: &mut BusDecoder,
    glyphs: &mut decoder::Decoder,
    dump_dir: Option<&Path>,
    seen: &mut HashSet<u64>,
    board: Board,
) {
    match ev {
        WireEvent::Block(samples) => {
            print!("BLOCK n={:3}", samples.len());
            for s in samples {
                // Raw u32 sample alongside permuted view so we can see
                // CS / noise bits that the data+is_data summary hides
                // (helpful when the encoder fragments runs because of
                // control-bit flicker even though data is constant).
                let (data, is_data) = board.permute(*s);
                print!(
                    " {:08x}({}:{:04x})",
                    s,
                    if is_data { 'D' } else { 'C' },
                    data
                );
            }
            println!();
            for &s in samples {
                let (data, is_data) = board.permute(s);
                feed_sample(data, is_data, g, bus, glyphs, dump_dir, seen);
            }
        }
        WireEvent::Run { n, sample } => {
            let (data, is_data) = board.permute(sample);
            println!(
                "RUN   n={:5} {:08x}({}:{:04x})",
                n,
                sample,
                if is_data { 'D' } else { 'C' },
                data
            );
            // Glyph decoder: feed all n copies.
            for _ in 0..n {
                if let Some(out) = glyphs.feed(data, is_data) {
                    if let Some(m) = out.glyph {
                        let msg = format!(
                            "→ {}x{}@({:03},{:03}) = {:?}",
                            m.w, m.h, m.disp_x, m.disp_y, m.label
                        );
                        println!("{msg}");
                        push_log(&mut g.log, LogEntry::Msg(msg));
                    }
                }
            }
            if let Some(tx) = bus.feed_run(n as usize, data, is_data) {
                handle_frame(g, dump_dir, seen, tx);
            }
        }
        WireEvent::Repeat2 {
            val_a,
            val_b,
            run_lens,
        } => {
            let (data_a, is_data_a) = board.permute(val_a);
            let (data_b, is_data_b) = board.permute(val_b);
            let total: usize = run_lens.iter().map(|&l| l as usize).sum();
            println!(
                "RPT2  runs={:3} total={:5}  A={:08x}({}:{:04x})  B={:08x}({}:{:04x})  lens={:?}",
                run_lens.len(),
                total,
                val_a,
                if is_data_a { 'D' } else { 'C' },
                data_a,
                val_b,
                if is_data_b { 'D' } else { 'C' },
                data_b,
                run_lens,
            );
            for (i, &len) in run_lens.iter().enumerate() {
                let (data, is_data) = if i & 1 == 0 {
                    (data_a, is_data_a)
                } else {
                    (data_b, is_data_b)
                };
                // Glyph decoder: feed all copies in this run.
                for _ in 0..len {
                    if let Some(out) = glyphs.feed(data, is_data) {
                        if let Some(m) = out.glyph {
                            let msg = format!(
                                "→ {}x{}@({:03},{:03}) = {:?}",
                                m.w, m.h, m.disp_x, m.disp_y, m.label
                            );
                            println!("{msg}");
                            push_log(&mut g.log, LogEntry::Msg(msg));
                        }
                    }
                }
                if let Some(tx) = bus.feed_run(len as usize, data, is_data) {
                    handle_frame(g, dump_dir, seen, tx);
                }
            }
        }
        WireEvent::Tick {
            t_us,
            dt_us,
            n_drained,
            n_pending,
            bytes_out,
        } => {
            println!(
                "TICK  t={:>10}us dt={:>5}us drained={:>5} pending={:>5} bytes_out={:>10}",
                t_us, dt_us, n_drained, n_pending, bytes_out,
            );
        }
        WireEvent::Overrun { dropped } => {
            let msg = format!("(firmware lost {dropped} WR edges)");
            println!("! {msg}");
            push_log(&mut g.log, LogEntry::Msg(msg));
        }
        WireEvent::Log(text) => {
            println!("• {text}");
            push_log(&mut g.log, LogEntry::Msg(text.to_string()));
            // Firmware log lines land between display refreshes, so they make
            // good flush points: emit whatever the rows currently hold. This
            // keeps decoded values current during a continuous stream that
            // never goes idle (e.g. replaying a capture file).
            emit_rows(g, glyphs);
        }
        WireEvent::Started => push_log(&mut g.log, LogEntry::Msg("STARTED".into())),
        WireEvent::Stopped => push_log(&mut g.log, LogEntry::Msg("STOPPED".into())),
    }
}

/// Replays `frame` into the framebuffer (for egui display), dumps the
/// resulting window if a dump dir is set, and pushes log lines.
fn handle_frame(
    g: &mut Shared,
    dump_dir: Option<&Path>,
    seen: &mut HashSet<u64>,
    frame: Frame,
) {
    println!("{}", format_tx(&frame));
    // Replay the transaction into the framebuffer at the sample level: the
    // command byte (is_data=false) then each data word (is_data=true).
    g.fb.feed(frame.cmd as u16, false);
    for &d in &frame.data {
        g.fb.feed(d, true);
    }
    let win = g.win_tracker.observe(&frame);
    push_log(&mut g.log, LogEntry::Tx(frame));
    if let (Some(dir), Some(win)) = (dump_dir, win) {
        dump_window(dir, &win, seen);
    }
}

/// Handshake: drain any backlog, send STOP and wait for `0xFC`, then
/// send START and wait for `0xFB`. After this returns, the next byte
/// read starts a fresh frame.
/// Handshake. Send STOP, drain until the firmware stops talking,
/// sanity-check that the last byte we saw was the STOPPED ack
/// (0xFC). Then send START — the first byte from the firmware should
/// be the STARTED ack (0xFB), and everything after it is fresh frame
/// data going to the wire decoder.
fn sync(reader: &mut (dyn Read + Send), writer: &mut (dyn Write + Send)) -> anyhow::Result<()> {
    // 1. Tell the firmware to stop sending. Then read until quiet —
    //    anything in the OS buffer plus anything the firmware was
    //    mid-emitting plus the STOPPED ack will all flush. "Quiet" =
    //    one serial-port read timeout (250 ms) without any bytes.
    //    After it goes quiet, the last byte we saw must be 0xFC;
    //    otherwise the firmware isn't speaking our protocol.
    writer.write_all(&[HOST_CMD_STOP])?;
    writer.flush()?;
    if !drain_until_quiet(reader, 0xFC)? {
        bail!("never saw STOPPED ack (0xFC) after sending STOP");
    }

    // 2. Send START. Everything from here on — including the FB
    //    STARTED ack — flows to the main loop's wire decoder. No
    //    explicit ack check; the wire decoder will surface FB as
    //    Event::Started and we'll see it in the activity log.
    writer.write_all(&[HOST_CMD_START])?;
    writer.flush()?;
    eprintln!("reader: synced (sent START)");
    Ok(())
}

/// Read from `reader` until it times out (no bytes arrived for one
/// read-timeout window). Returns whether `needle` appeared anywhere
/// in the drained bytes. Logs how much was discarded (and a hex
/// preview) so a failed sync shows what the firmware actually sent.
fn drain_until_quiet(reader: &mut (dyn Read + Send), needle: u8) -> anyhow::Result<bool> {
    let mut saw_needle = false;
    let mut total = 0usize;
    let mut preview: Vec<u8> = Vec::new();
    let mut buf = [0u8; 4096];
    let result = loop {
        match reader.read(&mut buf) {
            Ok(0) => break Ok(saw_needle),
            Ok(n) => {
                total += n;
                if preview.len() < 32 {
                    preview.extend_from_slice(&buf[..n.min(32 - preview.len())]);
                }
                if buf[..n].contains(&needle) {
                    saw_needle = true;
                }
            }
            Err(e) if e.kind() == std::io::ErrorKind::TimedOut => break Ok(saw_needle),
            Err(e) => break Err(e.into()),
        }
    };
    eprintln!(
        "sync: discarded {} bytes while draining (looking for {:#04x}, {}); first bytes: {:02x?}",
        total,
        needle,
        if saw_needle { "FOUND" } else { "not found" },
        preview,
    );
    result
}

/// Minimum window dimension considered a glyph worth keeping. Filters
/// out thin status bars and 1-pixel-wide animation slivers.
const GLYPH_MIN_DIM: u16 = 8;

/// Save a per-window PNG into `dir`. Each pixel is reduced to a 1-bit
/// foreground/background mask (majority pixel value = background), so the
/// same digit collapses to one file across red/green/white backgrounds.
/// Dedup key is (size, mask) — position is recorded in the filename only.
fn dump_window(dir: &Path, win: &WindowWrite, seen: &mut HashSet<u64>) {
    if win.w < GLYPH_MIN_DIM || win.h < GLYPH_MIN_DIM {
        return;
    }

    let bg = win.pixels[0];
    let mask: Vec<bool> = win.pixels.iter().map(|&p| p != bg).collect();

    let mut hasher = std::collections::hash_map::DefaultHasher::new();
    win.w.hash(&mut hasher);
    win.h.hash(&mut hasher);
    for &m in &mask {
        <bool as Hash>::hash(&m, &mut hasher);
    }
    let key = hasher.finish();
    if !seen.insert(key) {
        return;
    }

    let disp_x = framebuffer::WIDTH.saturating_sub(win.x + win.w);
    let disp_y = framebuffer::HEIGHT.saturating_sub(win.y + win.h);

    let mut rgba = Vec::with_capacity(mask.len() * 4);
    for &m in mask.iter().rev() {
        let v = if m { 0xFF } else { 0 };
        rgba.push(v);
        rgba.push(v);
        rgba.push(v);
        rgba.push(0xFF);
    }
    let ts = SystemTime::now()
        .duration_since(UNIX_EPOCH)
        .map(|d| d.as_millis())
        .unwrap_or(0);
    let name = format!("{}x{}_{:03}_{:03}_{}.png", win.w, win.h, disp_x, disp_y, ts);
    let path = dir.join(&name);
    match image::RgbaImage::from_raw(win.w as u32, win.h as u32, rgba) {
        Some(img) => {
            if let Err(e) = img.save(&path) {
                eprintln!("dumper: save {} failed: {e}", path.display());
            } else {
                println!("• dumped {name}");
            }
        }
        None => eprintln!("dumper: rgba buffer size mismatch"),
    }
}

fn format_tx(tx: &Frame) -> String {
    let mut line = format!("{:#04x} {}", tx.cmd, cmd_name(tx.cmd));
    if !tx.data.is_empty() {
        line.push_str(&format!(" [{}]", tx.data.len()));
        for (i, w) in tx.data.iter().take(6).enumerate() {
            if i == 0 {
                line.push(' ');
            }
            line.push_str(&format!("{w:04x} "));
        }
        if tx.data.len() > 6 {
            line.push('…');
        }
    }
    line
}

fn push_log(log: &mut std::collections::VecDeque<LogEntry>, entry: LogEntry) {
    if log.len() == LOG_CAP {
        log.pop_front();
    }
    log.push_back(entry);
}

/// Flush settled metric rows from the glyph decoder: print each, append to the
/// activity log, and update the value map shown in the top panel.
fn emit_rows(g: &mut Shared, glyphs: &mut decoder::Decoder) {
    glyphs.flush_each(|name, value| {
        let msg = format!("= {name}: {value:?}");
        println!("{msg}");
        push_log(&mut g.log, LogEntry::Msg(msg));
        g.values.insert(name, value.to_string());
    });
}

struct App {
    shared: Arc<Mutex<Shared>>,
    texture: Option<egui::TextureHandle>,
}

impl App {
    fn new(shared: Arc<Mutex<Shared>>) -> Self {
        Self {
            shared,
            texture: None,
        }
    }
}

impl eframe::App for App {
    fn ui(&mut self, ui: &mut egui::Ui, _frame: &mut eframe::Frame) {
        let ctx = ui.ctx().clone();

        let (rgba, w, h, log, values) = {
            let g = self.shared.lock().unwrap();
            let mut rgba = vec![0u8; framebuffer::RGBA8_LEN];
            framebuffer::write_rgba8(&g.fb, &mut rgba);
            (
                rgba,
                framebuffer::WIDTH as usize,
                framebuffer::HEIGHT as usize,
                g.log.iter().cloned().collect::<Vec<_>>(),
                g.values.clone(),
            )
        };

        let image = egui::ColorImage::from_rgba_unmultiplied([w, h], &rgba);
        match &mut self.texture {
            Some(t) => t.set(image, egui::TextureOptions::NEAREST),
            None => {
                self.texture =
                    Some(ctx.load_texture("framebuffer", image, egui::TextureOptions::NEAREST));
            }
        }

        egui::Panel::top("values").show_inside(ui, |ui| {
            ui.add_space(4.0);
            ui.horizontal_wrapped(|ui| {
                if values.is_empty() {
                    ui.weak("(no values decoded yet)");
                }
                for (name, v) in &values {
                    ui.group(|ui| {
                        ui.vertical(|ui| {
                            ui.weak(*name);
                            ui.label(egui::RichText::new(v).strong().size(22.0).monospace());
                        });
                    });
                }
            });
            ui.add_space(4.0);
        });

        egui::Panel::right("log")
            .resizable(true)
            .default_size(300.0)
            .show_inside(ui, |ui| {
                ui.heading("Recent activity");
                egui::ScrollArea::vertical().show(ui, |ui| {
                    for entry in log.iter().rev() {
                        match entry {
                            LogEntry::Msg(s) => {
                                ui.colored_label(egui::Color32::LIGHT_BLUE, format!("• {s}"));
                            }
                            LogEntry::Tx(tx) => {
                                ui.label(format_tx(tx));
                            }
                        }
                    }
                });
            });

        egui::CentralPanel::default().show_inside(ui, |ui| {
            if let Some(t) = &self.texture {
                let avail = ui.available_size();
                let aspect = w as f32 / h as f32;
                let target_w = (avail.y * aspect).min(avail.x);
                let target_h = target_w / aspect;
                ui.image((t.id(), egui::vec2(target_w, target_h)));
            }
        });

        ctx.request_repaint_after(Duration::from_millis(33));
    }
}
