drinkcat/aq-lcd-grab/pcb/aq_lcd_grab_sklib.py

from collections import defaultdict
from skidl import Pin, Part, Alias, SchLib, SKIDL, TEMPLATE

from skidl.pin import pin_types

SKIDL_lib_version = '0.0.1'

aq_lcd_grab = SchLib(tool=SKIDL).add_parts(*[
        Part(**{ 'name':'Conn_01x39_Socket', 'dest':TEMPLATE, 'tool':SKIDL, 'aliases':Alias({'Conn_01x39_Socket'}), 'ref_prefix':'J', 'fplist':[''], 'footprint':'FH26W:FH26W39S03SHW60', 'keywords':'connector', 'description':'Generic connector, single row, 01x39, script generated', 'datasheet':'', 'pins':[
            Pin(num='1',name='Pin_1',func=pin_types.PASSIVE,unit=1),
            Pin(num='2',name='Pin_2',func=pin_types.PASSIVE,unit=1),
            Pin(num='3',name='Pin_3',func=pin_types.PASSIVE,unit=1),
            Pin(num='4',name='Pin_4',func=pin_types.PASSIVE,unit=1),
            Pin(num='5',name='Pin_5',func=pin_types.PASSIVE,unit=1),
            Pin(num='6',name='Pin_6',func=pin_types.PASSIVE,unit=1),
            Pin(num='7',name='Pin_7',func=pin_types.PASSIVE,unit=1),
            Pin(num='8',name='Pin_8',func=pin_types.PASSIVE,unit=1),
            Pin(num='9',name='Pin_9',func=pin_types.PASSIVE,unit=1),
            Pin(num='10',name='Pin_10',func=pin_types.PASSIVE,unit=1),
            Pin(num='11',name='Pin_11',func=pin_types.PASSIVE,unit=1),
            Pin(num='12',name='Pin_12',func=pin_types.PASSIVE,unit=1),
            Pin(num='13',name='Pin_13',func=pin_types.PASSIVE,unit=1),
            Pin(num='14',name='Pin_14',func=pin_types.PASSIVE,unit=1),
            Pin(num='15',name='Pin_15',func=pin_types.PASSIVE,unit=1),
            Pin(num='16',name='Pin_16',func=pin_types.PASSIVE,unit=1),
            Pin(num='17',name='Pin_17',func=pin_types.PASSIVE,unit=1),
            Pin(num='18',name='Pin_18',func=pin_types.PASSIVE,unit=1),
            Pin(num='19',name='Pin_19',func=pin_types.PASSIVE,unit=1),
            Pin(num='20',name='Pin_20',func=pin_types.PASSIVE,unit=1),
            Pin(num='21',name='Pin_21',func=pin_types.PASSIVE,unit=1),
            Pin(num='22',name='Pin_22',func=pin_types.PASSIVE,unit=1),
            Pin(num='23',name='Pin_23',func=pin_types.PASSIVE,unit=1),
            Pin(num='24',name='Pin_24',func=pin_types.PASSIVE,unit=1),
            Pin(num='25',name='Pin_25',func=pin_types.PASSIVE,unit=1),
            Pin(num='26',name='Pin_26',func=pin_types.PASSIVE,unit=1),
            Pin(num='27',name='Pin_27',func=pin_types.PASSIVE,unit=1),
            Pin(num='28',name='Pin_28',func=pin_types.PASSIVE,unit=1),
            Pin(num='29',name='Pin_29',func=pin_types.PASSIVE,unit=1),
            Pin(num='30',name='Pin_30',func=pin_types.PASSIVE,unit=1),
            Pin(num='31',name='Pin_31',func=pin_types.PASSIVE,unit=1),
            Pin(num='32',name='Pin_32',func=pin_types.PASSIVE,unit=1),
            Pin(num='33',name='Pin_33',func=pin_types.PASSIVE,unit=1),
            Pin(num='34',name='Pin_34',func=pin_types.PASSIVE,unit=1),
            Pin(num='35',name='Pin_35',func=pin_types.PASSIVE,unit=1),
            Pin(num='36',name='Pin_36',func=pin_types.PASSIVE,unit=1),
            Pin(num='37',name='Pin_37',func=pin_types.PASSIVE,unit=1),
            Pin(num='38',name='Pin_38',func=pin_types.PASSIVE,unit=1),
            Pin(num='39',name='Pin_39',func=pin_types.PASSIVE,unit=1)], 'unit_defs':[] }),
        Part(**{ 'name':'R', 'dest':TEMPLATE, 'tool':SKIDL, 'aliases':Alias({'R'}), 'ref_prefix':'R', 'fplist':[''], 'footprint':'Resistor_SMD:R_0402_1005Metric', 'keywords':'R res resistor', 'description':'Resistor', 'datasheet':'', 'pins':[
            Pin(num='1',func=pin_types.PASSIVE,unit=1),
            Pin(num='2',func=pin_types.PASSIVE,unit=1)], 'unit_defs':[] }),
        Part(**{ 'name':'Conn_01x03_Socket', 'dest':TEMPLATE, 'tool':SKIDL, 'aliases':Alias({'Conn_01x03_Socket'}), 'ref_prefix':'J', 'fplist':[''], 'footprint':'Connector_PinHeader_2.54mm:PinHeader_1x03_P2.54mm_Vertical', 'keywords':'connector', 'description':'Generic connector, single row, 01x03, script generated', 'datasheet':'', 'pins':[
            Pin(num='1',name='Pin_1',func=pin_types.PASSIVE,unit=1),
            Pin(num='2',name='Pin_2',func=pin_types.PASSIVE,unit=1),
            Pin(num='3',name='Pin_3',func=pin_types.PASSIVE,unit=1)], 'unit_defs':[] }),
        Part(**{ 'name':'Conn_01x02_Socket', 'dest':TEMPLATE, 'tool':SKIDL, 'aliases':Alias({'Conn_01x02_Socket'}), 'ref_prefix':'J', 'fplist':[''], 'footprint':'Connector_PinHeader_2.54mm:PinHeader_1x02_P2.54mm_Vertical', 'keywords':'connector', 'description':'Generic connector, single row, 01x02, script generated', 'datasheet':'', 'pins':[
            Pin(num='1',name='Pin_1',func=pin_types.PASSIVE,unit=1),
            Pin(num='2',name='Pin_2',func=pin_types.PASSIVE,unit=1)], 'unit_defs':[] }),
        Part(**{ 'name':'MountingHole', 'dest':TEMPLATE, 'tool':SKIDL, 'aliases':Alias({'MountingHole'}), 'ref_prefix':'H', 'fplist':[''], 'footprint':'MountingHole:ToolingHole_1.152mm', 'keywords':'mounting hole', 'description':'Mounting Hole without connection', 'datasheet':'' }),
        Part(**{ 'name':'STM32F103C8Tx', 'dest':TEMPLATE, 'tool':SKIDL, 'aliases':Alias({'STM32F103C8Tx'}), 'ref_prefix':'U', 'fplist':['Package_QFP:LQFP-48_7x7mm_P0.5mm', 'Package_QFP:LQFP-48_7x7mm_P0.5mm'], 'footprint':'Package_QFP:LQFP-48_7x7mm_P0.5mm', 'keywords':'Arm Cortex-M3 STM32F1 STM32F103', 'description':'STMicroelectronics Arm Cortex-M3 MCU, 64KB flash, 20KB RAM, 72 MHz, 2.0-3.6V, 37 GPIO, LQFP48', 'datasheet':'https://www.st.com/resource/en/datasheet/stm32f103c8.pdf', 'pins':[
            Pin(num='1',name='VBAT',func=pin_types.PWRIN,unit=1),
            Pin(num='2',name='PC13',func=pin_types.BIDIR,unit=1),
            Pin(num='3',name='PC14',func=pin_types.BIDIR,unit=1),
            Pin(num='4',name='PC15',func=pin_types.BIDIR,unit=1),
            Pin(num='5',name='PD0',func=pin_types.BIDIR,unit=1),
            Pin(num='6',name='PD1',func=pin_types.BIDIR,unit=1),
            Pin(num='7',name='NRST',func=pin_types.INPUT,unit=1),
            Pin(num='8',name='VSSA',func=pin_types.PWRIN,unit=1),
            Pin(num='9',name='VDDA',func=pin_types.PWRIN,unit=1),
            Pin(num='10',name='PA0',func=pin_types.BIDIR,unit=1),
            Pin(num='11',name='PA1',func=pin_types.BIDIR,unit=1),
            Pin(num='12',name='PA2',func=pin_types.BIDIR,unit=1),
            Pin(num='13',name='PA3',func=pin_types.BIDIR,unit=1),
            Pin(num='14',name='PA4',func=pin_types.BIDIR,unit=1),
            Pin(num='15',name='PA5',func=pin_types.BIDIR,unit=1),
            Pin(num='16',name='PA6',func=pin_types.BIDIR,unit=1),
            Pin(num='17',name='PA7',func=pin_types.BIDIR,unit=1),
            Pin(num='18',name='PB0',func=pin_types.BIDIR,unit=1),
            Pin(num='19',name='PB1',func=pin_types.BIDIR,unit=1),
            Pin(num='20',name='PB2',func=pin_types.BIDIR,unit=1),
            Pin(num='21',name='PB10',func=pin_types.BIDIR,unit=1),
            Pin(num='22',name='PB11',func=pin_types.BIDIR,unit=1),
            Pin(num='23',name='VSS',func=pin_types.PWRIN,unit=1),
            Pin(num='24',name='VDD',func=pin_types.PWRIN,unit=1),
            Pin(num='25',name='PB12',func=pin_types.BIDIR,unit=1),
            Pin(num='26',name='PB13',func=pin_types.BIDIR,unit=1),
            Pin(num='27',name='PB14',func=pin_types.BIDIR,unit=1),
            Pin(num='28',name='PB15',func=pin_types.BIDIR,unit=1),
            Pin(num='29',name='PA8',func=pin_types.BIDIR,unit=1),
            Pin(num='30',name='PA9',func=pin_types.BIDIR,unit=1),
            Pin(num='31',name='PA10',func=pin_types.BIDIR,unit=1),
            Pin(num='32',name='PA11',func=pin_types.BIDIR,unit=1),
            Pin(num='33',name='PA12',func=pin_types.BIDIR,unit=1),
            Pin(num='34',name='PA13',func=pin_types.BIDIR,unit=1),
            Pin(num='35',name='VSS',func=pin_types.PASSIVE,unit=1),
            Pin(num='36',name='VDD',func=pin_types.PWRIN,unit=1),
            Pin(num='37',name='PA14',func=pin_types.BIDIR,unit=1),
            Pin(num='38',name='PA15',func=pin_types.BIDIR,unit=1),
            Pin(num='39',name='PB3',func=pin_types.BIDIR,unit=1),
            Pin(num='40',name='PB4',func=pin_types.BIDIR,unit=1),
            Pin(num='41',name='PB5',func=pin_types.BIDIR,unit=1),
            Pin(num='42',name='PB6',func=pin_types.BIDIR,unit=1),
            Pin(num='43',name='PB7',func=pin_types.BIDIR,unit=1),
            Pin(num='44',name='BOOT0',func=pin_types.INPUT,unit=1),
            Pin(num='45',name='PB8',func=pin_types.BIDIR,unit=1),
            Pin(num='46',name='PB9',func=pin_types.BIDIR,unit=1),
            Pin(num='47',name='VSS',func=pin_types.PASSIVE,unit=1),
            Pin(num='48',name='VDD',func=pin_types.PWRIN,unit=1)], 'unit_defs':[] }),
        Part(**{ 'name':'C', 'dest':TEMPLATE, 'tool':SKIDL, 'aliases':Alias({'C'}), 'ref_prefix':'C', 'fplist':[''], 'footprint':'Capacitor_SMD:C_0402_1005Metric', 'keywords':'cap capacitor', 'description':'Unpolarized capacitor', 'datasheet':'', 'pins':[
            Pin(num='1',func=pin_types.PASSIVE,unit=1),
            Pin(num='2',func=pin_types.PASSIVE,unit=1)], 'unit_defs':[] }),
        Part(**{ 'name':'Conn_01x03_Pin', 'dest':TEMPLATE, 'tool':SKIDL, 'aliases':Alias({'Conn_01x03_Pin'}), 'ref_prefix':'J', 'fplist':[''], 'footprint':'Connector_PinHeader_2.54mm:PinHeader_1x03_P2.54mm_Vertical', 'keywords':'connector', 'description':'Generic connector, single row, 01x03, script generated', 'datasheet':'', 'pins':[
            Pin(num='1',name='Pin_1',func=pin_types.PASSIVE,unit=1),
            Pin(num='2',name='Pin_2',func=pin_types.PASSIVE,unit=1),
            Pin(num='3',name='Pin_3',func=pin_types.PASSIVE,unit=1)], 'unit_defs':[] }),
        Part(**{ 'name':'LED', 'dest':TEMPLATE, 'tool':SKIDL, 'aliases':Alias({'LED'}), 'ref_prefix':'D', 'fplist':[''], 'footprint':'LED_SMD:LED_0603_1608Metric', 'keywords':'LED diode', 'description':'Light emitting diode', 'datasheet':'', 'pins':[
            Pin(num='1',name='K',func=pin_types.PASSIVE,unit=1),
            Pin(num='2',name='A',func=pin_types.PASSIVE,unit=1)], 'unit_defs':[] }),
        Part(**{ 'name':'TestPoint', 'dest':TEMPLATE, 'tool':SKIDL, 'aliases':Alias({'TestPoint'}), 'ref_prefix':'TP', 'fplist':[''], 'footprint':'test_points:TestPoint_Pad_0.5x0.5mm', 'keywords':'test point tp', 'description':'test point', 'datasheet':'', 'pins':[
            Pin(num='1',name='1',func=pin_types.PASSIVE,unit=1)], 'unit_defs':[] }),
        Part(**{ 'name':'Conn_01x14', 'dest':TEMPLATE, 'tool':SKIDL, 'aliases':Alias({'Conn_01x14'}), 'ref_prefix':'J', 'fplist':[''], 'footprint':'esp32c6:XIAO-ESP32-C6-DIP', 'keywords':'connector', 'description':'Generic connector, single row, 01x14, script generated (kicad-library-utils/schlib/autogen/connector/)', 'datasheet':'', 'pins':[
            Pin(num='1',name='Pin_1',func=pin_types.PASSIVE,unit=1),
            Pin(num='2',name='Pin_2',func=pin_types.PASSIVE,unit=1),
            Pin(num='3',name='Pin_3',func=pin_types.PASSIVE,unit=1),
            Pin(num='4',name='Pin_4',func=pin_types.PASSIVE,unit=1),
            Pin(num='5',name='Pin_5',func=pin_types.PASSIVE,unit=1),
            Pin(num='6',name='Pin_6',func=pin_types.PASSIVE,unit=1),
            Pin(num='7',name='Pin_7',func=pin_types.PASSIVE,unit=1),
            Pin(num='8',name='Pin_8',func=pin_types.PASSIVE,unit=1),
            Pin(num='9',name='Pin_9',func=pin_types.PASSIVE,unit=1),
            Pin(num='10',name='Pin_10',func=pin_types.PASSIVE,unit=1),
            Pin(num='11',name='Pin_11',func=pin_types.PASSIVE,unit=1),
            Pin(num='12',name='Pin_12',func=pin_types.PASSIVE,unit=1),
            Pin(num='13',name='Pin_13',func=pin_types.PASSIVE,unit=1),
            Pin(num='14',name='Pin_14',func=pin_types.PASSIVE,unit=1)], 'unit_defs':[] })])
