drinkcat/aq-lcd-grab/(commit log)

2026-05-15 Add Pico 2 W hello world firmware
    Embassy on RP2350, USB CDC serial logger ticking once per 500 ms.
    Verified end-to-end via /dev/ttyACM0.
    Toolchain note in firmware/README.md: must install elf2uf2-rs from
    git (not crates.io v2.2.0, which silently produces RP2040-family UF2s
    that the RP2350 boot ROM rejects).
2026-05-15 Prune unused firmware deps
    embassy-usb, embassy-futures, static_cell are not referenced in
    main.rs — embassy-usb-logger pulls in embassy-usb transitively.
    cargo build --release, cargo fmt --check, and
    cargo clippy --release -- -D warnings all clean.
2026-05-15 Add PIO+DMA capture proof-of-concept
    pio_capture.rs sets up PIO0 SM0 with a 3-instruction program that
    waits for WR (GPIO 18) low->high, then samples {CS, DC, DB15..DB0}
    into a 18-bit FIFO word. DMA channel drains the FIFO into a static
    buffer. main.rs awaits one full 4096-word buffer per loop and dumps
    the first 32 decoded samples over USB CDC.
    Verified booting on the Pico 2 W: USB CDC up, "waiting for samples"
    log emitted, await correctly suspends on a floating WR pin.
    Pending: real target capture or a self-test signal generator.
    Note: Capture struct retains `Common<'d, PIO0>` because dropping it
    runs on_pio_drop() which reverts all claimed pin funcsels to NULL
    and silently kills the run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
    [main.rs, pio_capture.rs]
2026-05-15 Switch flash runner from elf2uf2-rs to picotool
    `picotool load -u -v -x -t elf` flashes, verifies, and executes the
    ELF in one command over the BOOTSEL USB interface — no mass-storage
    mount, no family-ID footgun, no fork-of-fork install. Verified
    end-to-end: cargo run --release boots the firmware directly from
    BOOTSEL with progress bars and an "OK" line.
    Still need to enter BOOTSEL manually (hold button + replug) since
    embassy-usb-logger doesn't expose the picotool reset interface. A
    future firmware change could wire `embassy_rp::rom_data::reset_to_usb_boot`
    into a USB control handler to skip that step too.
    Also refresh README to reflect the new flow and the PIO PoC.
2026-05-15 Eliminate BOOTSEL dance via picotool reset interface
    Adds a vendor-specific USB interface (class 0xff / subclass 0x00 /
    protocol 0x01) with a control-request handler that calls the boot ROM's
    `reset_to_usb_boot()` when picotool sends `bRequest=0x01` to that
    interface. Combined with embassy-usb's CDC ACM logger, the device now
    runs three concurrent futures: USB device pump, logger pump, and the
    PIO capture loop.
    The cargo runner is now `scripts/flash.sh`, which:
    - Goes straight to `picotool load` if the device is already in BOOTSEL.
    - Triggers the reset interface + waits for BOOTSEL re-enumeration if
    the device is running our firmware.
    Wraps around a picotool quirk: with `-f`, picot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
    [main.rs, picotool_reset.rs]
2026-05-15 PoC captures real ILI9488/ST7796 traffic from the target
    Two changes that, together, turned the first live capture from "only
    the top two bits ever toggle" into recognizable bus traffic:
    1. PIO shift_in direction: Right -> Left.
    With shift_right, autopush at threshold=18 leaves the sampled bits
    in the upper 18 bits of the pushed u32 (bits 14..31), not at the
    bottom. Our decode read `sample & 0xFFFF`, so it was reading
    GPIO0/GPIO1 from positions 14/15 of the word and interpreting them
    as DB14/DB15 — exactly the "only top bits change" symptom we saw.
    shift_left puts pin_base+0 at ISR bit 0; decode now matches the
    ascii layout in the module comment.
    2. Full-buffer comp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
2026-05-15 Add host/ Rust+egui viewer for target capture stream
    Reads the firmware's text dump from /dev/ttyACM0 (or a replay file),
    decodes the 18-bit packed samples back into bus events, splits them into
    transactions on DC transitions, and replays SET_COLUMN_ADDRESS /
    SET_ROW_ADDRESS / MEMORY_WRITE into a 320x480 RGB565 framebuffer
    displayed in an egui window. A side panel lists recent transactions
    with their ILI9488 command names and a hex preview of the data.
    Modules: sample, parser, decoder, framebuffer, plus the eframe app in
    main.rs. Reader thread + UI thread share state via Arc<Mutex>.
    Two surprises about the live target traffic, fixed here in software so
    no firmware reflash is needed:
    1.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
    [decoder.rs, main.rs]
2026-05-15 Switch firmware->host stream from text dumps to binary frames
    The hex-dump approach was bursting one 4096-sample capture every ~8
    seconds, with the firmware spending ~5 s formatting + sending ~230 KB
    of ASCII per dump and a 3 s sleep between captures. On a 1-Hz burst
    cadence that was an 88% loss rate.
    Now:
    - Firmware decodes samples into transactions on-Pico (cmd byte + up
    to 4096 data words) and streams them as length-prefixed binary
    frames over USB CDC. Format documented in firmware/src/proto.rs
    and mirrored in host/src/wire.rs:
    [0xAA 0x55] magic
    [cmd u8] ILI9488 command byte, or 0xFF for log lines
    [count u16 LE] data-word count
    [data u16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
2026-05-15 Mirror viewer activity log to stdout
    Prints each captured frame and firmware log message to the terminal
    using the same formatting as the side panel, via a shared format_tx
    helper.
2026-05-15 Capture into a free-running PIO+DMA ring buffer
    Replaces the one-shot capture+gap loop with a 4 KB hardware ring that
    DMA continuously fills via TRIGGER_SELF + write-side ring_size, so no
    samples are dropped between bursts. The CPU drains the ring in 1 KB
    chunks by polling the DMA's write_addr against a software read cursor.
    Subtle gotcha worth flagging: rp235x DMA `ring_sel = true` wraps the
    write address, `false` wraps the read address. Getting that bit
    backwards is silently catastrophic — the peripheral read pointer isn't
    ring-aligned, the first transfer AHB-errors, embassy's DMA IRQ panics,
    and the chip wedges with no USB at all.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
    [main.rs, pio_capture.rs]
2026-05-15 Add LICENSE-APACHE and LICENSE-MIT
    The crates already declare `license = "MIT OR Apache-2.0"`; this
    materialises both license texts at the repo root.
2026-05-16 Reduce sample loss during sustained pixel bursts
    Three related fixes that together close most of the gaps in the
    captured stream during big MEMORY_WRITE bursts:
    * Decoder: when a non-MW transaction overflows its data buffer,
    keep the original cmd byte on the continuation frame instead of
    always tagging it MEMORY_WRITE_CONTINUE. Previously, a long DC=1
    burst on a stale 0xF0 (vendor) cmd would get mis-attributed and
    written into the framebuffer at whatever cursor was last set.
    * Ring buffer: bump from 1024 to 8192 samples (32 KB, the RP2350
    ring_size maximum). Gives ~8x more slack while USB CDC drains.
    * Drain loop: consume everything available per polling tick, not
    just one DRAIN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
    [decoder.rs, main.rs, pio_capture.rs]
2026-05-16 RLE-compress uniform pixel frames over USB
    Big background fills are usually a single color (0x0000 black, 0x07e0
    green), so a 4096-pixel MEMORY_WRITE_CONTINUE chunk that takes ~8 KB
    on the wire becomes ~9 bytes when run-length-encoded as one (len,
    value) pair. With the wire and CPU/USB time saved per frame, the
    ring buffer drains far faster during a sustained fill and we lose
    fewer samples to overrun.
    The high bit of the count field (RLE_FLAG = 0x8000) marks an RLE
    payload; the data is then read as (length, value) u16 pairs. The
    host expands them at parse time so framebuffer / renderer code is
    untouched.
2026-05-16 Batch transactions per USB packet to keep up with tile bursts
    During UI tile bursts the target emits ~20 KHz of small MEMORY_WRITE
    transactions (16x12 tiles). Each was being sent as its own USB CDC
    packet, so we were packet-rate-limited at ~10 KHz regardless of
    bandwidth -- the decoder would block on TX_CHANNEL.send().await,
    the ring would overrun, and 0x2A/0x2B/0x2C boundaries got lost.
    Pack as many ready transactions as possible into the same 64-byte
    USB packet before flushing. The 0xAA55 magic at the start of each
    tx already self-delimits, so no host-side changes are needed. A
    BATCH_CAP keeps viewer latency bounded during sustained bursts.
    Also bump TX_CHANNEL capacity from 8 to 32 to g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
2026-05-16 Exit hard on window close and Ctrl-C
    The reader thread parks in a blocking serial read with a 60 s timeout,
    so returning from eframe::run_native would otherwise wait for it before
    the process exits. Hard-exit instead so window close is instant, and
    register a SIGINT handler so Ctrl-C in the terminal also kills the
    process immediately.
2026-05-16 Filter capture glitches at the WR falling edge
    Sample on WR falling edge, with a re-check: after WR drops we delay
    2 cycles then jmp-pin-restart if WR has bounced back high. Filters
    spurious phantom samples from ringing on the trailing edge of the
    previous WR pulse (most visible as drifting/slanted columns inside
    black-and-white text writes, where neighbouring pixels straddle
    0x0000 ↔ 0xFFFF transitions and the bus rings hardest).
    Also move CMD_LOG to 0xFE so 0xFF is free for legitimate but rare
    uses elsewhere; matching host change in wire.rs.
    [pio_capture.rs]
2026-05-17 Draft PCB design spec for ESP32-C6 + RP2350 capture board
    Captures the design decisions worked out for the next-iteration
    capture PCB: flashless RP2350 in UART boot mode loaded by a Xiao
    ESP32-C6, inline between the target's 39-pin display flexes.
    Records decided items (UART boot strapping, USB recovery header,
    power tap, decoupling, status LED) and the remaining open questions
    (3V3 headroom validation, mechanical/form factor, layer stack).
    Also rewords the DC/CS comment in pio_capture.rs — neither label is
    known-correct; both are empirical best guesses from observed framing
    behavior.
    [pio_capture.rs]
2026-05-17 Expand PCB spec: runtime UART, boot-time tradeoff, test points
    Captures additional design points worked out after the initial draft:
    - SD2/SD3 mux to hardware UART0 (F11 alt) for runtime ESP32 comms,
    so the boot UART pins do double duty after the bootrom hands off.
    - Documents the boot-latency tradeoff (UART boot ~6-7 s per power-on)
    vs RP2354B or external SPI flash + stub, and why UART boot still
    wins for this rarely-rebooted device.
    - Adds 5 contiguous edge test points on RP2350 GPIO 19-23, including
    UART1 (GPIO 20/21, F2 alt) as a hardware-UART bodge path in case
    SD2/SD3 runtime use turns out to have an issue.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
2026-05-18 Add KiCad PCB project with SKiDL-driven flex passthrough netlist
    Initial pcb/ folder with a KiCad 10 project for the inline capture
    PCB. Current scope is just the two 39-pin flex connectors as a
    straight pass-through (J1 main-board side ↔ J2 display side,
    mirrored numbering so traces run straight across); RP2350, ESP32-C6
    headers and supporting parts to be added in following commits.
    The netlist is generated by aq_lcd_grab.py (SKiDL) and imported into
    the .kicad_pcb via "Update PCB from netlist," with the schematic
    back-derived from the PCB via "Update Schematic from PCB" — no
    manual schematic editing.
    Also extends .gitignore to skip KiCad/SKiDL throwaways (locks,
    backups, autosaves, .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
    [aq_lcd_grab.kicad_pcb, aq_lcd_grab.kicad_sch]
2026-05-18 Add RP2350A to schematic, mirroring RPi minimal-board reference
    Build out the SKiDL netlist with the RP2350A core and its supporting
    components (decoupling, SMPS inductor, crystal, USB recovery header,
    status LED, bring-up test points, 3-pin target power connector).
    Components, values, and per-rail decoupling match Raspberry Pi's
    official "RP2350 Minimal Board" KiCad design 1:1 where possible:
    - RP2350_60QFN symbol + custom QFN-60 ThermalVias footprint
    - L1 = 3.3 µH polarised AOTA-B201610S3R3-101-T on L_pol_2016
    - Y1 = ABM8-272-T3 12 MHz crystal, 15 pF load caps
    - C1/C2 ADC_AVDD bulk + HF (no ferrite, per RPi)
    - C5 VREG_VIN input (10 µF, 0805)
    - C6/C7 +1V1 bulk near L1 o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
    [aq_lcd_grab.kicad_pcb]
2026-05-18 Add JLCPCB-targeted custom design rules
    aq_lcd_grab.kicad_dru — custom DRC rule set tuned to JLCPCB's PCB
    capabilities (min track widths per copper weight, hole sizes, edge
    clearances, hole-to-hole spacing, annular ring widths, pad/silk
    clearance). Adopted as-is from the gist references cited in the file
    header, lightly trimmed to the rules that apply to our process.
    The matching kicad_pro changes pick up KiCad's recorded DRC severity
    mapping and rule defaults that pair with the .kicad_dru.
2026-05-18 Replace SWD test points with a 3-pin debug header; drop redundant QSPI/USB_OTP decoupling
    Replace the two TestPoint pads for SWCLK/SWDIO with a proper 1×3
    2.54mm header (J5). Pin 1 (square pad) = SWCLK, pin 2 = GND, pin 3
    = SWDIO, matching the Raspberry Pi Debug Probe convention.
    Renumber the GPIO bring-up test points from TP3–TP7 down to TP1–TP5
    now that the SWD test points are gone.
    Also drop the dedicated 100 nF caps on QSPI_IOVDD (pin 54) and
    USB_OTP_VDD (pin 53). RPi's reference doesn't have these — those
    pins rely on the nearest IOVDD decoupling cap (C12-C17). We follow
    suit and tie both pins directly to +3V3.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
    [aq_lcd_grab.py, aq_lcd_grab_sklib.py]
2026-05-18 Wire Xiao ESP32-C6 into netlist (UART boot loader + PIC32 reset)
    Adds U2 (Xiao ESP32-C6 DIP module) to the SKiDL netlist with the
    core control signals defined in the PCB spec:
    - GPIO16 / GPIO17 (UART0 TX/RX) -> RP2350 QSPI_SD3 / SD2 for 1 Mbaud
    UART boot loading; remuxes to RP2350 PL011 UART0 (F11 alt) at runtime
    - GPIO0 -> RP2350 RUN (push-pull; R4 supplies the pull-up)
    - GPIO1 -> PIC32 reset on J3 pin 3 (open-drain; main board pull-up)
    - 3V3 backfeed on pad 12 (bypasses Xiao's onboard LDO)
    - 5V / VBUS tied to the USB recovery header rail
    Adds 22 uF + 100 uF bulk caps at the Xiao 3V3 input (C30/C31) to
    absorb WiFi TX transients locally instead of pushing them onto the
    targ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
    [aq_lcd_grab.kicad_pcb]
2026-05-18 Tap display flex bus into RP2350 GPIO 0-18 for PIO capture
    Branches the 16 data lines plus DC/CS/WR off the existing J1<->J2
    pass-through nets into RP2350 GPIOs 0-18. The flex traces still run
    straight across between connectors; the RP2350 just listens in.
    GPIO assignment mirrors the Pico 2 W prototype firmware byte-for-byte
    so pio_capture.rs's `in pins, N` from base GPIO 0 keeps working
    unchanged:
    GPIO 0-15 (RP2350 pads 2-19) -> DB0-DB15 (one contiguous QFN edge,
    pad 11 = IOVDD is the gap)
    GPIO 16 (pad 27) -> DC (8080 cmd/data framing)
    GPIO 17 (pad 28) -> CS (captured but not framed)
    GPIO 18 (pad 29)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
    [aq_lcd_grab.py]
2026-05-18 Cluster ESP32-C6 connections onto a single Xiao edge
    Moves RUN and PIC32_RESET to the Xiao's top-row pads so all
    connected pins land on pads 7-14 (one edge of the module). Pads
    1-6 are now intentionally unconnected, leaving the other edge free
    of traces during fanout.
    Pad 7 GPIO16 UART0 TX -> RP2350 UART RX (unchanged)
    Pad 8 GPIO17 UART0 RX <- RP2350 UART TX (unchanged)
    Pad 9 GPIO19 RUN drive (push-pull) (was pad 1 / GPIO0)
    Pad 10 GPIO20 PIC32 reset (open-drain) (was pad 2 / GPIO1)
    Pad 11 GPIO18 free / future side-channel
    Pads 12-14 3V3 / GND / 5V (fixed by module)
    GPIO19/20 carry no boot-strap or special-function constrai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
    [aq_lcd_grab.py]
2026-05-18 Match RP2350 decoupling network exactly to RPi reference
    Rewrites the decoupling block to mirror the Raspberry Pi RP2350
    "Minimal Board" reference design (reference/RP2350A_Minimal/) 1:1.
    The previous version had drifted in several ways while I wired in
    the ESP32 and tried to "approximate" the reference roles -- enough
    mistakes accumulated that an audit and rewrite was simpler than
    patching individual pins.
    Bugs fixed:
    - Pad 6 (DVDD #1) was dangling; now tied to +1V1.
    - Pad 23 (DVDD #2) was on VREG_AVDD (via the decouple() helper);
    now on +1V1 alongside pads 6 and 39.
    - C18 was a 100 nF on VREG_AVDD; reference puts it on +3V3 as a
    generic bypass. VREG_AVDD has no HF cap in the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
    [aq_lcd_grab.kicad_pcb]
2026-05-18 Shrink test points, name QSPI bootrom-strap nets, jumper SS strap
    Test points
    - Add project-local pcb/test_points.pretty/TestPoint_Pad_0.5x0.5mm
    footprint: 0.5 mm SMD pad, courtyard equal to pad (no margin),
    small 0.5 mm ref label on F.SilkS, no silk box, no value label.
    - Switch TP1-TP5 (GPIO19-23 bring-up pads) to the new footprint.
    The stock 1 mm pad with its 1 mm silk margin was way oversized
    for these tiny pads.
    QSPI bootrom straps
    - Replace the direct U1 pad 60 -> GND tie with a 0 Ω jumper (R22)
    so the BOOTSEL strap can be lifted by depopulating one resistor
    during debug.
    - Promote the two strap nets to proper names QSPI_SS_STRAP and
    QSPI_SD1_STRAP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
    [aq_lcd_grab.py, aq_lcd_grab_sklib.py]
2026-05-18 Re-import netlist into PCB
    Picks up the smaller test point footprint and the named QSPI strap
    nets from the previous commit, plus accumulated layout-side work
    from the KiCad session (component placement, routing in progress).
    [aq_lcd_grab.kicad_pcb]
2026-05-18 Track new PCB open questions; resolve Q3 (GPIO map) and Q11 (L1 polarity)
    New open questions raised during ESP32 + decoupling rewrite:
    - Q9: ground pour underneath the flex pass-through traces -- worth
    breaking or keep continuous?
    - target: source a JLCPCB basic-library flex connector compatible with
    the current FH26W footprint, or pick a cheaper alternative.
    Resolved questions:
    - Q3: kept the Pico 2 W prototype GPIO 0-18 mapping (firmware-
    transparent, naturally fits the QFN-60 edge pins).
    - Q11: inductor polarity matches the RPi reference (pad 1 = dot =
    +1V1; pad 2 = VREG_LX), verified against the reference PCB. No
    change needed despite the unconventional EMI-v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
2026-05-19 Swap RP2350 for STM32: spec to F103C8T6, PCB rewrite still on F030
    docs/pcb_spec.md: rewrite from the RP2350 + flashless UART-boot plan
    to STM32. Settle on STM32F103C8T6 after a brief detour through
    STM32F030C8T6 (kept as an in-spec addendum for the reasoning trail).
    Capture path moves from PIO + DMA ring to TIM1_ETR clocked from WR
    with multi-channel DMA reads of GPIOA/GPIOB; channel-to-event
    mapping verified against RM0008 Table 78. Pin map handles the F103
    specifics: USART1 permanently on PA9/PA10 (bootloader + runtime),
    SWD on PA13/PA14, TIM1_ETR on PA12, BOOT1=PB2 forces a pull-down
    and moves the status LED off that pin.
    pcb/: SKiDL netlist + KiCad PCB + netlist file are an in-progress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
    [aq_lcd_grab.kicad_pcb]
2026-05-19 Update PCB rewrite to STM32F103C8T6
    Picks up the F103 decision from the prior commit's spec change. Swaps
    the symbol to MCU_ST_STM32F1:STM32F103C8Tx, ties pin 1 (VBAT) to 3V3
    with its own 100 nF, adds the third VDD/VSS pair (pins 36/35) absent
    on F030, drops a 10 kΩ pull-down on PB2 (BOOT1 latch must be 0 at
    reset per AN2586 §4.1), and relocates the status LED from PB2 to PB5
    since PB2 can no longer host an active-high drive. Test-point list
    loses PB5 (now the LED) and gains a note that PB3/PB4 require
    AFIO_MAPR.SWJ_CFG=010 to free them from JTAG.
    [aq_lcd_grab.py, aq_lcd_grab_sklib.py]
2026-05-19 Straighten flex pass-through traces; add script that did the work
    Replaces each flex net's inner-layer routing (a length-tuning serpentine
    in many cases) with a single straight segment between the two F.Cu<->B.Cu
    vias. F.Cu fanout stubs and vias are untouched. 452 inner segments out,
    39 in.
    [aq_lcd_grab.kicad_pcb]
2026-05-19 Straightener: 45° jog plan based on top-via y-band
    J2 side now matches the hand-routed pattern: nets in the y=33.24 band
    dodge LEFT then RIGHT, y=36.04 nets dodge RIGHT then LEFT, even-pin
    nets (shallow bands, In1.Cu) go straight through. J1 side still uses
    J2 offsets verbatim — works for the shallow bands but the deep-band
    distances are wrong (J1 obstacles sit closer to the via), leaving DRC
    violations on adjacent same-layer pairs to clean up next.
    [aq_lcd_grab.kicad_pcb]
2026-05-19 Straightener: compute per-net jog offsets, achieve DRC clean
    For each deep-band flex net, derive the 45° jog offset from the nearest
    same-layer obstacle column's Δx, then add a small JOG_LEAD_IN so the
    diagonal corner sits clear of the obstacle's clearance circle. J2 and J1
    both get correct routing; 0 DRC violations on the flex pass-through bus.
    [aq_lcd_grab.kicad_pcb]
2026-05-19 Spec: loosen DB pin assignments, push order to host permutation
    Previously the spec pinned each DBn to a specific PA/PB pin,
    which made routing painful (PB scatter across opposite sides of
    LQFP-48). The capture path reads GPIOA->IDR and GPIOB->IDR as
    whole 16-bit ports anyway, so within-port pin order is just a
    relabeling. Move the constraint surface accordingly:
    - Hard constraints (silicon-forced) listed alone: PA9/PA10 USART1,
    PA12 TIM1_ETR, PA13/PA14 SWD, PB2 BOOT1, NRST, BOOT0.
    - DB bits become "8 pins from PA + 8 pins from PB" pools; DC/CS
    any free PB pins. Router picks the within-port order.
    - New Q17 covers the host-side LOGICAL_TO_PHYSICAL permutation
    table to be generated fro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
    [aq_lcd_grab.kicad_pcb]
2026-05-19 SKiDL: shuffle DBn-to-pin assignments, document order is arbitrary
    The capture mechanism reads GPIOA->IDR and GPIOB->IDR as whole 16-bit
    ports, so the host decoder picks up whatever within-port order the
    router chose via a permutation table derived from this netlist. Update
    CAPTURE_TAP accordingly: pick a permutation that routes more cleanly,
    and rewrite the surrounding comment to explain that only the
    silicon-forced constraints (WR=PA12, DC/CS on PB, ports stay
    separate) actually matter.
2026-05-19 Straightener: add staggered F.Cu/B.Cu escape vias on odd-DB nets
    Two-row stagger (y=52..54 and y=49..51) on DB1/3/5/7/9/11/13/15 leaves
    a ~0.9 mm horizontal lane on In1.Cu between rows for the next routing
    pass. Idempotent: re-running detects and replaces stale escape vias on
    those nets.
    [aq_lcd_grab.kicad_pcb]
2026-05-19 Straightener: In1.Cu mid-run dodge around odd-DB escape vias
    Even-DB nets (DB0/2/4/6/8/10/12/14) now route around the two staggered
    escape vias their adjacent odd-DB neighbors land in the middle stretch,
    using the same 45° jog logic. Also filter flex-pair vias by y-band so
    the rewriter keeps working idempotently after escape vias are added.
    [aq_lcd_grab.kicad_pcb]
2026-05-19 Rename script to route_lcd_bus.py; add DC escape via and width filter
    The script does more than straighten now — it adds escape vias and routes
    even-DB nets around them. Rename matches. Other changes:
    - Filter to width-0.1 segments so hand-routed traces (other widths) on
    the flex pass-through nets are left untouched.
    - Add EXTRA_ESCAPE_VIAS hook for non-DB nets, currently used to place
    DC just above DB15 (the highest staggered escape via). y is computed
    from the layout constants so it tracks ESCAPE_Y_STEP / ROW_GAP edits.
    - Pre-compute planned escape via positions into all_vias before the
    routing loop so first-run routing knows to dodge them.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
    [aq_lcd_grab.kicad_pcb]
2026-05-19 SKiDL: shuffle DBn-to-pin assignments, document order is arbitrary
    Reassigns DBn pins on the STM32 capture tap and moves the resulting
    shallow-band traces to B.Cu. The DB ordering is arbitrary on the wire —
    the firmware permutes them in software per docs/pcb_spec.md Q13.
    [aq_lcd_grab.kicad_pcb]
2026-05-19 route_lcd_bus: tighter doglegs, B.Cu width 0.13, flex-pair tolerance
    - Per-obstacle dogleg returns to column between obstacles, so the trace
    doesn't camp at offset longer than needed.
    - SCRIPT_LAYER_WIDTH lets each layer pick its trace width; B.Cu uses 0.13
    to satisfy outer-layer DRC. Legacy 0.1-width segments on script layers
    are still recognized and rewritten at the new width.
    - Tightened flex-band y tolerance (0.001 mm) so hand-placed off-bus vias
    near a band y aren't mistaken for flex pass-through vias (was breaking
    WR routing).
    [aq_lcd_grab.kicad_pcb]
2026-05-19 PCB: layout refresh after netlist re-import, relax zone fill rules
    Re-import of the updated SKiDL netlist into KiCad: refdes shuffling
    on the STM32 decoupling caps (C2..C5 reassigned by tag), placement
    adjustments, and a few extra components landing in the layout.
    Zone fill defaults bumped from 0.15 mm to 0.3 mm for both
    min_clearance and min_thickness — comfortable headroom over JLCPCB's
    standard 6/6 mil (~0.15 mm) capability so fills don't get thin
    filaments at narrow gaps.
    [aq_lcd_grab.kicad_pcb]
2026-05-20 Move status LED to PC13 to match Blue/Black Pill dev boards
    PC13 active-low with the same anode→1 kΩ→3V3 / cathode→GPIO topology
    is the onboard LED on STM32F103C8T6 Blue/Black Pills, so the same
    firmware blinks both the dev board and the production PCB without a
    per-target GPIO #ifdef. PB5 is freed back up as a spare test point.
    PC13 is in the F103 backup domain (low-drive: 3 mA, 2 MHz, not 5V
    tolerant per DS5319) — all well within spec for a <2 mA LED at
    sub-Hz blink rates.
2026-05-20 Spec cleanup + add flex-GND/UART/5V-tap jumpers and 5V tap header
    Spec: collapse a pile of recap-or-stale open questions (Q3/Q7/Q7b
    table, Q8 form-factor, Q9 GND-pour, Q11 inductor, Q12 DMA recap,
    Q13 fanout, Q14 SWO, Q16 RM0360) by either promoting the
    load-bearing parts into the main spec or dropping them outright.
    New main-spec sections: "Decoupling" under Power (promoted from Q7),
    "Flex GND tie" under Display capture tap (promoted from Q18), and
    a "Fallback if 3V3 headroom is insufficient" bullet under Power
    (promoted from Q20). target (JLCPCB part sourcing) expanded from
    flex-only to a full BOM cost review with a per-part table — the
    LED was flagged as having moved out of the basic li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
    [aq_lcd_grab.kicad_pcb]
2026-05-20 PCB: routing pass — more traces, placement nudges, zone refill
    Manual layout work on the KiCad PCB: ~32 net-new trace segments,
    a couple of additional vias, and ~80 placement adjustments. Zone
    fills recomputed against the new geometry. No SKiDL/netlist
    changes — this is layout work on top of the existing netlist.
    [aq_lcd_grab.kicad_pcb]
2026-05-21 firmware-stm32: hello-world bring-up for STM32F103C8T6
    PC13 LED blink at 1 Hz + USART1 PA9/PA10 @ 115200 emitting
    "hello from stm32f103 #N" once per second. HSI + PLL → 64 MHz, no
    external crystal — matches the no-crystal decision in pcb_spec.md.
    Brought up on a Blue Pill (F103C8T6) and flashed via stm32flash on
    USART1 ROM bootloader (cargo run wraps the script). Same flash path
    will be used by the ESP32 on the capture PCB.
2026-05-21 docs: capture-board STM32->host wire protocol
    Explicit START/STOP control with simple block/run/log/overrun frame
    tags, no magic bytes. Firmware stays dumb: raw (pa, pb) port reads
    with RLE, no protocol decoding. Host does the LOGICAL_TO_PHYSICAL
    permutation and ILI9488 decode.
2026-05-21 firmware-stm32: TIM1 ETR + dual-DMA capture, RLE wire protocol
    Builds (untested on hardware) the capture path described in
    docs/pcb_spec.md §"Capture mechanism" and frames samples per
    docs/wire_protocol.md:
    - capture.rs: TIM1 in external clock mode 2 (ECE=1), clocked by ETR=PA12.
    ARR=0 + CC1 OC with CCR=0 → both UEV and CC1 fire every WR edge.
    DIER.UDE + DIER.CC1DE enable parallel DMA into two circular rings:
    DMA1_CH2 reads GPIOA->IDR, DMA1_CH5 reads GPIOB->IDR. PA_MASK/PB_MASK
    zero off unused-bit noise before RLE so floating inputs don't break runs.
    - wire.rs: stateful encoder. Single samples accumulate into a tag=0x01
    block (up to 255), repeats collapse into a tag=0x02 run (u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
    [capture.rs, main.rs]
2026-05-23 firmware: switch Pico to the tagged wire protocol
    Replaces the Pico-specific 0xAA55-magic + ILI9488-cmd framing with the
    tag-based protocol in docs/wire_protocol.md, so the host can speak the
    same format to either the Pico or the F103 capture board. The Pico
    firmware no longer decodes 8080 transactions on-device — it just
    captures raw (pa, pb) samples (pa = DB0..DB15, pb bit 0 = CS, bit 1 =
    DC) and ships them out using the same RLE encoder as firmware-stm32.
    Architecture is now: PIO ring → drain+RLE-encode task → byte Pipe → USB
    CDC sender task. Per-frame staging in the sink keeps the wire stream
    parseable when the Pipe is full: whole frames get dropped (and counted)
    instead of torn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
    [decoder.rs, main.rs, pio_capture.rs]
2026-05-23 host: speak the tagged wire protocol
    The host used to parse the old Pico-specific 0xAA55-magic frames and
    consume an already-decoded `Frame { cmd, data: Vec<u16> }`. That layer
    is gone: the firmware now ships raw (pa, pb) port reads via the tagged
    protocol in docs/wire_protocol.md, and the host is responsible for
    applying the board's permutation table and running the 8080 bus
    framing itself.
    New layout:
    - host/src/wire.rs: incremental decoder for tag-based frames. Emits a
    high-level Event { Block, Run, Overrun, Log, Started, Stopped }.
    - host/src/permute.rs: board-specific (pa, pb) -> (data, dc, cs). One
    entry (Pico) for now; the F103 board gains an entry alongside when
    it's brought u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
2026-05-23 firmware: surface TX-pipe drops as tag=0xFD overrun frames
    The capture-side PIO ring drops were already getting their own
    tag=0xFD on the wire; pipe-side drops (encoder produced a frame the
    TX pipe couldn't fit) were only visible via the STATS log line. That
    made it tedious to diagnose missing pixels — the host would see a
    clean stream with a gap and no marker for where the gap landed.
    PipeSink now peeks at the staged frame's tag/n on a drop and folds
    the lost sample count into `pending_dropped_samples`. The capture
    task drains both counters (capture.take_dropped() + sink.take_dropped_samples())
    at the same point it already emits the PIO-ring overrun frame, so
    both kinds of loss arrive on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
    [main.rs]
2026-05-24 firmware-stm32: auto-reset flashing via FTDI DTR+RTS
    Wire DTR->BOOT0 and RTS->NRST through 1k resistors so stm32flash can
    enter the ROM bootloader and reset into user code without touching the
    board. TTL FT232R outputs invert relative to stm32flash's RS-232
    convention, hence the leading '-' on each token.
2026-05-24 host: README with usage + usbmon debugging recipe
    Documents the basic viewer invocation and the usbmon/tshark recipe
    we used to confirm packet packing and burst behaviour during the
    boot-redraw investigation. Also notes the manual STATS request via
    `printf '\x04' > /dev/ttyACM0`, which the viewer doesn't yet expose
    in its UI.
2026-05-24 firmware-stm32: port Pico-side fixes to F103
    Brings the F103 firmware up to feature/correctness parity with the
    Pico after the wire-protocol bring-up:
    - wire.rs: encoder takes a packed u32 sample (low 16 = pa, high 16 =
    pb) instead of two u16s — one 32-bit compare on the hot path, and
    the byte emitter is just to_le_bytes(). Adds the block-flush-on-
    1→2 transition that the original encoder was getting wrong
    (samples reordered on the wire), and a Sink::commit_frame() hook
    so a finite-capacity sink can drop whole frames atomically rather
    than tearing them.
    - main.rs: ack-on-noop fix (replaces the Signal<StreamState> with a
    Channel<HostCmd> so STOP-while-stopped still produces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
    [capture.rs, main.rs]
2026-05-24 host: F103 board support — permute table + DTR/RTS clamp on open
    Two F103-specific changes that travel together:
    - Adds `permute_f103` matching the as-routed PCB pin assignment
    (PA0..7 = DB0..7; PB0..1 + PB3..8 = DB8..15; PB10 = DC, PB11 = CS).
    A `Board` CLI enum (`--board pico|f103`, default pico) picks
    between the Pico's identity-data permutation and the F103's.
    - Deasserts DTR and RTS immediately after opening the serial port.
    The F103 capture board wires DTR→BOOT0 and RTS→NRST through 1k
    resistors so `stm32flash` can drive both lines for auto-flash; the
    cost is that Linux's tty open() defaults *both* signals asserted,
    which on an FT232R TTL adapter means BOOT0 high +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
2026-05-24 firmware-stm32: move to TIM2/PA0 for Blue Pill bring-up [NOT WORKING]
    Reworks the capture front-end for a bench rig with a stock Blue Pill:
    - Switches from TIM1 (ETR=PA12) to TIM2 (ETR=PA0). The Blue Pill's
    built-in 1.5 kΩ USB-DP pull-up on PA12 distorts an externally
    driven WR signal. PA0 is clean.
    - Re-routes DB0 from PA0 (now WR) to PB9, and DB10/DB11 from PB3/PB4
    (JTAG TDO/NJTRST at reset; embassy doesn't disable SWJ) to
    PB12/PB13. Updates PA_MASK and PB_MASK to match.
    - Adds peek_cnt(), peek_smcr_cr1(), peek_dier(), peek_afio_mapr() for
    hardware-state diagnostics over the wire (log frames).
    - Switches CC1 from output-compare-FROZEN to input-capture from TI1
    (CH1 and ETR sh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
    [capture.rs, main.rs]
2026-05-24 host: update F103 permute + DTR/RTS reset pulse on viewer open
    Follows the firmware-side rewiring (see previous commit):
    - permute_f103 now reflects the bench routing: DB0 is on PB9 (off
    PA0, which is now WR/ETR) and DB10/DB11 are on PB12/PB13 (off
    PB3/PB4 to dodge JTAG). The PB→data extraction is in three
    non-contiguous groups; comment lists the full table.
    - DTR/RTS handling on serial open: instead of just clamping both
    signals deasserted, drive an explicit "reset into user code"
    pulse (DTR=true → BOOT0 low; RTS=true → NRST low; 20 ms;
    RTS=false → NRST high → boot). This both guarantees a fresh
    firmware state every viewer launch and overrides whatever
    spurious DT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
    [main.rs, permute.rs]
2026-05-25 firmware-stm32: dual input-capture (CC1+CC2 on TI1) + atomic sink
    The previous TIM2/PA0 attempt with CC1 in output-compare mode +
    UDE→DMA didn't work: with ARR=0 the counter never transitions into
    the compare match, so CC1IF never fires; and UDE→DMA1_CH2 also
    silently fails to fire with ARR=0 + ECE (verified empirically by
    peeking NDTR for 30 s — 0 transfers while CC1IF was happily firing
    every edge once we switched it to input-capture).
    Switch to both CC1 and CC2 in input-capture mode mapped to TI1.
    TIM2's CH1_ETR is one physical pin shared by ETR-clocking and both
    capture channels' inputs, so this gives us two independent DMA
    events per WR edge:
    TIM2_CH1 → CC1DE → DMA1_CH5 →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
    [capture.rs, main.rs]
2026-05-25 host: simpler sync handshake, factor out dispatch_event
    Two related cleanups to the reader thread:
    - Sync handshake (`sync`) used to call `scan_for` to find the
    STOPPED ack byte (0xFC) and the STARTED ack byte (0xFB) — but
    `scan_for` read up to 256 bytes per call and discarded the tail
    after the target byte. That meant any frame riding in the same
    read as the STARTED ack got eaten, and the main loop's first
    read would land mid-frame → unrecognised wire tag.
    Replace with "send STOP, drain until quiet (one 50 ms read
    timeout with no bytes), check that 0xFC appeared somewhere".
    Then "send START" and let the wire decoder in the main loop
    surface FB as Event::Started norma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
    [main.rs]
2026-05-25 docs: design notes for host viewer and firmware-stm32
    After several debugging sessions where we kept rediscovering the
    same architecture from scratch, write down what the host and the
    F103 firmware actually do — pipelines, threads/tasks, buffers,
    sync handshake, key design choices (and why we ended up with
    them, e.g. dual input-capture vs UDE-based DMA).
2026-05-25 host: carry samples as packed u32 end-to-end
    The wire format already encodes each sample as an LE u32
    (`pa | pb<<16`), and the firmware encoder works in u32 internally
    — but the host's wire decoder was splitting each u32 into two u16s
    (`Event::Block(Vec<(u16, u16)>)`, `Event::Run { pa, pb }`) just so
    the permute layer could re-combine them. Drop the split: emit
    `Event::Block(Vec<u32>)` / `Event::Run { sample: u32 }`, and have
    each `permute_*` take a `u32` and pull out the halves itself.
    Also adds a per-frame digest print at dispatch time (BLOCK shows
    n + first/last sample, RUN shows n + sample) so we can eyeball the
    wire shape while debugging without drowning stdout in 188-byte
    BLOCK bodi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
2026-05-25 docs: replace probed display pinout with datasheet-matched table
    Probed pinout was an educated guess based on signal shapes; matching
    against the 39-pin 3.5" TFT module datasheet pins down which lines
    are which. Pin 23 (probed as the ~500 ns low pulse every ~10 µs) is
    the panel's DC; pin 24 (~200 ns low pulse per WR) is CS.
2026-05-25 firmware-stm32: add STATS host command (0x04)
    Adds a lifetime cumulative dropped-samples counter in `Capture`
    (separate from the per-tick `dropped` that the overrun-frame path
    already drains), and an `HostCmd::Stats` handler that replies with
    a log frame `"stats: tx_dropped=XXXXXXXX cap_dropped=XXXXXXXX"`.
    Use it with `printf '\x04' > /dev/ttyUSB0` while the viewer is
    running — the host viewer opens the port non-exclusive so the poke
    gets through (see next commit).
2026-05-25 host: frame on CS for the F103 + per-sample debug dump
    Three threads of work, all related to figuring out what's actually
    on the bus:
    - bus_decoder: rename the framing parameter from `dc` to `is_data`.
    The bit that frames the bus isn't necessarily DC; on the F103
    bring-up we found the target's PIC32 holds DC high and uses CS as
    the cmd/data discriminator instead, so per-board `permute_*`
    picks the right signal.
    - permute_f103: return `(data, is_data)` with the CS bit (PB11) as
    the framing signal. After this, captured streams produce real
    0x2A/0x2B/0x2C transactions instead of misframed-as-data noise.
    Pixel-data bursts (long MEMORY_WRITE) still show CS pulsing per
    word, which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
    [bus_decoder.rs, main.rs, permute.rs]
2026-05-25 firmware (Pico): unswap DC/CS labels to match verified wiring
    The Pico's GPIO 16 carries the panel's CS line and GPIO 17 carries
    DC (Pico GPIO 16..18 → target FPC pin 22..24 = CS / DC / WR per the
    datasheet-matched pinout in docs/display_notes.md). The CapturePins
    struct had `dc: PIN_16, cs: PIN_17` — wrong direction — and the
    pio_capture.rs comment matched. The PIO `in pins, 19` samples both
    bits identically either way, so this was pure label confusion, not
    a functional bug.
    The host's `permute_pico` already framed on sample bit 17 (= GPIO
    17 = the actual DC line) and worked. Confirmed today by re-flashing
    the Pico and watching the viewer decode `0x2A SET_COLUMN_ADDRESS` /
    `0x2B SET_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
    [main.rs, permute.rs, pio_capture.rs]
2026-05-25 firmware (Pico): note cable colors in pin assignment table
    Add a Cable column so the table renders cleanly as markdown, and
    record which wire is which on the bench rig.
2026-05-25 firmware-stm32: re-routed Blue Pill wiring, frame on DC again
    New bench-rig layout (see firmware-stm32/README.md table):
    PA0 WR | PA1..PA7 DB0..DB6
    PB0..1 DB7..DB8 | PB5..9 DB11..DB15
    PB10..11 DB9..DB10 | PB12 DC | PB13 CS
    DC moves to its own pin (PB12) free of any board pull/conflict, so
    we can frame on DC like the Pico does instead of the CS-as-framing
    workaround the previous routing forced. Updates PA_MASK/PB_MASK
    docs (mask value unchanged — same set of PB bits in use) and the
    permute_f103 bit math + framing-bit selection.
    [capture.rs, permute.rs]
2026-05-25 firmware-stm32: loop on BufferedUart short-writes
    `<_ as embedded_io_async::Write>::write` on BufferedUartTx can return
    a short count when the interrupt-side TX ring is partially full. Our
    tx_fut was ignoring the return value, so under sustained load bytes
    were silently disappearing mid-frame — host parser hit "unrecognised
    wire tag" within a few seconds.
    Loop until everything's written. The atomic QueueSink already
    prevents torn frames at the encoder→queue boundary; this closes the
    matching hole at the queue→UART boundary.
    Verified end-to-end: 5672 lines of parsed output from the viewer
    with no parse errors (vs ~1188 lines before, ending in error).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
    [main.rs]
2026-05-25 firmware-stm32: sample on WR falling edge (matching the Pico PIO)
    The target's PIC32 deasserts DC slightly *before* WR rises — an 8080
    timing violation that's invisible to a slow logic analyzer but real
    on a 667 kHz bus. Sampling at WR's rising edge (ETP=NOT_INVERTED)
    catches DC already back to "data" for every byte, so command-byte
    samples look identical to data-byte samples to the host's bus
    decoder; nothing ever fires.
    The Pico PIO works around this by waiting for WR's falling edge,
    delaying 2 cycles, reconfirming WR is still low, then sampling
    (`firmware/src/pio_capture.rs`). Mirror the timing on TIM2 by
    flipping ETP and the two CC input-capture polarities to falling
    edge. After this,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
    [capture.rs]
2026-05-25 firmware-stm32: tighten ring overrun handling, bulk-pipe TX, smaller blocks
    Several related changes that materially reduce the ring-overrun rate
    on the F103 capture path:
    - capture.rs: on ring overrun, do a hard resync — stop TIM2, clear
    pending CC1IF/CC2IF/UIF status flags, clear both rings, restart
    TIM2. Embassy's `ring.clear()` is a soft reset that re-anchors each
    ring's read index to its DMA write position *independently*; with
    PA and PB DMAs at slightly different positions, the two reads
    sampled non-atomically caused ±1-sample drift in pair alignment,
    visible on the wire as corrupted command bytes (0x60 in place of
    0x2A etc., with adjacent-edge bytes "leaking" into eac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
    [capture.rs, main.rs]
2026-05-25 firmware-stm32 (wire): fix encoder fragmentation across run boundaries
    Encoder::feed's case (a) — "the in-flight run ended, the new sample
    differs" — flushed the run as expected but then `push_to_block(new
    sample)` instead of seeding the new sample as a fresh run-of-1.
    The next iteration would see `run_len=0` and seed a new run with
    the same sample (re-reading it from input, not from the block);
    the iteration after that would extend the run to length 2 and
    flush_block, emitting `BLOCK n=1 X` *containing the same value as
    the run that follows* (since the block held a copy of the new run's
    first sample). Result: every color transition fragmented into
    `BLOCK n=1 X / RUN n=N X` — wasted ba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
2026-05-25 firmware-stm32: async read_chunk + cap_fut restructure
    Replace the sync `capture.drain()` + 2 ms `Timer::after` sleep with
    an async `Capture::read_chunk(pa, pb, timeout)` that:
    - Awaits DMA progress via `pa_ring.read_exact` (parks the task
    until the DMA half- or full-transfer IRQ fires).
    - Times out after 10 ms so the housekeeping loop (cmd-queue drain,
    STATS heartbeat, encoder.flush on idle) still ticks during quiet
    bus periods.
    - Falls back to a best-effort sync drain on timeout.
    - Hard-resyncs (stop TIM2, clear CC flags, clear both rings,
    restart TIM2) on either-ring overrun, factored into a helper.
    cap_fut cleanups:
    - Early-continue when not STREAMING — clean separation, less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
    [capture.rs, main.rs]
2026-05-25 host: print raw u32 sample alongside permuted (D|C:data) in BLOCK/RUN dump
    Helps spot encoder fragmentation vs control-bit noise: if a same-
    looking color is split into BLOCK n=1 X / RUN n=N X, comparing the
    raw u32 between the two reveals whether the underlying samples
    were truly identical (encoder bug) or whether some control bit
    flickered between them.
    [main.rs]
2026-05-25 firmware-stm32: drop TX_PIPE, write straight into BufferedUart TX ring
    Encoder sink now holds &mut BufferedUartTx and spins on
    embedded_io::Write::write until each frame is fully enqueued. The
    old TX_PIPE + tx_fut staging layer is gone — one less future to
    schedule, ~1 KiB net RAM reclaimed (TX_PIPE 2 KiB removed,
    UART_TX_BUF bumped 1 KiB → 2 KiB to absorb bursts).
    commit_frame still does all-or-nothing per frame: the inner loop
    runs to completion so the host parser never sees a torn frame. At
    921600 baud the worst-case 264-byte frame spins ~2.9 ms, well under
    the DMA capture ring's headroom.
2026-05-25 firmware-stm32: yield once per cap_fut iteration
    After dropping TX_PIPE, the cap loop has no cooperative await point
    when samples are plentiful: `read_chunk` resolves immediately if its
    ring already has the requested count, and `commit_frame` now spins
    on `BufferedUartTx::write` instead of writing into an async pipe.
    Result: under sustained streaming, cap_fut monopolises the executor
    and the LED/RX tasks never get scheduled.
    Add an unconditional `yield_now` at the end of each iteration —
    cheap when nothing else is ready, and enough to keep the LED
    blinking and host commands responsive.
    [main.rs]
2026-05-25 firmware-stm32: encoder bytes flow straight into UART ring
    UartSink::push now writes each byte into BufferedUartTx directly;
    the 264 B scratch buffer and overflow accounting are gone, as is
    commit_frame (the trait default is a no-op). When the ring is full
    push spins on blocking_write until the ISR drains a byte.
    Per-byte critical-section overhead is ~20 µs on a 66 B data frame
    vs. ~0.3 µs for the old batched commit, but we're nowhere near
    saturating the 921600-baud wire and the encoder loop is the
    bottleneck anyway.
    tx_dropped diagnostic is dropped from STATS frames — it was always
    zero in practice since wire::encode_log already truncates to fit.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
2026-05-25 firmware-stm32: drain DMA on every wake, not in fixed 128-sample batches
    cap_fut used to await `read_chunk(want=128)`, which blocks until PA's
    read_exact fills the full requested slice. With RING_LEN=2048, embassy
    only wakes at the DMA half-/full-transfer IRQ (every N/2 = 1024
    samples), so waiting for 128 added a fixed batch latency on top of
    the unavoidable DMA wake granularity.
    New `Capture::read_available` is a poll_fn that registers PA's waker,
    then sync-drains whatever's currently in both rings via the existing
    `drain()`. Returns as soon as ≥1 paired sample landed; pending
    otherwise. cap_fut now selects between it and a 10 ms housekeeping
    timer, so the encoder sees data within one DM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
    [capture.rs, main.rs]
2026-05-25 firmware-stm32: sync-drain on timeout, drain DMA even while STOPPED
    Two related changes to keep the DMA rings from overrunning:
    1. On the 10 ms housekeeping timeout, do a sync `drain()` instead of
    discarding the wake. Samples may have landed in the rings but not
    yet crossed embassy's N/2 wake mark — the IRQ won't fire for them,
    only a direct ring read picks them up.
    2. Drop the early STOPPED-state shortcut so we still pull from the
    rings while stopped (then discard via take_dropped). DMA keeps
    running between STOP and the next START; without this, the rings
    fill up during the idle window and the first STREAMING drain
    immediately overruns.
    Also fix a stale RING_LEN d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
    [main.rs]
2026-05-25 firmware-stm32: Sink::write(&[u8]) — batched slice writes to UART
    Every encoder frame previously cost one Sink::push call per byte —
    each call doing the full BufferedUartTx::blocking_write dance
    (prologue/epilogue, ~4 atomic loads, two dmb sy barriers, ring
    state math). A 256-byte log line was ~258 separate function calls,
    each ~40 cycles of overhead, ~10k cycles total just to push the
    bytes.
    Drop the per-byte interface. Sink is now a single `write(&[u8])`
    method; UartSink::write loops `tx.write(buf)` on short-writes until
    the whole slice lands in the ring. The encoder hands contiguous
    frame segments (header, payload) — typically 2 write calls per
    frame instead of 66+. Atomics + barri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
    [main.rs]
2026-05-25 firmware-stm32: tight backlog drain + fuse PA/PB mask into encoder pack
    Two related cap_fut hot-path tweaks:
    1. Tight backlog drain. When read_available returns a full
    DRAIN_CHUNK, the rings probably have more samples queued behind
    it. Previously each chunk meant a fresh await + executor wake
    round-trip (~µs of scheduling per 128 samples). Now: keep calling
    capture.drain() synchronously until we get a partial chunk
    (rings ~empty). Naturally bounded — once drain rate exceeds fill
    rate the loop exits on its own.
    2. Mask fused into pack. The PA_MASK / PB_MASK passes inside drain()
    were two extra loops over the stack buffers we'd just written.
    Drop them; cap_fut now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
    [capture.rs, main.rs]
2026-05-25 firmware-stm32: fast_drain — skip embassy ring read on the hot path
    Embassy's ReadableRingBuffer::read does, per call into our drain:
    - 2x len() (each: NDTR sync + barrier + index math, ~50 cycles)
    - 128x read_volatile via read_buf(offset) which computes
    (pos + offset) % cap — and `cap` is a runtime usize, so the
    compiler emits a real udiv (~12 cycles on M3). 128 udivs = ~1500
    cycles just for the modulus, before the actual loads.
    Capture now snapshots the raw DMA-buffer pointers in `new` (the
    slice is still moved into ReadableRingBuffer for the async waker)
    and `fast_drain` reads samples directly: NDTR → write_pos, sync
    volatile loads at our own read index, pack PA|PB<<16, mask,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
    [capture.rs, main.rs]
2026-05-25 RUN frame length u16 + DMA TEIF counters + cap_fut perf isolation
    Three loosely-related changes from the dropped-data investigation:
    1. wire: RUN frame length widened from u8 to u16. A solid fill at
    667 kHz was emitting back-to-back n=255 RUN frames every 380 µs
    — ~20 frames per ~5000-sample fill, ~10 wire bytes each. The
    u16 cap (65535) absorbs ~100 ms of solid pixels in a single
    7-byte frame, ~20x less wire traffic for the long-fill case
    that dominates display traffic.
    Both firmware (Sink::write of the 2-byte length) and host
    parser (u16::from_le_bytes, 7-byte frame size) updated in
    lockstep. host dump format bumped to {:5} for the wider field.
    2. capture: Cap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
    [capture.rs, main.rs]
2026-05-27 firmware (Pico): fix pin order so PIO set_in_pins stays consecutive
    Commit 20f180cb1aad swapped the dc/cs field types in CapturePins
    (PIN_16↔PIN_17) but left the make_pio_pin call order as
    db15→dc→cs — now 15→17→16, no longer consecutive. embassy-rp's
    Config::set_in_pins runs assert_consecutive and panics on the
    gap; panic-halt then enters wfi and the chip silently wedges
    with no USB and no BOOTSEL fallback. Swap the two make_pio_pin
    calls so the order is db15→cs(16)→dc(17).
    The captured-word bit layout is unchanged — pa[0..16] is still
    DB0..DB15, pb bit 0 is CS, pb bit 1 is DC, matching the comment
    in main.rs.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
    [pio_capture.rs]
2026-05-27 firmware (Pico): widen TAG_RUN length to u16 to match host parser
    The STM32 build (commit e8e78af9520d) and the host parser both
    treat tag=0x02 RUN frames as `tag | len:u16 | sample:u32` (7
    bytes). The Pico's wire.rs still emitted u8 len (6 bytes), so the
    host read one length byte plus the first sample byte as the
    count, then four following bytes as the sample — desyncing the
    stream and tripping "unrecognised wire tag" on the next misread
    byte.
    Widen Encoder::run_len to u16 with MAX_RUN = u16::MAX, emit the
    length as 2 LE bytes, and update PipeSink::account_dropped to
    read 2 length bytes for TAG_RUN (still 1 for TAG_BLOCK).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
2026-05-27 TAG_TICK drain telemetry + host raw-dump flag
    Pico firmware emits a tag=0x03 TICK frame once per drain pass
    while streaming, carrying:
    - t_us: firmware Instant (low 32 bits, µs)
    - dt_us: wall-clock duration of the drain pass
    - n_drained: samples consumed in this pass
    - n_pending: samples still in the PIO/DMA ring after drain
    Enough to chart arrival rate vs drain throughput and watch the
    ring fill level without per-sample timestamps. STM32 firmware
    is unchanged.
    Host learns to parse and print TICK frames, and gains
    --raw-dump <FILE> which tees every byte read from the serial
    port (post-sync) into a file, replayable via --replay.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
2026-05-27 TICK rate-limit + delta semantics, REPEAT2 alternating-runs, encoder fixes
    Encoder
    - Fix spurious BLOCK n=1 sandwiched between two same-sample RUNs
    across drain boundaries: after flushing a run-of-≥2 in feed()'s
    path (a), seed a fresh run-of-1 with the new sample instead of
    pushing it to the block. A subsequent same-sample stream now
    merges into a single big RUN.
    - Add tag=0x04 REPEAT2: a sequence of alternating same-sample runs
    collapsed into one header (val_a:u32, val_b:u32) + 1 byte per
    run length + null terminator. Triggers on two ≤255-len runs of
    distinct values; folds further matching runs into a buffered
    scratch (REPEAT2_BUF_RUNS=512); closes on third value, run >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
    [main.rs]
2026-05-28 BLOCK: terminate with 0xffff_ffff sentinel, drop leading count
    Replace the tag=0x01 BLOCK frame's leading u8 count with a
    trailing 0xffff_ffff sentinel. The encoder no longer needs to
    know the sample count before writing the frame, and the format
    is no longer capped at 255 samples on the wire. 0xffff_ffff is
    never a legal sample (captures are masked to 18 bits on both
    boards), so it's an unambiguous terminator.
    Host scans 4-byte words until the sentinel; firmware's
    account_dropped derives the dropped sample count from the staged
    frame size (tag + 4·n + sentinel) instead of the old count byte.
    [main.rs]
2026-05-28 Move TICK to 0xFA telemetry range, REPEAT2 to 0x03
    TICK is out-of-band telemetry like OVERRUN/LOG/acks, so it
    belongs in the 0xFX range, not the low data-tag range next to
    BLOCK/RUN. Renumber TICK 0x03 → 0xFA and slide REPEAT2 0x04 →
    0x03 so the data tags stay contiguous (0x01 BLOCK, 0x02 RUN,
    0x03 REPEAT2). Reserved range becomes 0x04–0xF9.
    Update both wire.rs constants, stale tag references in code
    comments, and the spec. Drop the hand-written host-decode
    sketch from the spec — it had drifted (no REPEAT2 arm, old
    counted BLOCK) and host/src/wire.rs is authoritative.
    [main.rs]
2026-05-28 wire: new shared no_std crate with Sink trait + RUN/BLOCK encoder
    Start a shared wire-protocol crate that both firmware boards and the
    host can link, replacing the per-board copies of wire.rs that had
    drifted apart. This first pass covers the Sink trait (push + flush) and
    a buffer-free streaming Encoder for RUN and sentinel-terminated BLOCK
    frames, driven by a small State machine over a single (sample, len)
    run. Host unit tests assert exact wire bytes.
    REPEAT2, control frames, the decoder, and wiring the firmware/host
    crates to depend on this remain to be ported.
    [encoder.rs, lib.rs, sink.rs]
2026-05-28 wire: rename end_block -> go_idle, match on State
    Make the frame-termination helper state-agnostic: go_idle closes
    whatever frame is open and returns to Idle, which generalizes cleanly
    once REPEAT2 adds another open-frame state. Both go_idle and
    append_block now match on State exhaustively, so the unused PartialEq/Eq
    derives are dropped.
2026-05-28 wire: add push_u16/push_u32 helpers on Sink
    Collapse the repeated 'push each LE byte' loops in the encoder into
    typed Sink helpers (push_bytes/push_u16/push_u32), since to_le_bytes is
    an inherent method with no trait to be generic over.
2026-05-28 wire: add side-band signal frames; LOG becomes NUL-terminated
    Add started/stopped/log/overrun/tick as Encoder methods. Each closes an
    open BLOCK first (go_idle) so a side-band tag never lands inside a
    BLOCK's sample list; a pending RUN stays alive since it isn't on the
    sink yet, preserving cross-drain run merging.
    Switch LOG from a u16 length prefix to a 0x00 terminator so the payload
    streams straight to the wire with no length known up front and no cap
    (the sink bounds an overlong line). Callers must pass NUL-free text,
    which firmware log strings always are. Update the host parser to scan
    for the terminator and the protocol doc to match.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
2026-05-28 firmware (Pico): use shared wire crate, write-through PipeSink
    Point the Pico firmware at the shared `wire` crate and delete its local
    copy of wire.rs. Side-band frames are now Encoder methods
    (started/stopped/log/overrun/tick), and the host-command constants move
    into the crate.
    PipeSink becomes write-through: each byte goes straight to TX_PIPE and
    is dropped+counted when the pipe is full, rather than staging whole
    frames for atomic commit. The new encoder streams BLOCK bytes (no fixed
    upper bound), so per-frame staging no longer fits; the host already
    resyncs on a torn frame via STOP/drain/START. TX-pipe drops now surface
    as a byte count in STATS; OVERRUN reports only the sample-accurate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
    [lib.rs, main.rs]
2026-05-28 wire: port REPEAT2 with len-1 runs + confirmed-alternation opening
    Add the alternating-runs (tag 0x03) frame to the shared crate, but with
    two protocol refinements over the old buffered implementation:
    - A run of length 1 (a lone sample) may participate in a REPEAT2, both
    opening and extending it — captures thin one-pixel patterns toggling
    against a background (e.g. 7,7,7,1,7,7,7,1,... -> lens [3,1,3,1,...]).
    - A REPEAT2 opens only once three runs confirm an A,B,A alternation, so
    a short burst of distinct command bytes (which never repeat) stays a
    compact BLOCK instead of a string of wasteful tiny frames.
    Streaming, no run-length buffer: the header and each length byte go
    straigh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
    [encoder.rs, lib.rs]
2026-05-28 firmware-stm32: use shared wire crate
    Point the STM32 firmware at the shared `wire` crate and delete its local
    wire.rs, which had drifted to the old write(&[u8]) Sink and lacked
    REPEAT2/TICK. Side-band frames are now Encoder methods; the host-command
    constants come from the crate.
    UartSink implements the new push/flush Sink: push writes one byte and
    spins on a full TX ring (the UART TX ISR drains independently of the
    executor, so blocking never deadlocks here — unlike the Pico's
    cooperative TX pipe). flush is a no-op since the ISR drains on its own.
    Both boards now share one encoder/wire format.
    [main.rs]
2026-05-28 Re-route bench rig: GPIOB self-sufficient (commands + top colour bits)
    WR stays fixed on PA0. GPIOB now carries everything needed to decode
    the stream on its own — DC framing, the whole low byte DB0-DB7 (every
    opcode + low colour bits), and the two most colour-faithful bits of
    each of red (R4/R3) and green (G5/G4). So a GPIOB-only capture decodes
    all commands and renders recognisable colour even if the GPIOA-port
    DMA fails. GPIOA holds WR, the lower colour-refinement bits (G3,
    R0-R2), and CS (captured but unused; DC frames the bus). SWD disabled
    (SWJ_CFG) to free PA13-PA15.
    Bit priority comes from host/goodrun/run.bin: across 1.88M samples
    R4/R3 and G5/G4 give the lowest per-channel recon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
    [capture.rs, permute.rs]
2026-05-28 host: default serial port per board (Pico→ttyACM0, F103→ttyUSB0)
    The single hardcoded /dev/ttyACM0 default never matched the F103,
    which talks over an FTDI adapter on ttyUSB. Make --port optional and
    fall back to a per-board default. --port still overrides. Also refresh
    the stale F103 routing comment to point at permute_f103.
2026-05-28 firmware-stm32: configure data/control pins as floating inputs
    The capture reads GPIOA/B->IDR as whole ports but only ever configured
    the WR/ETR pin — the 18 data/control pins (DB0-15, DC, CS) were left in
    their reset/other-peripheral state. Undriven pins float and corrupt the
    IDR reads (0xffff floods that break RLE). Hand every wired pin to
    Capture::new (type-erased to AnyPin), configure each as Input(Pull::None)
    — the target drives the bus, so no pull to fight the driver — and hold them
    for 'd so the config persists.
    Also document that PA1/PA2/PA3 (TIM2_CH2/3/4) are safe as data inputs:
    CC2's capture input is remapped to TI1/PA0 and CC3/CC4 are unused, so
    the timer never claims thos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
    [capture.rs, main.rs]
2026-05-29 firmware-stm32: DMA-driven UART TX + polled RX, fix F1 EN handling
    Drive USART1 TX from a software circular buffer drained by re-armed,
    non-circular DMA transfers on DMA1_CH4, replacing the per-byte TXE ISR.
    Each transfer ships exactly the pending span and stops, so the wire goes
    silent when idle (a free-running circular DMA retransmits stale bytes).
    Key F1 gotcha: the bdma EN bit does NOT auto-clear at transfer-complete,
    so completion is detected via the TC flag (ISR.TCIF) and EN is cleared by
    hand before re-arming — otherwise only the first byte of the first frame
    ever shipped.
    Re-enable the host control path that the PERF test had disabled: boot
    STOPPED and poll USART RXNE each cap-lo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
    [capture.rs, main.rs]
2026-05-29 firmware-stm32: extract USART TX/RX transport into uart module
    Move the DMA TX ring (UartSink), USART1+DMA1_CH4 init, and RX polling out
    of main.rs into a new uart.rs. main shrinks ~190 lines; the transport is
    now behind a small API: UartSink::new(usart, tx, rx, dma) does all init
    and owns the ring + kept-alive USART halves, poll_rx() reads command
    bytes, kick() flushes a trailing burst. No behavior change.
2026-05-29 firmware-stm32: PC13 LED as cap-loop activity indicator
    Light the LED (set_low — PC13 is active-low) while the cap loop drains a
    capture burst, dark when idle/stopped. Drop the now-redundant
    `let _ = &led` keep-alive marker since led is actually used.
2026-05-29 treewide: clear clippy warnings, run cargo fmt, drop dead code
    Remove the disabled led_fut/rx_fut block (folded into the cap loop)
    and its orphaned imports; delete one-off peek_* debug helpers and keep
    the embassy-ring drain path behind #[allow(dead_code)]. Fix clippy
    lints (repeat_n, div_ceil, collapsible if-let, unit-valued DMA request)
    across all crates and apply rustfmt.
    [build.rs, capture.rs, decoder.rs, encoder.rs, main.rs, permute.rs, uart.rs]
2026-05-29 treewide: replace device-name mentions with neutral terms
    Use "target device", "main board", "target 3V3 rail", "bus driver",
    "capture target" etc. in place of specific device names throughout
    source, docs, and PCB netlist.
    [aq_lcd_grab.py, bus_decoder.rs, capture.rs, main.rs, pio_capture.rs]
2026-05-29 treewide: use TIM2/PA0 for WR on both bench rig and PCB; align pin mapping
    TIM1_ETR can only remap to PE7 (not present on LQFP-48), so PA12 was
    never a viable PCB option. Commit to TIM2/PA0 for both boards so one
    firmware covers both.
    Update CAPTURE_TAP in aq_lcd_grab.py to mirror the bench-rig routing
    exactly (PB5–PB12=DB0–DB7, PB0/PB1=DB14/DB15, PB13/PB14=DB9/DB10,
    PB15=DC, PA1=DB8, PA2–PA4=DB11–DB13, PA5=CS), regenerate netlist.
    Replace test point TP3 from PB5 (now DB0) to PA6.
    Update docs/pcb_spec.md: TIM2 capture mechanism, DMA channel table,
    suggested-allocation table reordered by flex pin number, pin pools and
    free-pool list corrected.
    Update firmware-stm32/README.md and c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
    [aq_lcd_grab.kicad_pcb]
2026-05-29 pcb/route_lcd_bus: add escape vias for first-row nets; kink In2.Cu around them
    - EXTRA_ESCAPE_VIAS replaces the single DC entry with a hardcoded list of
    (net, y) pairs, making it easy to adjust positions. DC, DB10, DB9, DB7,
    DB6, DB5, DB15, DB14 now each get an escape via placed at an explicit y.
    - DB7 and DB9 removed from ODD_DB_ESCAPE_ORDER; their escape vias are now
    managed via EXTRA_ESCAPE_VIAS along with DC and the even-DB nets.
    - ESCAPE_Y_START bumped to 57.6 so the topmost odd-DB via stays below the
    new first-row cluster.
    - dodge_mid_obstacles(): new helper that injects 45° doglegs into an
    existing polyline for obstacles in the middle stretch. Called from
    route_with_plan(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
    [aq_lcd_grab.kicad_pcb]
2026-05-29 pcb: test points on PA6/7/8; STM32 PA11 as second PIC32 reset driver
    - Replace test-point cluster (was PB3/PB4/PA6, required JTAG disable)
    with PA6/PA7/PA8 (pads 16/17/29) — all plain GPIO, no AF conflicts.
    - Add STM32 PA11 (pad 32) as a second open-drain driver for PIC32 reset,
    mirroring the existing ESP32 GPIO20 path. Both drivers wire through
    individual 0 Ω jumpers (R15 = ESP32 side, R16 = STM32 side) onto the
    shared PIC32_RESET net at J3 pin 3; break a jumper to isolate that
    driver without cutting the other.
    - Regen netlist and update KiCad PCB with new footprints / net names.
    - route_lcd_bus.py: rework escape-via placement (drop odd_db_escape_y
    helper, consolidate int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
    [aq_lcd_grab.kicad_pcb]
2026-05-30 docs: mark Q15, Q17, Q21 as done in pcb_spec
    - Q15 (Embassy STM32F1 support): confirmed working in firmware-stm32.
    - Q17 (host permutation table): implemented in host/src/permute.rs.
    - Q21 (PIC32 reset): both sub-items done — STM32 PA11 added as second
    open-drain driver (R16), power-on hold-low handled in firmware.
2026-05-30 docs: update Q10 BOM table to reflect current schematic
    Sync the BOM review table with the actual aq_lcd_grab.py state:
    - 6× 100nF (not 7; C8 is NRST filter, previously miscounted)
    - 7× 0Ω jumpers (R10–R16: 3 flex GND + 2 UART break + 2 PIC32 reset)
    - Separate rows for 1µF/4.7µF/22µF/100µF caps
    - J4 (1×2 header) added
    - Drop the "upcoming additions" footnote — Q18/Q19/Q21 passives are
    now committed in the schematic
2026-05-30 pcb: set correct manufacturer part values on J1/J2/U1
    SKiDL was inheriting the KiCad symbol name as the BOM value:
    - J1/J2: "Conn_01x39_Socket" → "FH26W-39S-0.3SHW(60)"
    - U1: "STM32F103C8Tx" (library wildcard name) → "STM32F103C8T6"
    Explicit value= overrides ensure the netlist and any BOM export
    from KiCad carries the orderable part number.
    [aq_lcd_grab.py]
2026-05-30 pcb: add 0 Ω break jumpers on NRST and BOOT0 from ESP32
    R17 (NRST_ESP → NRST) and R18 (BOOT0_ESP → BOOT0) let the ESP32 be
    isolated from both lines during bring-up, matching the existing UART
    and PIC32-reset jumper pattern. Update BOM table (9× 0 Ω total).
    [aq_lcd_grab.py]
2026-05-30 pcb: add tooling holes H1-H4, version label, LED part; fix LED/cap BOM notes
    - H1–H4: JLCPCB ToolingHole_1.152mm footprints added to netlist via SKiDL
    (place at board corners in KiCad before fab; exclude from BOM export).
    - Version label: aq_lcd_grab.py prints "Silkscreen label: v1-<hash>[-dirty]"
    after netlist generation; add as gr_text on F.SilkS manually in KiCad.
    - D1 value: GREEN → KT-0603R.
    - MountingHole added to aq_lcd_grab_sklib.py.
    - docs/pcb_spec.md Q10: add H1–H4 and TP1–3 rows, clarify C11/D1 status,
    note BOM exclusions.
    [aq_lcd_grab.py, aq_lcd_grab_sklib.py]
2026-05-30 pcb: place tooling holes, logo, v1 label; add logo footprint library
    - H1–H4 tooling holes placed at board corners (1.152 mm, JLCPCB spec).
    - logo:logo-1cm placed on silkscreen.
    - v1-<hash> label added to F.SilkS.
    - logo.pretty/ added to repo and registered in fp-lib-table.
    - kicad_pro: suppress DRC warnings for silk overlap/text height/thickness
    (logo footprint triggers these by design).
    [aq_lcd_grab.kicad_pcb]
2026-05-30 pcb: fix LED polarity — cathode is pin 1, anode is pin 2
    The KiCad Device:LED symbol has pin 1 = K (cathode) and pin 2 = A (anode).
    Previous wiring had them swapped. Correct path is:
    3V3 → R3 → D1 pin 2 (anode) → D1 pin 1 (cathode) → PC13 (active-low sink)
    [aq_lcd_grab.py]
2026-05-30 pcb: update kicad_pcb after LED polarity fix netlist re-import
    [aq_lcd_grab.kicad_pcb]
2026-05-31 PCB: Sent for fabrication -- v1
2026-06-07 host/decoder: refactor to operate on raw (data, is_data) byte stream
    The decoder no longer depends on BusDecoder or Framebuffer. It does its
    own minimal 8080 framing, accumulates pixels as an RLE hash (FNV-1a 64-bit
    over bg/fg run lengths), and matches completed windows against pre-hashed
    templates — O(1) space per window, ~20-30 hash steps per glyph instead of
    one per pixel.
    build.rs now emits a hash per template instead of a packed-bit mask, with
    a compile-time collision check. The FNV implementation lives in src/fnv.rs
    and is shared between build.rs (via include!) and decoder.rs (as a module)
    so the algorithm can't drift.
    dispatch_event in main.rs feeds each permuted sample to both bu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
    [build.rs, decoder.rs, main.rs]
2026-06-07 host/decoder: fix build.rs pixel iteration order and flush on EOF
    build.rs was walking pixels in image order but computing bg from the
    last pixel (capture-order first), causing a mismatch with the runtime
    which sees pixels in capture order. Fix: iterate pixels.iter().rev()
    to match PendingWindow::push(), which receives pixels in capture order.
    Also flush dirty decoder rows on stream EOF (replay mode) so the final
    settled values are printed before the reader thread exits.
    [build.rs, main.rs]
2026-06-07 host/decoder: add unit tests; emit packed-bit masks from build.rs
    build.rs now emits test_pixels_gen.rs alongside templates_gen.rs.
    Each template gets a TEST_MASK_WxH_LABEL constant (packed-bit, capture
    order) so tests can synthesize bus sequences with arbitrary RGB565
    bg/fg pairs without hardcoding pixel values.
    Tests cover:
    - Single digit decode for 40×61 glyphs (0, 1, 5, blank, dot)
    - Unmatched window returns "#" placeholder
    - Window outside all metric regions is ignored
    - Full TVOC row "0.8" assembled from three consecutive glyph writes
    (two digits + dot), verified via flush()
2026-06-07 decoder: assemble rows by glyph overlap, flush on log events
    Row values were corrupted (e.g. TVOC ".38.3" instead of "3.3") because
    glyph slots accumulated indefinitely: the decimal dot shifts x when the
    value's magnitude changes, leaving a stale dot that never cleared.
    Replace the fixed-x slot model with overlap-based replacement: each slot
    stores (x, width, label), and a new glyph removes only existing slots
    whose x-extent overlaps it before inserting. This mirrors how the panel
    overwrites pixels — the dot sits in the gap between digits and overlaps
    nothing, so it persists, while redrawn digits replace in place. No frame
    resets (the leftmost x isn't stable across magnitude changes).
    Al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
    [lib.rs, main.rs]
2026-06-08 docs: add ESP32-C6 gateway app design plan
    Plan for a standalone ESP32-C6 (esp-hal + Embassy) gateway: receive the
    wire-protocol stream over UART from the STM32/Pico bridge, decode on-chip,
    publish sensor values to Home Assistant over MQTT, and serve the
    reconstructed framebuffer as a palettized BMP over a small HTTP server.
    Reuses the wire/decoder/framebuffer logic (lifted into pure no_std,
    alloc-free shared crates) and the WiFi/MQTT/secrets scaffolding from the
    sibling zappy-esp project.
2026-06-08 wire: add streaming alloc-free decoder + permute; move off host
    Port the wire-format decoder and board permutation out of host/src into
    the no_std `wire` crate. The decoder is now a streaming, allocation-free
    callback API: `Decoder::feed(bytes, |WireEvent| ...)` emits events whose
    variable-length payloads (Block samples, Repeat2 run_lens, Log text)
    borrow from a fixed internal buffer — no Vec/String/alloc. Long Block
    bodies are chunked through a small stack buffer.
    Verified: wire crate tests pass, the crate builds for
    riscv32imac-unknown-none-elf (ESP32-C6), and the host viewer replays
    reference/goodrun/run2.bin to the expected values (pm25=3, tvoc=3.3,
    co2=710, temp=30, humidity=77).
    Co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
    [decoder.rs, lib.rs, main.rs, permute.rs]
2026-06-08 decoder: make pure no_std; replace flush() with flush_each callback
    Add #![no_std] and drop the allocating flush() -> Vec<RowReport> API in
    favour of flush_each(&mut self, f: impl FnMut(&'static str, &str)). The
    metric value (≤ MAX_DIGITS_PER_ROW ASCII chars) is built into a fixed
    stack buffer and handed to the callback as a borrowed &str — no Vec,
    String, or alloc. RowReport is removed.
    The decoder crate now compiles for riscv32imac-unknown-none-elf with no
    allocator. Host emit_rows() switches to the callback; replay of
    reference/goodrun/run2.bin is unchanged (pm25=3, tvoc=3.3, co2=710,
    temp=30, humidity=77).
    [lib.rs, main.rs]
2026-06-08 framebuffer: extract no_std crate with pluggable RGB565/4bpp storage
    Move host/src/framebuffer.rs into a pure no_std, allocation-free crate.
    The framebuffer reconstructs the panel from a (data, is_data) sample
    stream via feed() (its own 8080 framing, mirroring the glyph decoder),
    over a caller-provided pixel buffer.
    Pixel storage is pluggable via PixelStore:
    - Rgb565Store: full 16-bit fidelity (host).
    - Palette4Store: 4 bits/pixel into a fixed 16-entry palette (~75 KiB),
    mapping each written colour to the nearest entry, with a reserved misc
    slot (magenta) for unexpected colours.
    Palette derived from a survey of reference/goodrun/run2.bin: only 7
    colours account for 100% of pixels writt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
    [lib.rs, main.rs]
2026-06-08 firmware-esp32: scaffold ESP32-C6 gateway (WiFi + DHCP)
    New standalone crate modelled on the sibling zappy-esp project: esp-hal
    ~1.0 + Embassy + esp-radio WiFi, targeting riscv32imac-unknown-none-elf.
    Depends on the shared no_std decode crates (wire, decoder, framebuffer).
    This bring-up step brings WiFi up, gets a DHCP lease, and logs the IP.
    secrets.env (gitignored) + build.rs inject WIFI_SSID/PASSWORD and HA_*
    at compile time; see secrets.env.example. UART/decode, HTTP, and MQTT
    tasks follow in later steps.
    Builds and links clean for ESP32-C6 (cargo build --release). Flashing
    needs the physical board (cargo run --release; espflash).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
2026-06-08 firmware-esp32: add UART decode pipeline (Step 5)
    uart_task reads the bridge UART (UART1, RX=GPIO17/TX=GPIO16, 921600 8N1),
    performs the STOP/START handshake, and streams bytes through the shared
    no_std pipeline: wire::Decoder -> permute (f103 by default, pico via
    feature) -> glyph decoder + 4bpp-palette framebuffer.
    - src/lib.rs: shared RowUpdate type, VALUES pubsub, SharedFb mutex alias.
    - src/pipeline.rs: Pipeline drives both decoders per sample and flushes
    settled rows to the values pubsub on each firmware LOG frame (same
    flush points as the host); resyncs the wire decoder on desync.
    - Shared framebuffer backed by a 'static 76 800-byte palette buffer
    (StaticCell); locked per UART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
2026-06-08 firmware-esp32: stream bridge UART over UHCI DMA (fix FifoOverflow)
    The STM32 bridge streams continuously at 921600; the plain 128-byte RX
    FIFO overflowed (FifoOverflowed) and desynced the wire decoder. Switch
    the RX path to UHCI (UART-over-DMA): a free-running 16 KiB DMA ring that
    the task drains at its own pace by polling available_bytes()/pop() — the
    same "DMA fills, poll the tail" pattern as the capture firmware.
    Drops the START/STOP handshake (the bridge is already streaming; the wire
    decoder resyncs on a clean frame boundary). Verified on hardware: live
    values decode cleanly with no overflows.
    [main.rs]
2026-06-08 firmware-esp32: send START to bridge via UHCI TX (fix no-stream)
    The STM32 bridge boots Stopped and only streams after START. The earlier
    attempt wrote START on the plain UART before Uhci::new(), but the UHCI
    reconfigure clobbered the TX before the bytes left the wire, so the
    bridge never started.
    Fix: keep the UHCI-split TX (uart_tx) and send STOP/START from uart_task
    after the DMA RX ring is armed. Verified on hardware: rx bytes climb,
    values decode (co2/pm25/tvoc/temp/humidity), zero overruns/desyncs.
    Adds an rx-byte heartbeat log for diagnosing the capture link.
    [main.rs]
2026-06-08 firmware-esp32: bump embassy-net to 0.9, add picoserve 0.18
    picoserve 0.18 (for a proper HTTP server with keep-alive + Content-Length)
    requires embassy-net 0.9. esp-radio talks to the stack via the
    version-agnostic embassy-net-driver 0.2 trait, so moving our stack to
    embassy-net 0.9 is compatible — builds clean and WiFi/TCP still work
    (the hand-rolled HTTP uses embassy_net::tcp unchanged for now).
    Next: swap the hand-rolled HTTP handler for picoserve.
2026-06-08 firmware-esp32: serve framebuffer over HTTP via picoserve (Step 6)
    Replace the hand-rolled embassy-net HTTP handler with picoserve: HTTP/1.1
    keep-alive, correct Content-Length, and routing. GET / returns an
    auto-refreshing HTML page (served as text/html via a small Html Content
    wrapper — &str defaults to text/plain), GET /fb.bmp streams the
    framebuffer as a 24-bit BMP generated on the fly in chunks (no 460 KiB
    buffer). A 2-worker pool keeps a listener free for the browser's
    overlapping connections.
    The framebuffer handle is published to handlers via a module static
    (set_fb) so the picoserve router stays stateless (State = ()), keeping
    the router type nameable as picoserve::AppRouter<AppPr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
    [http.rs, lib.rs, main.rs]
2026-06-08 firmware-esp32: 4bpp palettized BMP, fix orientation, faster transfer
    - Serve a 4-bit indexed BMP instead of 24-bit: the panel uses ≤16 colours
    and the framebuffer already stores 4bpp indices, so the image drops from
    ~460 KiB to ~75 KiB (6×) — near-memcpy + a 16-entry colour table.
    framebuffer gains bmp4_header()/bmp4_pixels() (+ test).
    - Fix upside-down image: emit a top-down BMP (negative height) so the
    reversed (180°-rotated) pixel order renders upright; the 24-bit path is
    switched to top-down too.
    - Throughput: write the body in 2 KiB chunks and grow the TCP TX +
    picoserve http buffers to 8 KiB each. tcpdump showed 2 KiB bursts with
    multi-ms gaps between flushes; bigg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
    [http.rs, lib.rs, main.rs]
2026-06-08 firmware-esp32: show decoded values on the web page
    Add a GET /values endpoint returning the latest decoded readings as JSON
    (e.g. {"pm25":"6","tvoc":"0.1","co2":"586","temp":"26","humidity":"55"}),
    and render them in the index page next to the framebuffer image with
    units, polling once a second.
    The pipeline now records each flushed row into a shared LatestValues
    snapshot (a Mutex'd fixed array keyed by ROW_NAMES) in addition to the
    consume-once VALUES pubsub, so HTTP can sample the current state on
    demand. http::set_shared publishes both fb + latest to the handlers.
    [http.rs, lib.rs, main.rs, pipeline.rs]
2026-06-08 firmware-esp32: publish decoded values to Home Assistant via MQTT (Step 7)
    mqtt_task connects to the HA broker (plaintext 1883, HA_USER/HA_TOKEN),
    publishes retained MQTT discovery configs for the 5 sensors (pm25 µg/m³,
    tvoc ppm, co2 ppm, temp °C, humidity %) grouped under one "Air Quality"
    device, then streams values from the VALUES pubsub. State topics live
    under aq/<name>; discovery under homeassistant/sensor/aq/<name>/config —
    both within the broker ACL (readwrite aq/#, write homeassistant/+/aq/#).
    Reconnects on any error.
    - Publish only on change (dedup per row): the pipeline re-flushes a row
    every panel repaint, so without dedup we'd spam the broker + HA
    recorder with identic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
    [lib.rs, main.rs, mqtt.rs]
2026-06-11 firmware-esp32: log timestamps + MQTT keepalive/poll loop
    - Enable esp-println's `timestamp` feature with a `_esp_println_timestamp`
    hook (ms since boot from embassy-time), so log lines carry a timestamp.
    - MQTT: drive client.poll() so incoming packets (PINGRESP, broker control
    traffic) are read instead of backing up the RX and getting dropped; send
    a periodic ping (30 s) within the 60 s keepalive; raise the TCP socket
    timeout above the ping interval so the connection doesn't idle-close
    between publishes. The publish/ping/poll arms run under one select3.
    [main.rs, mqtt.rs]
2026-06-14 firmware-stm32: drive PIC32 reset low on STOP, release on START
    Park the PIC32 in reset (PA11 → R16 → MCLR, open-drain, asserted low)
    while STOPPED, release it on START. Every capture session now begins
    with a guaranteed fresh PIC32 power-on init sequence — including the
    screen-clear fill — landing inside the capture window, instead of
    depending on manually timing a monitor restart against START.
    PA11 is open-drain because the MCLR net has a pull-up on the target
    main board: low actively asserts reset, high goes high-Z and the
    pull-up releases. Held low at boot so the target stays parked until
    the first START.
    [main.rs]
2026-06-14 host: add --headless flag to run capture without the egui window
    Runs the reader loop on the main thread, printing the decoded log to
    stdout, and skips eframe entirely. For scripted / no-window capture
    during firmware iteration.
    [main.rs]
2026-06-18 firmware-esp32: mirror UART console to web page via SSE log stream
    Add a tee logger (logger.rs) that forwards every log record to
    esp-println and also appends it to a 4 KiB ring buffer. The HTTP
    server gains a GET /log-stream SSE endpoint that drains the ring
    line-by-line and pushes each line as a `log` event. The index page
    adds a Console panel fed by EventSource; the LCD image now fills the
    full viewport height and the log panel matches that height with its
    own scroll.
2026-06-18 firmware-esp32: add HTTP OTA with Ed25519 signature verification
    Two 1.5 MB OTA slots (no factory partition) replace the single app slot.
    POST /ota streams the firmware binary + 64-byte Ed25519 signature to the
    inactive slot; the handler verifies sign(SHA-512(firmware)) using a public
    key baked in from secrets.env before activating and rebooting. Signing
    uses pure Ed25519 (openssl pkeyutl over the hash) since OpenSSL does not
    support Ed25519ph. Also prints build timestamp + git commit on boot and
    bumps HTTP_WORKERS to 4 to avoid connection exhaustion with SSE open.
    [partitions.csv]
2026-06-18 firmware-esp32: fix OTA sig scheme, stack overflow, reboot race, build time
    - Fix Ed25519 mismatch: OpenSSL only supports pure Ed25519, not Ed25519ph;
    sign SHA-512(firmware) as a 64-byte message and verify with verify_strict()
    - Fix stack overflow: move 4 KiB OTA chunk buffer and SHA-512 hasher to
    statics (guarded by the FLASH mutex) to keep them off the worker stack
    - Fix reboot race: send 200 response before software_reset(); set
    OTA_REBOOTING flag to reject any concurrent upload during the 500 ms drain
    - Fix tail erase OutOfBounds: FlashRegion bounds-checks both endpoints
    strictly inside the partition, pass partition_size-1 as exclusive end
    - Fix HTTP_WORKERS=4 to avoid connection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
    [build.rs, http.rs, main.rs]
2026-06-29 Fix malformed MQTT payloads with '#' characters and add 72h reboot timer
    - Drop unmatched glyphs instead of inserting '#' placeholder. When a glyph's
    hash doesn't match any template, the window is simply dropped, preventing
    malformed values like '##10' or '0.1#' from reaching MQTT. Clean values
    now reach Home Assistant and InfluxDB for graphing.
    - Add periodic 72-hour reboot to clear any accumulated state in the long-running
    MQTT + HTTP + WiFi stack.
    [lib.rs, main.rs, reboot.rs]
2026-06-29 Add 5-minute malformed data watchdog to MQTT task
    Detect and log malformed sensor values (leading 0 without dot, # chars,
    double spaces). If bad data persists for 5 minutes, trigger a reboot to
    reset decoder state. Clears watchdog when data recovers.
    Malformation checks:
    - Contains '#' (unrecognized glyph)
    - Contains ' ' (gap between digits)
    - Starts with '0' and no '.' and len > 1 (leading zero)
    [mqtt.rs]
2026-06-29 Fix watchdog to scan all sensors periodically, not per-update
    The previous watchdog only checked a value when it changed (after the
    last[idx] dedup), and used a single shared timer across all sensors. Two
    failure modes meant it would rarely fire:
    - A value stuck bad (e.g. steady '##95') publishes once, then every
    identical update is deduped away before the check, so the timer never
    re-evaluates and never fires.
    - The shared timer was disarmed by any one good sensor, so a single clean
    sensor would reset the countdown for a still-broken one.
    Move the check to the ping tick (every 30s) and scan the whole last[]
    snapshot: arm if ANY sensor is malformed, disarm only when ALL are clean,
    re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
    [mqtt.rs]
2026-07-05 Fix "0 3" decode: value is the digit run right of the last blank
    /values showed pm25 = "0 3" — a real leading digit, a blank, then the
    actual value. When a wide reading (e.g. "103") shrinks to a narrow one
    ("3"), the panel right-aligns the new number and paints a `blank` over the
    vacated column, but a digit further LEFT than that blank is never repainted,
    so its slot is never overlap-removed. Assembly then held [stale, blank, 3].
    `.trim()` only strips edge whitespace, so an interior blank became a space
    ("0 3") and the stale leading digit survived. Instead, take the current
    value as the rightmost contiguous run of digit/dot slots: find the last
    blank slot and assemble from the slot after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
    [lib.rs]
2026-07-05 Show git commit/build time in web UI; portrait-friendly phone layout
    - Add a fixed-position footer showing GIT_COMMIT + BUILD_TIMESTAMP (both
    already compile-time env vars) via concat!/env!, so the running firmware
    version is visible on the page without the serial console — makes it easy
    to confirm an OTA actually took.
    - Add the viewport meta tag (phones otherwise render at desktop width) and a
    portrait media query: stack the panel image + values on top and let the
    console fill the rest below, instead of the cramped 3-column row.
    [http.rs]
2026-07-05 Debounce MQTT publishes to drop mid-update panel transients
    The panel updates its digits one at a time, so during a change like
    605 -> 599 the display transiently reads an intermediate value (e.g. 505,
    when only the hundreds digit has flipped). Those transients were published
    straight to Home Assistant, polluting the recorder.
    Hold a changed value back until it has stayed stable for 500ms before
    publishing. Staging happens on each update (First); a fourth select branch
    wakes on the earliest pending deadline and publishes every settled value.
    If a value bounces back to what was last published before the timer fires,
    the pending change is cancelled. The watchdog still scans last[] (published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
    [mqtt.rs]
2026-07-05 sign_ota.sh: show upload progress bar; treat post-200 reset as success
    - Add curl --progress-bar for a live upload meter (previously curl suppressed
    the meter because a response body was expected). Response body is routed to
    stderr so it doesn't garble the bar.
    - Stop using `curl -f`. On a successful OTA the device resets immediately after
    replying, dropping the socket before curl finishes reading the response, so
    curl exits non-zero and set -e aborted the script — making a *successful*
    flash look like a failure ("crashed during OTA"). Instead capture the parsed
    HTTP status via -w: 200 is success even if the connection then dropped;
    anything else is a real error and exits 1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
2026-07-05 sign_ota.sh: disable Expect: 100-continue (likely cause of OTA 400)
    curl adds "Expect: 100-continue" for POST bodies >1KB and waits for the
    server to send "100 Continue" before transmitting the body. picoserve
    doesn't emit that interim response, so curl stalls then sends anyway, and
    the device's streaming body read can see a truncated/empty body and return
    400 with a valid, correctly-sized signed image. Send `-H "Expect:"` to drop
    the header so the body goes immediately.
2026-07-05 Portrait web UI: full-width image, scrollable page with console below fold
    The previous portrait layout capped the image at 45vh to fit everything on
    one non-scrolling screen, leaving the panel image small. Instead let the
    page scroll: image goes full width at natural aspect ratio, values below it,
    console below that.
    - html,body height:auto + body overflow-y:auto so content defines page
    height and the page scrolls.
    - img width:100% (drop the 45vh cap).
    - #log gets a fixed 60vh height with flex:none — flex:1 collapses to ~0 once
    the body is height:auto instead of a bounded flex column.
    [http.rs]
2026-08-18 docs: fix REPEAT2 field labels — val_a/val_b are each full samples
    The tag=0x03 byte-layout diagram labelled the two u32 header words
    [a_lo a_hi pa_lo pa_hi] / [b_lo b_hi pb_lo pb_hi], which reads as if
    pa and pb were split across val_a and val_b. They are not: each of
    val_a and val_b is a complete sample in the same pa | pb << 16 layout
    as a tag=0x01 sample, as the encoder, decoder, and host permute() all
    already treat them. Doc-only change; no code affected.
2026-09-16 Support multiple Wi-Fi networks, tried in order
    The SSID/password were baked in as a single pair, so moving the device
    between networks meant a rebuild and a USB reflash — and once off its
    network there is no OTA path back.
    secrets.env now takes numbered pairs (WIFI_SSID_1/WIFI_PASSWORD_1, _2,
    ...) which build.rs collects into a generated WIFI_NETWORKS table.
    wifi_task sets the config per attempt and advances on failure, so a
    network that is out of range falls through to the next one. The retry
    index persists across disconnects, so a drop retries the network that was
    working before trying the others, and the 5 s backoff applies only after
    a full pass has failed — failover stays quick wi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
    [build.rs, main.rs]
2026-09-16 Raise read_request timeout so OTA survives a weak link
    An OTA upload over a marginal Wi-Fi link failed partway with
    "OTA: read error at byte 647168", leaving the device on its old image.
    read_request bounds a single body read, so it caps the whole OTA upload.
    The 835 KB image ran at ~5.3 KiB/s (~155 s needed) on a -67 dBm link and
    hit the 120 s deadline mid-stream — the device log showed the read
    failing at exactly 120.0 s. The same upload took ~53 s once the link
    improved, confirming the timeout rather than the transfer was the limit.
    Raise it to 300 s for ~2x headroom. This still bounds a dead peer, and
    the other timeouts are untouched: start_read_request (10 s) and
    persistent_start_re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
    [http.rs]
2026-09-16 Make the MQTT topic prefix and device name configurable
    Topics, uniq_ids and the HA device id were hardcoded to `aq`, and the
    MQTT client id to `aq_lcd`, so a second unit on the same broker would
    overwrite the first's entities and fight it for the client id — a broker
    drops the existing session when a second client connects with the same
    id, so the two would disconnect each other in a loop.
    AQ_ID (topic prefix, discovery node_id, uniq_id prefix, HA device id) and
    AQ_NAME (HA display name) now come from secrets.env, and the client id
    derives from AQ_ID. The five hand-written Sensor entries collapse into a
    `sensor!` macro that assembles each discovery payload with concat!, so
    they stay &'st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
    [mqtt.rs]
2026-09-30 pcb: v2 — fix WR/CS swap on flex pins 22/24
    The SKiDL pin map still carried the early probed pinout (22 = WR,
    24 = CS); the module datasheet (docs/display_notes.md) has 22 = CS,
    24 = WR. v1 therefore clocks TIM2_ETR (PA0) with CS instead of WR.
    - aq_lcd_grab.py / .net / route_lcd_bus.py: swap pins 22 and 24.
    - kicad_pcb: move the PA0/PA5 tap vias across the pin-22/24 columns,
    mirror the In2.Cu kinks of DC/P21/P25 around the new via spots,
    refill zones, relabel silkscreen v1 -> v2. DRC clean.
    - pcb_spec.md: correct pinout table; add "v1 errata" describing the
    bodge wire (J2 "CS" pad -> U1 pin 10/PA0) for built v1 boards.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
    [aq_lcd_grab.kicad_pcb]
